egormeister02/Ultrasonic-LNS/diploma_final_hardware.md

# Финальная аппаратная конфигурация системы УЗ навигации БПЛА

Документ содержит итоговый вариант схемотехники с учётом закупленных компонентов. Данные предназначены для обновления соответствующих разделов дипломной работы.

---

## Закупленные компоненты

| # | Компонент | Корпус | Кол-во | Назначение |
|---|---|---|---|---|
| 1 | SN74HC4066N (TI) | DIP-14 | — | Аналоговые ключи (4 шт в корпусе), управление УЗ сигналом и активным гашением |
| 2 | LM311P (TI) | DIP-8 | — | Компаратор с гистерезисом для детектора ToF |
| 3 | INA128P (TI) | DIP-8 | 2 | Инструментальный ОУ, предусилитель сигнала с пьезоприёмника, ×50 |
| 4 | (дубликат INA128P) | DIP-8 | — | — |
| 5 | Электролит 10 мкФ × 35В | THT 5×7 мм | — | Развязка по питанию шин ±12В на якорях |
| 6 | Электролит 100 мкФ × 35В | THT 6.3×12 мм | — | Входной фильтр питания на якоре |
| 7 | EC24-100K | THT аксиальный | — | Дроссель 10 мкГн ±10%, выходные LC фильтры после DC-DC |
| 8 | EC24-101K | THT аксиальный | — | Дроссель 100 мкГн ±10%, входной LC фильтр |
| 9 | Д9Б | THT | — | Германиевый диод для детектора огибающей (низкое падение ~0.2В) |
| 10 | A2412S-2WR3 (Mornsun) | модуль | — | Изолированный DC-DC: вход 21.6–26.4В → выход ±12В, 83 мА на шину, 2 Вт |
| 11 | DWM1000 | модуль | 2 | UWB трансивер (один на БПЛА, один на земле) — синхронизация с таймстампом 15 пс |
| 12 | Керамика 100 нФ | THT/SMD | 40 | Развязка по питанию микросхем + ВЧ фильтрация |
| 13 | Ферритовое кольцо | — | 4 | По одному на якорь, на провод 24В для подавления ВЧ помех от инверторов |

**Изменения относительно предыдущих обсуждений:**
- Вместо голого DW1000 выбран модуль **DWM1000** — после проверки выяснилось что GPIO5/EXTTXE в нём выведен на внешние контакты, что делает голый чип ненужным
- Выбран **A2412S-2WR3** (2 Вт версия) — даёт запас по току 83 мА на каждую шину
- Компаратор **LM311** (200 нс) вместо обсуждавшегося LM393 (1.3 мкс) — лучше быстродействие
- Германиевый **Д9Б** для детектора огибающей — падение 0.2В против 0.6В у кремниевого

---

## Архитектура системы — итог

### Узел БПЛА
ESP32 генерирует УЗ сигнал 25 кГц с OOK модуляцией. DWM1000 обеспечивает синхронизацию с землёй: пин **GPIO5/EXTTXE** аппаратно открывает аналоговый ключ на путь УЗ сигнала к драйверу. Джиттер синхронизации между UWB пакетом и началом УЗ импульса < 10 нс.

### Узел земли (центральный)
ESP32 с DWM1000 принимает синхросигнал, фиксирует таймстамп с точностью 15 пс. Через проводные линии получает сигналы от 4 якорей-приёмников. Вычисляет координаты БПЛА методом трилатерации.

### Якоря (4 шт)
Каждый якорь — независимая плата с пьезоприёмником, усилителем, детектором огибающей и компаратором. Питание подаётся по экранированному кабелю с центрального узла.

---

## Узел БПЛА — финальная схема

### Цепь генерации и излучения

```
ESP32 GPIO (25 кГц непрерывно, OOK биты)
       │
       ├──→ Логика управления ключами (на базе SN74HC4066)
       │
       │   Ключ 1: пропускает 25 кГц на вход A драйвера во время бита 1
       │   Ключ 2: закорачивает вход B драйвера на GND во время бита 0
       │           (активное гашение остаточных колебаний пьезо)
       │
       │   Общее разрешение обоих ключей: EXTTXE от DWM1000
       │
       └──→ Драйвер TC4427A
              │
              └──→ УЗ излучатель MA40S4S (25 кГц)

DWM1000
   ├── SPI ←── ESP32 (конфигурация Delayed TX)
   ├── GPIO5/EXTTXE ──→ разрешающий сигнал для SN74HC4066
   └── UWB антенна (встроена) ──→ синхросигнал к земле
```

### Логика управления ключами SN74HC4066

В корпусе четыре ключа, используются два:

- **Ключ 1** управляющий вход = (EXTTXE) AND (бит_OOK)  → пропускает 25 кГц
- **Ключ 2** управляющий вход = (EXTTXE) AND (NOT бит_OOK) → закорачивает излучатель на GND во время бита 0

Реализация AND/NOT: либо отдельной логикой (74HC08, 74HC04), либо вычислением сигнала программно в ESP32 и подачей готового сигнала на управляющий вход.

Подтяжка управляющих входов неиспользуемых ключей 3 и 4 к GND через резисторы 10 кОм — гарантия закрытого состояния.

### Развязка по питанию узла БПЛА

- **100 нФ керамика** возле каждой ИС (ESP32, DWM1000, SN74HC4066, TC4427A) на каждой шине питания
- **Электролит 10 мкФ** на 3.3В шине рядом с ESP32 и DWM1000

---

## Узел якоря — финальная схема питания

### Входная цепь

Экранированный кабель от центра несёт +24В и общую землю. Экран кабеля заземляется только на стороне центра (одностороннее заземление — исключает земляные петли).

```
+24В ──→ Ферритовое кольцо (2-3 витка провода) ──→ EC24-101K (100 мкГн)
                                                          │
                                                  ┌───────┴───────┐
                                                  │               │
                                            Электролит      Керамика
                                            100 мкФ × 35В   100 нФ
                                                  │               │
                                                  ┴               ┴
                                                 GND             GND
                                                  │
                                                  └──→ Вход +Vin DC-DC A2412S-2WR3
```

### Изолированный DC-DC A2412S-2WR3

Параметры модуля:
- Вход: **21.6–26.4 В DC** (номинал 24В)
- Выход: **±12 В DC**, **83 мА** на каждую шину (всего 2 Вт)
- Изоляция: **1500 В DC** между входом и выходом
- Назначение: гальваническая развязка усилителя от шины питания платформы (защита от наводок 400В дизель-генератора и инверторов)

### Выходные LC фильтры после DC-DC

Назначение — подавить собственный коммутационный шум DC-DC (~100 кГц).

**На шине +12В:**
```
+12В выход DC-DC → EC24-100K (10 мкГн) → +12В на ОУ
                                              │
                                       ┌──────┴──────┐
                                       │             │
                                 10 мкФ × 35В   100 нФ
                                       │             │
                                       ┴             ┴
                                  GND_изол       GND_изол
```

**На шине −12В:**
Аналогично, но электролит 10 мкФ ставится с инвертированной полярностью (плюс к GND, минус к шине −12В).

### Развязка по питанию каждой ИС якоря

На якоре расположены: 1× INA128, 2× TL072, 1× LM311, плюс детектор огибающей (пассивный).

**INA128 + 2× TL072 (питание ±12В):**
- 100 нФ керамика между +12В и GND_изол — рядом с пинами 7 (V+) каждой ИС
- 100 нФ керамика между −12В и GND_изол — рядом с пинами 4 (V−) каждой ИС
- Итого 6 керамик на развязку аналоговой части

**LM311 (питание +5В):**
- 100 нФ керамика между +5В и GND_лог рядом с пином 8

### Земля якоря — топология

Две изолированные земли:
- **GND_изол** — выходная земля DC-DC, общая для INA128 и обоих TL072
- **GND_лог** — земля логической части (компаратор LM311 и линия передачи в центр), питание от отдельного линейного стабилизатора 7805

Соединение: GND_изол и GND_лог соединяются **в одной точке** рядом с компаратором (звёздная топология). Эта точка соединяется с GND центра одним проводом.

Цель: исключить замкнутые контуры по земле через которые могут течь паразитные токи.

### Стабилизатор +5В для логики

7805 от шины +24В (та же что идёт на DC-DC). На якоре питает только LM311 и опционально дифференциальный передатчик линии связи с центром.

---

## Усилитель приёмника — компонентная схема

### Каскад 1: предусилитель INA128P

Инструментальный ОУ с настраиваемым коэффициентом усиления. Коэффициент задаётся одним внешним резистором RG между пинами 1 и 8:

**G = 1 + 50000/RG**

Для G = 50: RG = 50000/49 = **1.02 кОм** (стандартный 1 кОм даёт G = 51).

Питание ±12В, развязочные керамики 100 нФ на пинах 4 и 7. Опорный пин 5 (REF) на GND_изол.

### Каскад 2 и 3: усилители на TL072

Два каскада, каждый на одном из ОУ внутри TL072 (в корпусе 2 ОУ). Коэффициент каждого ×10. На входах RC фильтры:

- Каскад 2: RC ФНЧ ~23 кГц (граничная частота ниже 25 кГц)
- Каскад 3: RC ФВЧ ~27 кГц (граничная частота выше 25 кГц)

Совместно они образуют грубый полосовой фильтр на 25 кГц. Реальное усиление каждого каскада с учётом потерь в фильтре ~×5. Суммарное усиление цепи: 50 × 5 × 5 = ×1250 (~62 дБ).

### Детектор огибающей

После усилителя:
```
Выход TL072 ──→ Д9Б (анод к выходу) ──→ узел детектирования
                                              │
                                       ┌──────┴──────┐
                                       │             │
                                  R = 10 кОм    C = 1 нФ
                                       │             │
                                       ┴             ┴
                                  GND_изол      GND_изол
```

Постоянная времени τ = RC = 10 мкс — оптимальна для частоты 25 кГц (период 40 мкс). Огибающая следует за реальным нарастанием сигнала ~0.2 мс без размытия.

Использование Д9Б (германий) даёт падение всего ~0.2В против 0.6В у кремниевого диода — выигрыш чувствительности на слабых сигналах.

### Компаратор LM311P с гистерезисом

Подключение по схеме инвертирующего компаратора с гистерезисом:
- Инвертирующий вход (пин 2): сигнал с детектора огибающей
- Неинвертирующий вход (пин 3): опорное напряжение через делитель + резистор гистерезиса с выхода
- Выход (пин 7): открытый коллектор, нужен pull-up 4.7 кОм на +5В
- Питание: +5В на пине 8, −12В или GND на пине 4 (LM311 работает с однополярным 5В)

Гистерезис ~5–10 мВ создаётся резистором обратной связи ~1 МОм с выхода (пин 7) на неинвертирующий вход (пин 3).

Порог срабатывания — 10–20% от максимальной амплитуды огибающей. Подбирается экспериментально для каждого якоря.

---

## Цепь от компаратора до центрального узла ESP32

Сигнал с компаратора передаётся в центр одним из двух способов:

**Простой:** прямая передача по экранированному кабелю если расстояние небольшое.

**Помехоустойчивый:** дифференциальный передатчик (например AM26C31 или транзисторная пара) → витая пара → дифференциальный приёмник на стороне центра. Подавление синфазных наводок 60–80 дБ.

Центральный ESP32 фиксирует таймстамп прихода сигнала от каждого якоря по фронту. Использовать GPIO в режиме прерывания на Core 1 (выделенное ядро).

---

## Параметры и характеристики системы (по результатам испытаний)

- **Дальность УЗ канала:** не менее 34 м (испытано в коридоре 2×3 м — наихудший акустический случай с многократными переотражениями)
- **Сигнал на выходе усилителя при 34 м:** 1–2 В (питание ±12В даёт достаточный размах)
- **Время нарастания фронта:** ~0.2 мс
- **Время затухания с переотражениями:** 10–15 мс (определяет минимальный период между измерениями)
- **Максимальная частота измерений:** 60–100 Гц (на открытом пространстве ожидается выше)
- **Точность таймстампа UWB синхросигнала:** 15 пс (DWM1000)
- **Джиттер синхронизации УЗ ↔ UWB:** < 10 нс (за счёт аппаратного управления EXTTXE)
- **Точность ToF, ограниченная джиттером:** < 0.3 мм (на порядки лучше чем точность по фронту)
- **Точность позиционирования в плане:** определяется GDOP геометрии якорей и точностью детектирования фронта (~7 см для одиночного измерения), может быть улучшена усреднением

---

## Ключевые проектные решения

### 1. Аппаратная синхронизация через EXTTXE
ESP32 не способен с наносекундной точностью одновременно стартовать УЗ генератор и UWB передачу — между двумя командами всегда есть программный джиттер 1–5 мкс. Решение: ESP32 предварительно настраивает DWM1000 на Delayed TX, в нужный момент DWM1000 сам аппаратно поднимает EXTTXE, который через SN74HC4066 открывает путь УЗ сигнала. Момент старта УЗ и момент UWB передачи жёстко связаны железом.

### 2. Активное гашение пьезоизлучателя
Пьезо имеет высокую механическую добротность — после прекращения возбуждения колеблется ~400 мкс. Это создаёт мёртвую зону и ухудшает разделение бит OOK. Решение: во время бита 0 закорачивать излучатель через драйвер (один канал TC4427A в высоком импедансе, второй замыкает на GND). Реализуется вторым ключом SN74HC4066.

### 3. Изолированный DC-DC на якорях
Платформа имеет 400В дизель-генератор и инверторы — мощные источники широкополосных наводок. Длинные провода до якорей работают как антенны для этих наводок. Решение: изолированный DC-DC A2412S-2WR3 на каждом якоре полностью развязывает аналоговую землю усилителя от шины питания платформы. Изоляция 1500В отсекает наводки гальванически — это качественно надёжнее любой фильтрации.

### 4. Детектор переднего фронта огибающей
Прямое детектирование начала УЗ сигнала затруднено его плавным нарастанием и маскированием шумом. Эхо приходит позже (через несколько мс) и должно игнорироваться. Решение: полосовой фильтр 25 кГц → детектор огибающей (Д9Б + RC) → компаратор LM311 с гистерезисом по фиксированному порогу. Срабатывание происходит на переднем фронте огибающей — до прихода эхо. Систематическая ошибка от зависимости порога от расстояния калибруется и в GDOP не входит.

### 5. Двухкаскадная развязка питания
Помехоустойчивость обеспечивается на двух уровнях:
- **Грубый уровень** — феррит + LC фильтр на входе 24В якоря
- **Изоляция** — DC-DC A2412S-2WR3 (главная защита)
- **Точная фильтрация** — LC фильтры на выходах ±12В после DC-DC
- **Локальная** — керамика 100 нФ возле каждой ИС

---

## Результаты лабораторных испытаний и применимость

В лабораторных условиях (без генератора, без длинных кабелей) система продемонстрировала уверенный приём УЗ сигнала на дистанции 34 м в неблагоприятных акустических условиях коридора-волновода 2×3 м. Амплитуда сигнала после усилителя 1–2 В обеспечивает надёжное срабатывание компаратора с большим запасом по соотношению сигнал/шум.

В полевых условиях с дизель-генератором ожидается некоторое ухудшение из-за электромагнитных наводок, но выбранная архитектура питания с изолированным DC-DC и многоуровневой фильтрацией спроектирована именно под эти условия. Дополнительная отладка может потребоваться в части подбора порога компаратора и проверки эффективности экранирования сигнальных линий.
