egormeister02/Ultrasonic-LNS/images/damper_555.pdf

+5 В

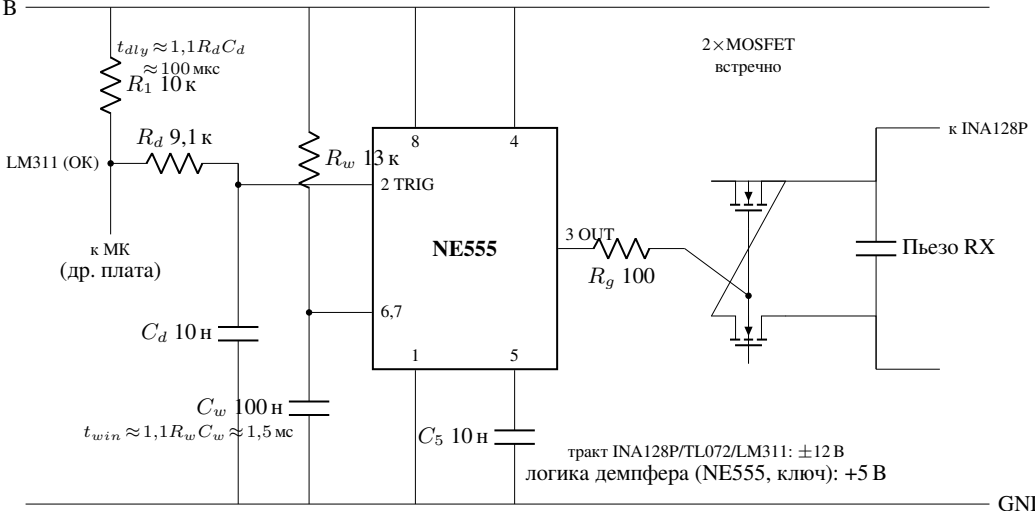
[picture p7: figure]
к МК (др. плата); tdly ≈1,1RdCd ≈100 мкс; 2 TRIG; 3 OUT; twin ≈1,1RwCw ≈1,5 мс; 2×MOSFET; встречно; Пьезо RX; к INA128P; тракт INA128P/TL072/LM311: ±12 В логика демпфера (NE555, ключ): +5 В

## GND
