egormeister02/Ultrasonic-LNS/include/title-page.tex

\begin{center}
    %% *название института*
    \large\textbf{Министерство науки и высшего образования Российской Федерации\\
    Московский физико-технический институт\\
    (национальный исследовательский университет)} \\
    \vspace{1cm}

    %% *факультет/физтех-школа*
    Физтех-школа радиотехники и компьютерных технологий \\

    %% *название базовой кафедры и лаборатории*
    Лаборатория № 69 «Разработка теоретических основ и методов\\
    практической реализации локальных навигационных систем\\
    привязных высотных беспилотных платформ»\\

    \vspace{3em}

    Выпускная квалификационная работа бакалавра
\end{center}

\begin{center}
    \vspace{\fill}
    %% *название вашей работы*
    \LARGE{\input{include/work-title.tex}}

    \vspace{\fill}
\end{center}

\begin{flushright}
    \textbf{Автор:} \\
    Студент группы \underline{\hspace{2.5cm}} \\ % TODO: укажите номер группы
    Смирнов Егор Ильич \\
    \vspace{2em}
    \textbf{Научный руководитель:} \\
    д.\,т.\,н., профессор \\
    Вишневский Владимир Миронович \\
\end{flushright}

\vspace{7em}

\begin{center}
    %% *лого*
    \\
    Москва \the\year{}
\end{center}

%% выключаем отображение номера для этой страницы (титульник)
\thispagestyle{empty}
