egormeister02/Ultrasonic-LNS/include/work-title.tex

% Единое место для указания названия работы
Ультразвуковая локальная навигационная система для привязного беспилотного летательного аппарата
