egormeister02/Ultrasonic-LNS/main.pdf

Федеральное государственное автономное образовательное учреждение высшего образования
«Московский физико-технический институт (национальный исследовательский университет)» Физтех-школа Радиотехники и Компьютерных Технологий Кафедра инфокоммуникационных систем и сетей

Направление подготовки / специальность: 03.03.01 Прикладные математика и физика Направленность (профиль) подготовки: Радиотехника и компьютерные технологии

СРАВНИТЕЛЬНЫЙ АНАЛИЗ ВАРИАНТОВ ПОСТРОЕНИЯ ЛОКАЛЬНОЙ НАВИГАЦИОННОЙ СИСТЕМЫ ПРИВЯЗНЫХ ВЫСОТНЫХ БЕСПИЛОТНЫХ ТЕЛЕКОММУНИКАЦИОННЫХ ПЛАТФОРМ

(бакалаврская работа)

Студент:
Смирнов Егор Ильич

_________________________
(подпись студента)

Научный руководитель:
Вишневский Владимир Миронович, д-р техн. наук, проф.

_________________________
(подпись научного руководителя)

Консультант (при наличии): _________________________
_________________________
(подпись консультанта)

Москва 2026

Powered by TCPDF (www.tcpdf.org)

Ультразвуковая локальная навигационная система для привязного беспилотного летательного аппарата

Смирнов Егор Ильич

Аннотация

В работе разработана ультразвуковая локальная навигационная система для определения координат привязного беспилотного летательного аппарата (БПЛА) относительно наземной платформы (в том числе подвижной) в условиях недоступности или ненадёжности глобальных навигационных спутниковых систем. Расстояния до опорных узлов (якорей) измеряются по времени распространения ультразвукового сигнала; временная синхронизация передающей и приёмной сторон выполняется по сверхширокополосному (UWB) радиоканалу, а координаты восстанавливаются методом трилатерации.
Построена математическая модель системы: оценены максимальная дальность работы, погрешность определения скорости звука во влажном воздухе, влияние геометрии якорей (GDOP) и проведён сравнительный анализ аналитического метода трилатерации и метода Гаусса–Ньютона. Разработана и собрана аппаратная часть: передающий узел БПЛА (ESP32-S3 + DWM1000 с аппаратной синхронизацией по сигналу EXTTXE), тракт обработки сигнала якоря (INA128P, TL072CN, детектор огибающей, компаратор LM311P) и изолированная система питания с защитой от наводок; реализован двухимпульсный метод самокалибровки времени прихода. Экспериментально подтверждён уверенный приём на дистанции ≈34 м; расчётная погрешность позиционирования — порядка 5 см.

Abstract

This work develops an ultrasonic local navigation system that estimates the position of a tethered unmanned aerial vehicle (UAV) relative to a (possibly mobile) ground platform under conditions where global navigation satellite systems are unavailable or unreliable. Distances to reference nodes (anchors) are measured from the time of flight of an ultrasonic signal; the transmitter and receiver are time-synchronized over an ultra-wideband (UWB) radio link, and the position is recovered by trilateration.
A mathematical model of the system is built: the maximum operating range, the error of the speed-of-sound estimate in humid air, and the influence of anchor geometry (GDOP) are evaluated, and an analytic trilateration method is compared with the Gauss–Newton method. The hardware is designed and assembled: the UAV transmitter node (ESP32-S3 + DWM1000 with hardware EXTTXE synchronization), the anchor signal-processing chain (INA128P, TL072CN, envelope detector, LM311P comparator) and an isolated, interference-protected power supply; a twopulse time-of-arrival self-calibration method is implemented. Reliable reception at ≈34 m is confirmed experimentally; the estimated positioning error is on the order of 5 cm.

Содержание

1 Введение | 6
2 Постановка задачи | 8
3 Обзор существующих решений | 10
4 Исследование и построение решения задачи | 15
4.4.1 | Аналитическое решение задачи трилатерации в про-
5 Описание практической части | 33
5.1.3 | Управление мостом и активное гашение пьезоизлучателя 36

5.2.4 | Самокалибровка времени прихода: двухимпульсный
5.2.5 | Бюджет случайной ошибки измерения дальности . . . | 43
5.3.1 | Изолированный преобразователь A2412S-2WR3 . . . . | 45
5.5 Результаты экспериментальной проверки приёмного тракта . . | 50
6 Заключение | 51

### 1 Введение

Надёжная локальная навигация является одним из ключевых условий безопасной и устойчивой работы беспилотных летательных аппаратов (БПЛА) в стеснённых пространствах и в условиях ухудшенного или отсутствующего приёма сигналов глобальных навигационных спутниковых систем (GNSS, в том числе ГЛОНАСС). Даже в случае привязного летательного аппарата, когда полёт механически ограничен тросом, задача точного и быстрого определения координат остаётся критичной: она необходима для стабилизации и компенсации внешних возмущений (ветер, натяжение троса), а также для реализации режимов удержания позиции и сопровождения объектов. Это особенно важно для БПЛА, несущих на себе телекоммуникационное оборудование: область покрытия и возможность передачи сигнала напрямую зависят от положения летательного аппарата [1].
На практике применяются различные подходы к локализации БПЛА: спутниковая навигация (в том числе дифференциальные и RTK-решения), визуальные и визуально-инерциальные методы, лидарная одометрия, инфраструктурные системы захвата движения. Каждый из них имеет свою область применимости и свои ограничения; подробное сравнение этих подходов применительно к рассматриваемой задаче приведено в разделе 3. Ультразвуковая навигация представляет собой привлекательный вариант для задач ближнего радиуса действия благодаря низкой стоимости, малому энергопотреблению и доступности компактных излучателей и приёмников. В таких системах положение объекта оценивается по времени распространения акустического сигнала между передатчиками и приёмниками с последующим пересчётом временных измерений в расстояния на основе величины скорости звука. В зависимости от архитектуры могут применяться схемы измерения времени распространения сигнала (ToF — от англ. Time of Flight), разности времён прихода (TDoA — от англ. Time Difference of Arrival) или их комбинации с геометрическими методами трилатерации и мультилатерации. В отличие от чисто бортовых методов измерения, ультразвуковые системы позволяют опираться на внешние опорные узлы (якоря) и могут сохранять работоспособность даже в тех условиях, где оптика даёт сбои. Вместе с тем ультразвуковое позиционирование имеет ограничения: сравнительно малую дальность и чувствительность к отражениям сигнала от поверхностей.

В настоящей работе рассматривается задача локальной навигации привязного БПЛА относительно платформы (в том числе потенциально подвижной) с использованием ультразвуковых измерений в качестве основного источника координатной информации. Ставится цель разработать систему, пригодную для практической реализации, обосновать её основные параметры математической моделью и подтвердить работоспособность экспериментально.

### 2 Постановка задачи

### 2.1 Объект и цель

Рассматривается привязной БПЛА, удерживаемый тросом над наземной платформой. Платформа может быть как стационарной, так и подвижной, поэтому положение аппарата требуется определять в системе координат, связанной с платформой. Целью работы является разработка локальной навигационной системы, которая в реальном времени определяет трёхмерные координаты БПЛА относительно платформы по ультразвуковым измерениям и сохраняет работоспособность в условиях, где спутниковая навигация недоступна или ненадёжна.
Формально требуется по набору измерений построить оценку вектора координат p = (x,y,z) аппарата в платформенной системе отсчёта, обеспечив заданные дальность, точность и частоту обновления оценки.

### 2.2 Требования к системе

На основе условий эксплуатации сформулированы следующие требования к разрабатываемой системе.

1. Принцип измерения. Координаты определяются по расстояниям от аппарата до нескольких опорных узлов (якорей) с известной геометрией; расстояния вычисляются по времени распространения ультразвукового сигнала. Это требует общей шкалы времени для передающей и приёмной сторон, то есть синхронизации.
2. Рабочая дальность. Целевая дальность измерений — 40–50 м между аппаратом и якорями; протокол синхронизации проектируется с запасом — на дистанции до 100 м.
3. Точность. Требуемая погрешность определения координат — порядка единиц сантиметров, что достаточно для стабилизации аппарата и удержания позиции.
4. Частота обновления. Темп выдачи координат должен соответствовать динамике аппарата; для привязного БПЛА с ограниченной скоростью движения достаточно частоты порядка 10 Гц, при этом приёмный тракт не должен ограничивать эту величину.
5. Условия эксплуатации. Система работает в зоне прямой видимости якорей, в том числе в стеснённых пространствах с многократными переотражениями сигнала, и в непосредственной близости от силового оборудования платформы (дизельный электрогенератор, инверторы 400 В), создающего сильные электромагнитные помехи. Требуется устойчивость к переотражениям и к наводкам по цепям питания и сигнальным линиям.
6. Подвижность платформы. При возможных наклонах платформы система должна позволять пересчёт координат с учётом её ориентации (наличие инерциального датчика на платформе).
7. Стоимость и энергопотребление. Решение должно строиться на доступной и недорогой элементной базе с малым энергопотреблением и не требовать развёртывания дорогостоящей внешней инфраструктуры.

Перечисленные требования служат критериями при оценке существующих решений (раздел 3) и при построении предлагаемой системы (раздел 4).

### 3 Обзор существующих решений

Ниже рассмотрены основные подходы к локализации БПЛА и оценивается степень их соответствия требованиям, сформулированным в разделе 2: работоспособность в отсутствие GNSS, сантиметровая точность на дистанциях в десятки метров, низкая стоимость и независимость от дорогостоящей инфраструктуры.

### 3.1 Спутниковая навигация (GNSS, RTK)

Спутниковые системы (GPS, ГЛОНАСС и др.), в том числе дифференциальные и RTK-решения, обеспечивают абсолютные координаты на открытой местности и при хорошей видимости созвездия дают сантиметровую точность [2, 3]. Однако их точность и доступность существенно снижаются вблизи сооружений, внутри помещений, в городской застройке и при загрязнённом радиоэфире — то есть именно в тех условиях, для которых разрабатывается рассматриваемая система. Кроме того, GNSS определяет координаты в глобальной системе отсчёта, тогда как для привязного аппарата требуется положение относительно платформы, которая сама может перемещаться. Поэтому спутниковая навигация не удовлетворяет требованию работы в условиях недоступности GNSS и плохо подходит для относительной локализации.

### 3.2 Визуальные и визуально-инерциальные методы

Оптический поток, визуальная одометрия и визуально-инерциальные системы (VIO) способны обеспечивать высокую точность относительного позиционирования [4]. Их недостатки — зависимость от освещённости, текстуры сцены и динамики окружения, а также значительные вычислительные затраты, что затруднительно для бортового оборудования БПЛА с ограниченным энергобюджетом. В однородных или слабоосвещённых сценах точность резко падает. Эти методы дополняют, но не заменяют систему внешних маяков, когда требуется гарантированная точность относительно платформы.

### 3.3 Лидарная одометрия

Лидарная одометрия отличается высокой информативностью и точностью построения карты [5], однако чувствительна к погодным условиям (туман, осадки, пыль), требует дорогостоящего датчика и существенных вычислительных ресурсов, а также наличия геометрических особенностей в сцене. Для лёгкого привязного аппарата масса, стоимость и энергопотребление лидара являются серьёзными ограничениями.

### 3.4 Системы захвата движения (motion capture)

Инфраструктурные системы захвата движения обеспечивают субмиллиметровую точность [6], но применимы только в специально оборудованных зонах, требуют развёртывания сети камер и калибровки и потому неприменимы в полевых условиях и противоречат требованию независимости от дорогостоящей инфраструктуры.

### 3.5 Радиочастотная дальнометрия (UWB)

Сверхширокополосные (UWB) радиосистемы позволяют измерять расстояния по времени распространения радиосигнала и широко используются для локализации внутри помещений [7]. Их точность — порядка единиц– десятков сантиметров, что само по себе близко к требуемой. Однако высокая скорость распространения радиоволн предъявляет крайне жёсткие требования к разрешению измерения времени (пикосекундный масштаб): ошибка в 1 нс соответствует ∼30 см дальности. При этом, как показано ниже, радиоканал оказывается исключительно полезен не как измеритель дальности, а как средство синхронизации ультразвуковой подсистемы.

### 3.6 Ультразвуковое позиционирование

В ультразвуковых системах расстояние определяется по времени распространения акустического сигнала. Низкая скорость звука (∼340 м/с против скорости света) на пять с лишним порядков снижает требования к точности измерения времени: для миллиметрового разрешения по дальности достаточно измерять время с точностью порядка единиц микросекунд, что доступно недорогим микроконтроллерам. Известны как схемы измерения времени пролёта (ToF), так и схемы разности времён прихода (TDoA), для которых существуют эффективные методы решения задачи локализации [8, 9]. Ультразвуковые излучатели и приёмники компактны, дёшевы и энергоэффективны. Ограничения метода — сравнительно малая дальность и чувствительность к переотражениям — управляемы при работе в зоне прямой видимости и временном кодировании сигнала.

### 3.7 Вывод

Сопоставление подходов с требованиями раздела 2 показывает, что наилучшим компромиссом для относительной локализации привязного БПЛА в GNSS-недоступной среде является ультразвуковое измерение дальности (низкая стоимость, малое энергопотребление, умеренные требования к измерению времени, сантиметровая точность на нужных дистанциях). Ключевая трудность ультразвуковой ToF-схемы — необходимость общей шкалы времени передатчика и приёмника — решается синхронизацией по UWB-радиоканалу, который обеспечивает точную временную привязку без жёстких требований к собственно радиочастотной дальнометрии. Именно такая архитектура — ультразвуковая дальнометрия с радиочастотной синхронизацией — положена в основу предлагаемого решения (раздел 4).

### 3.8 Существующие ультразвуковые системы локализации

Сделанный выше выбор в пользу ультразвукового измерения дальности делает уместным обзор существующих ультразвуковых систем локализации и сопоставление с ними предлагаемого решения. Ультразвуковая локализация изучается и применяется не одно десятилетие; систематический обзор технологий внутреннего позиционирования приведён, например, в [10]. Ниже рассмотрены три показательные системы — две исследовательские и одна коммерческая.
Active Bat (AT&T Laboratories Cambridge) [11] использует подвижную метку-излучатель и сетку ультразвуковых приёмников на потолке: по временам пролёта сигнала до приёмников методом мультилатерации вычисляется трёхмерное положение с точностью около 3 см (в 95% измерений ошибка не превышает 9 см). Запуск измерения и временная привязка выполняются по отдельному радиоканалу. Система точна, но требует плотной потолочной инфраструктуры приёмников и ограничена объёмом помещения.
Cricket (MIT) [12] строится на маяках, одновременно излучающих радио- и ультразвуковой импульс; приёмник определяет расстояние до маяка по разности времён прихода этих сигналов. Архитектура децентрализована — положение вычисляет сам приёмник; точность составляет единицы сантиметров на дистанции в несколько метров, дальность одного маяка — единицы метров. Система распространялась как относительно открытая платформа, но давно не развивается.
Коммерческие системы. Среди серийных решений наиболее известна Marvelmind Robotics [13]: стационарные ультразвуковые маяки, объединённые радиоканалом диапазона 868/915 МГц, с заявленной точностью порядка ±2 см и рабочими дистанциями между маяками до ∼30 м. Применяются и другие проприетарные системы позиционирования реального времени (Sonitor, Hexamite). Коммерческие системы — законченные продукты с многолетней эксплуатацией, однако их внутренняя реализация (алгоритмы дальнометрии, обработки сигнала и синхронизации) закрыта.

Таблица 1: Сравнение ультразвуковых систем локализации

Система | Точность | Дальность | Синхр. | Реализация
Active Bat | ∼3 см | помещение | радио | прототип
Cricket | ∼2 см | единицы м | РЧ + УЗ | открытая (устар.)
Marvelmind | ±2 см | до ∼30 м | 868/915 МГц | закрытая
Данная работа ∼5 см (расч.) | до ∼40 м | UWB | открытая

Перечисленные системы ориентированы преимущественно на работу внутри помещений и опираются на распределённую по среде инфраструктуру маяков или приёмников, достигая сантиметровой точности (сводка — таблица 1). Рассматриваемая в настоящей работе задача отличается сценарием: относительная навигация привязного БПЛА над компактной (потенциально подвижной) платформой на дистанциях в десятки метров, причём все якоря размещены на самой платформе, а не разнесены по среде. Компактная база якорей повышает геометрическое ослабление точности (GDOP, см. раздел 4), поэтому расчётная точность положения (∼5 см) несколько уступает сантиметровому уровню инфраструктурных систем — это плата за отказ от стационарной инфраструктуры. Вклад работы носит инженерный характер: открытая, воспроизводимая реализация (схемотехника, прошивка, математическая модель) для указанного сценария, с синхронизацией ультразвуковой подсистемы по UWB-радиоканалу. Превосходства над существующими системами по точности работа не предполагает.

### 4 Исследование и построение решения задачи

### 4.1 Архитектура предлагаемого решения

Рассматриваемая система состоит из привязного БПЛА и наземной платформы, на которой размещается ультразвуковая опорная подсистема. Платформа может быть стационарной или мобильной, поэтому все измерения и вычисления выполняются в системе координат, связанной с платформой, а при необходимости учитываются её наклоны.
В базовой конфигурации на платформе устанавливаются несколько ультразвуковых опорных узлов (далее — якоря), разнесённых на максимально возможное расстояние друг от друга. Геометрия якорей считается известной: координаты каждого якоря заранее задаются в системе координат платформы. В принятой конфигурации ультразвуковой излучатель размещается на БПЛА, а якоря служат приёмниками; излучатель ориентирован в сторону платформы и работает в зоне прямой видимости опорных узлов.


Рис. 1: Общая схема системы локальной навигации привязного БПЛА относительно платформы

Принцип работы системы следующий. Опорные узлы на платформе и бортовой узел на БПЛА формируют набор измерений времени распространения акустических импульсов. По измеренным временам вычисляются расстояния до якорей, после чего координаты БПЛА определяются методом трилатерации в системе координат платформы.
Для получения корректных расстояний требуется синхронизация времени между передающей и принимающей сторонами. В привязном варианте синхронизирующий сигнал может быть передан по кабелю-тросу; в настоящей работе применяется радиосинхронизация по UWB-каналу (раздел 5).
Если платформа подвержена наклонам, на ней размещается инерциальный датчик (например, акселерометр/IMU), позволяющий оценивать ориентацию платформы относительно горизонта и при необходимости пересчитывать координаты из платформенной системы координат в требуемую внешнюю систему отсчёта.
Дальнейшие подразделы строят математическую модель системы: оценивают предельную дальность, погрешность измерения расстояния и координат, а также сравнивают методы решения задачи трилатерации.

### 4.2 Максимальная дальность работы

Под дальностью работы нужно понимать максимальное расстояние между излучателем и приёмником, при котором приёмник может стабильно детектировать сигнал. Это расстояние зависит от нескольких факторов:

- мощность излучателя;
- чувствительность приёмника;
- уровень шума в среде;
- затухание звукового сигнала в среде.

Остановимся подробнее на затухании звука. Интенсивность звука убывает с расстоянием как

I(x) = I0 · 10⁻αx/10
, | (1)

где α — коэффициент затухания, дБ/м.

Согласно стандарту ISO 9613-1:1993 [14], коэффициент затухания рассчитывается по формуле

α = 8.686 · f

2
·

[︃
1.84 · 10⁻¹¹
·

pr
pa

·

(︂
T
Tr

)︂0.5

+

(︂
T
Tr

)︂−2.5
·

(︃
0.01275 · e

−2239.1/T

fr,O +

f

2

fr,O

+

0.1068 · e

−3352.0/T

fr,N +

f

2

fr,N

)︃ ]︃

(2)
где:
- α — коэффициент затухания, дБ/м;
- f — частота звука, Гц;
- pa — атмосферное давление, кПа;
- pr = 101.325 кПа — опорное давление;
- T — температура воздуха, К;
- Tr = 293.15 К — опорная температура;
- fr,O — частота релаксации кислорода, Гц;
- fr,N — частота релаксации азота, Гц.

Частоты релаксации рассчитываются по формулам

fr,O =

pa
pr

(︂
24 + 4.04 · 10⁴ℎ

0.02 + ℎ
0.391 + ℎ

)︂
, | (3)

fr,N =

pa
pr

(︂
T
Tr

)︂−1/2

(︃

9 + 280 · ℎ · exp (︃

−4.170 [︃(︂
T
Tr

)︂−1/3
− 1

]︃)︃)︃ , (4)

где ℎ — молярная концентрация водяного пара:

ℎ = ℎr ·

psat
pa
. | (5)

Здесь ℎr — относительная влажность, psat — давление насыщенного пара, которое рассчитывается по формуле

psat = pr · 10⁻⁶.8346·(

T01
T )

1.261
+4.6151
, | (6)

где T01 = 273.16 К — температура тройной точки воды.
По формуле (2) видно, что коэффициент затухания прямо пропорционален квадрату частоты f. Поэтому для обеспечения максимальной дальности частоту необходимо выбирать как можно ниже.
Для текущей системы была выбрана частота 25 кГц: она достаточно низкая для обеспечения дальности и при этом находится вне слышимого диапазона.
Расчёт для этой частоты даёт максимальную дальность порядка 35 м (оценка по порядку величины). Вычисления производились при следующих параметрах:
- относительная влажность — 50%;
- температура воздуха — 20 ∘C;
- уровень звукового давления излучателя — 105 дБ (SPL — Sound Pressure Level, на расстоянии 1 м от источника);
- чувствительность УЗ-приёмника — −95 дБ.

Следует подчеркнуть, что это оценка по порядку величины: реальная дальность существенно зависит от конкретной реализации системы и внешних условий, а входные параметры (SPL, чувствительность) известны лишь приближённо. Протокол синхронизации (раздел 5.4) рассчитан с дополнительным запасом — на дистанции до 100 м.

### 4.3 Точность измерения расстояния

Расстояние от БПЛА до якоря измеряется следующим образом: в известный момент времени излучатель на БПЛА испускает сигнал. Спустя некоторое время приёмник на якоре его детектирует. Так как микроконтроллеры на излучателе и приёмнике синхронизированы, время, которое потребовалось для передачи сигнала, известно. Умножив его на скорость звука, получим искомое расстояние.
Значение мы получаем с определённой погрешностью; разобьём её на части (рис. 2).


Рис. 2: Ошибка при определении расстояния

### 4.3.1 Скорость звука

Для определения расстояния нам необходимо знать скорость звука. Именно ошибка при вычислении скорости вызывает систематическую ошибку в определении расстояний.
Скорость звука c в газе является термодинамической величиной. Для влажного воздуха в приближении идеальной газовой смеси её можно оценить по выражению

c =

√︀
γ Rmix T , | (7a)

Rmix =

R

Mmix

, | (7b)
Mmix = (1 − xv) Md + xv Mv, | (7c)

xv =

pv
p
, | (7d)
pv = ℎ psat(T), | (7e)
psat(T) = 611.21 exp(︂
17.502 (T − 273.15)
T − 32.19 | )︂
, | (7f)

γ =

cp,mix

cv,mix

=

cp,mix

cp,mix − Rmix

, | (7g)
cp,mix = (1 − xv) cp,d(T) + xv cp,v(T). | (7h)

Выражения (7) основаны на работе [15]. Здесь psat(T) вычисляется по формуле Тетенса в параметризации Бака [16], применимой в диапазоне −20 . . . 50 ∘C.

После подстановки всех промежуточных величин в (7) получается явное выражение c как функции трёх измеряемых параметров (T, p, ℎ):

c(T,p,ℎ) = √︃
cp,mix(T,p,ℎ) R T
Mmix(T,p,ℎ)

[︀
cp,mix(T,p,ℎ) − R/Mmix(T,p,ℎ)
]︀, | (8)

где мольная доля пара и производные от неё величины имеют вид

xv(T,p,ℎ) = ℎ psat(T)
p

,

Mmix(T,p,ℎ) = Md + xv(T,p,ℎ) (Mv − Md),

cp,mix(T,p,ℎ) = cp,d + xv(T,p,ℎ) (cp,v − cp,d),

cp,d ≈ 1005 J/(kg · K), cp,v ≈ 1850 J/(kg · K).

Обозначения, используемые в (7), приведены в табл. 2.

Таблица 2: Обозначения в модели скорости звука во влажном воздухе

Обозначение Значение | Единицы
c | скорость звука | м/с
T | абсолютная температура | K
p | общее давление | Pa
ℎ | относительная влажность (0 . . . 1) | –
xv | мольная доля водяного пара | –
pv | парциальное давление пара | Pa
psat(T) | давление насыщенного пара | Pa
R | универсальная газовая постоянная (8.314462618) J/(mol · K)
Md | молярная масса сухого воздуха (0.0289652) | kg/mol
Mv | молярная масса воды (0.01801528) | kg/mol
Mmix | молярная масса смеси | kg/mol
Rmix | удельная газовая постоянная смеси | J/(kg · K)
cp,d(T) | теплоёмкость сухого воздуха при p = const | J/(kg · K)
cp,v(T) | теплоёмкость водяного пара при p = const | J/(kg · K)
cp,mix | теплоёмкость смеси при p = const | J/(kg · K)
cv,mix | теплоёмкость смеси при V = const | J/(kg · K)
γ | показатель адиабаты смеси | –

Погрешность измерения параметров среды. Для расчёта скорости звука по формулам (7) требуются значения температуры T, давления p и относительной влажности ℎ. В реальной системе эти параметры измеряются датчиками, что вносит дополнительную погрешность в определение скорости звука.

В качестве датчика рассмотрим:

- BME280 [17] (температура, давление, влажность): погрешность температуры ±0.5

∘C, погрешность давления ±1.2 hPa (±120 Pa), погрешность

влажности ±3%.

Погрешность модели. Погрешность модели Δмод определяется совокупностью приближений, использованных при выводе формул (7). Рассмотрим составляющие:

1. Приближение идеального газа. Уравнения (7) основаны на модели идеального газа. Реальные свойства воздуха описываются вторыми вириальными коэффициентами. Согласно анализу Cramer [15], учёт нелинейности уравнения состояния вносит поправку порядка 10⁻⁴ (∼
0.03 м/с). Принимаем Δид ≈ 0.05 м/с с запасом.
2. Упрощение теплоёмкостей. В формулах (7) теплоёмкости cp,d и cp,v принимаются постоянными. На самом деле они зависят от температуры. При изменении температуры от 0 до 40 ∘C относительное изменение

cp,d составляет около 0.1%, что даёт погрешность скорости звука Δcp ≈ 0.3 м/с.

3. Формула Тетенса. Для расчёта давления насыщенного пара psat(T) используется формула Тетенса [16], применимая в диапазоне −20 . . . 50 ∘C

с относительной погрешностью менее 0.5%. Влияние на скорость звука незначительно: ΔТетенс ≈ 0.01 м/с.

4. Физические константы. Универсальная газовая постоянная R и молярные массы Md, Mv известны с точностью лучше 10⁻⁵
(CODATA), их
вклад пренебрежимо мал.

Полная погрешность модели по закону накопления погрешностей:

Δмод =

√︁
Δ²

ид + Δ²

cp + Δ²
Тетенс =

√︀
0.05² + 0.30² + 0.01² ≈ 0.31 m/s. (9)

Полная погрешность скорости звука. Погрешность определения c складывается из погрешностей измерения параметров и погрешности модели:

Δc =

√︃(︂
∂c
∂T ΔT

)︂2
+

(︂
∂c
∂pΔp

)︂2
+

(︂
∂c
∂ℎΔℎ

)︂2
+ Δ²
мод. | (10)

Для оценки частных производных при околонормальных условиях (T ≈ 293 K, p ≈ 101325 Pa, ℎ ≈ 0.5) получаем:

∂c
∂T
≈ 0.60 m/(s · K), | (11)

∂c
∂p
≈ −4.7 · 10⁻⁴ m/(s · Pa), | (12)

∂c
∂ℎ
≈ 0.08 m/s. | (13)

Подставляя погрешности датчиков BME280 (ΔT = 0.5 K, Δp = 120 Pa, Δℎ = 0.03) и Δмод = 0.31 м/с:

ΔcT = 0.60 · 0.5 = 0.30 m/s, | (14)
Δcp = 4.7 · 10⁻⁴
- 120 ≈ 0.06 m/s, | (15)
Δcℎ = 0.08 · 0.03 ≈ 0.002 m/s. | (16)

Полная погрешность:

Δc =

√︀
0.30² + 0.06² + 0.002² + 0.31² ≈

√
0.186 ≈ 0.43 m/s. (17)

Таким образом, при использовании датчиков среднего класса точности полная погрешность определения скорости звука составляет около ±0.43 m/s (∼ ±0.13%). Основной вклад вносят погрешность измерения температуры (∼ 70%) и погрешность модели (∼ 52%); влияние давления и влажности значительно меньше.
Проверка по табличным данным. Для верификации оценки погрешности модели выполним сравнение расчётного значения скорости звука с табличными данными при стандартных условиях (сухой воздух, T = 273.15 K, p = 101325 Па, ℎ = 0).
По формулам (7) при ℎ = 0 получаем xv = 0, Mmix = Md, Rmix = R/Md, γ = cp,d/(cp,d − Rmix), откуда

cрасч =

√︂
γ

R
Md

T =

√︂
1.402 ·

8.314
0.028965
- 273.15 ≈ 331.3 m/s. (18)

Табличное значение скорости звука в сухом воздухе при 0

∘C и нор-

мальном атмосферном давлении согласно [18] составляет cтабл = 331.29 м/с. Разница между расчётным и табличным значениями:

Δcпроверка = |cрасч − cтабл| ≈ |331.3 − 331.29| = 0.01 m/s. | (19)

Полученное расхождение (∼ 0.003%) значительно меньше оценённой погрешности модели Δмод ≈ 0.31 м/с, что подтверждает корректность оценки с запасом. Разница объясняется округлениями констант в расчёте и не учтённым влиянием реальных свойств газа (вторые вириальные коэффициенты), которое как раз и даёт основной вклад в Δмод.
Выводы. Проведённый анализ показал, что при использовании недорогих датчиков типа BME280 основная погрешность определения скорости звука (∼ 0.43 м/с) определяется погрешностью измерения температуры (0.30 м/с) и погрешностью модели (0.31 м/с). Проверка по табличным данным подтвердила, что оценка погрешности модели является консервативной (завышенной), что приемлемо для инженерных расчётов.

### 4.3.2 Точность измерения времени

Расстояние определяется по интервалу времени между общей меткой (приём UWB-кадра) и детектированием ультразвукового импульса. Поскольку часы передающей и приёмной сторон синхронизированы, это время одностороннего распространения, и ошибка дальности связана с ошибкой времени соотношением
Δd = c Δt. | (20)

Коэффициент c ≈ 343 м/с задаёт масштаб перевода (табл. 3).
Квантование таймера пренебрежимо. Само измерение времени выполняется аппаратно: момент приёма UWB-кадра фиксируется таймером DWM1000 с разрешением 15 пс, а фронт компаратора якоря защёлкивается аппаратным модулем захвата (MCPWM CAP) с разрешением 12,5 нс

Таблица 3: Перевод ошибки времени в ошибку дальности (Δd = c Δt)

Δt | Δd
1 мкс 10 мкс 100 мкс 1000 мкс | 0.34 мм 3.4 мм 34 мм 34 см

(c Δt ≈ 4 мкм). Квантование таймера, таким образом, в бюджет ошибки практически не входит.
Источник случайной ошибки. Доминирующий вклад в случайную ошибку даёт джиттер определения самого момента прихода. Характерной точкой прихода служит начало роста огибающей; огибающая нарастает за конечное время фронта τфр ≈ 0,2 мс (измерено, см. раздел 5.5), а её положение восстанавливается по зашумлённым отсчётам нарастающего участка (двухимпульсный метод, раздел 5.2.4). Для определения времени по фронту джиттер оценивается отношением шума к крутизне фронта:

σt ≈

σV
|dV/dt|

≈

τфр
SNR, σd = c σt ≈

c τфр
SNR, | (21)

где SNR = Vmax/σV — отношение амплитуды огибающей к СКО шума, а c τфр ≈ 69 мм. При наблюдаемом отношении сигнал/шум подробный бюджет случайной ошибки (раздел 5.2.5) даёт σd ≈ 3 мм (значение принято с запасом; на пределе дальности, где SNR падает, оценка близка к 4 мм). Зависящая от амплитуды (а значит, от дальности) систематическая часть этой задержки устраняется двухимпульсной самокалибровкой (раздел 5.2.4); остаётся именно случайный джиттер.

Итоги.

- систематическая ошибка — ∼0,13% (погрешность скорости звука);
- случайная ошибка — σd ≈ 3 мм (подробный бюджет — раздел 5.2.5).

### 4.3.3 Точность определения координат

При трилатерации в трёхмерном пространстве точность определения координат зависит не только от точности измерения расстояний до якорей, но и от их геометрического расположения. Данный эффект описывается коэффициентом геометрического ослабления точности (GDOP — Geometric Dilution of Precision) [2, 3].
Коэффициент GDOP характеризует влияние геометрии расположения якорей на распространение случайных ошибок измерения расстояний в ошибку оценки координат. В рамках линейной модели оценивания с нулевым средним ошибок измерений GDOP определяет ковариацию оценки координат. Систематические ошибки приводят к смещению оценки и не описываются коэффициентом GDOP [19, 20].
Постановка. Рассмотрим четыре якоря, расположенные в вершинах квадрата в плоскости z = 0:
A1(+a/2, + a/2, 0), | A2(−a/2, + a/2, 0),
A3(−a/2, − a/2, 0), | A4(+a/2, − a/2, 0).

Объект находится в точке P(0, 0, H) на высоте H над центром квадрата. Измеренные расстояния до якорей:

di =

√︀
(x − xi)

2 + (y − yi)

| 2 + (z − zi) 2 + εi ,

где εi — случайная ошибка измерения с дисперсией σ

| 2 d .

Матрица Якоби. Линеаризуем уравнения в окрестности истинной позиции. Пусть D =

√︀
a

2/2 + H² — расстояние от объекта до каждого якоря. Матрица Якоби имеет вид:

J =

⎛

⎜⎜⎜⎜⎝

+

a
2D +

a
2D −

H
D
−

a
2D +

a
2D −

H
D
−

a
2D −

a
2D −

H
D
+

a
2D −

a
2D −

H
D

⎞

⎟⎟⎟⎟⎠

Вычисление J

T J. Благодаря симметрии расположения якорей матрица

J

T J является диагональной:

J

T
J =

⎛

⎜⎝

a

2
D² | 0 | 0
0
| a
| 2
| D² | 0
0 | 0 | 4H²
| | D²

⎞

⎟⎠ .

Ковариационная матрица и GDOP. В рамках метода наименьших квадратов ковариационная матрица оценки координат определяется выражением [20, 19]:
Σ = σ

2
d

(J

T
J)

−1

Отсюда:

Σ = σ

2
d

⎛

⎜⎝

D²
a
2 | 0 | 0
0 | D² a
| 2 | 0
0 | 0 | D² 4H²

⎞

⎟⎠ .

Среднеквадратичная ошибка положения (PDOP — Position Dilution of Precision) определяется как

σxyz =

√︀
tr(Σ) = σd

√︂
2D²
a

2

+

D²
4H²

Подставляя D² =

a

2
2 + H²
, получаем:

σxyz = σd · D ·

√︂
2
a

2

+

1
4H²

где:

- σxyz — среднеквадратичная ошибка положения, м;
- σd — СКО измерения расстояния до якоря, м;
- D =

√︀
a

2/2 + H² — расстояние до якоря, м;

- a — расстояние между якорями, м;
- H — высота объекта, м.

Геометрический фактор. При H ≫ a вертикальное слагаемое под корнем пренебрежимо мало по сравнению с горизонтальным, и выражение сводится к

σxyz ≈

√
2

D
a

σd = G σd, G =

√
2

D
a

,

где G — коэффициент геометрического ослабления точности. Для рабочей конфигурации (a = 2 м, H = 25 м) G ≈ 18: ошибка положения в G раз превышает ошибку измерения дальности. Раздельно по осям горизонтальная составляющая доминирует (σx = σy =

D
a

σd ≈ 12,5 σd), а вертикальная мала

(σz =

D
2H

σd ≈ 0,5 σd): объект находится почти над центром базы, поэтому измеренные дальности хорошо определяют высоту и слабо — горизонтальное смещение. Компактная база (малое a) увеличивает G, поэтому сантиметровая точность положения требует миллиметровой точности измерения дальности. Случайная ошибка измерения дальности. СКО измерения дальности σd определяется бюджетом случайных погрешностей приёмного тракта (раздел 5.2.5): после устранения систематического смещения двухимпульсной калибровкой остаточная ошибка складывается в основном из джиттера компаратора и составляет σd ≈ 3 мм. Это значение используется в расчётах ниже.
На рис. 3 представлена зависимость ошибки позиционирования от взаимного расположения якорей при фиксированной ошибке измерения σd = 3 мм и высоте объекта H = 25 м.

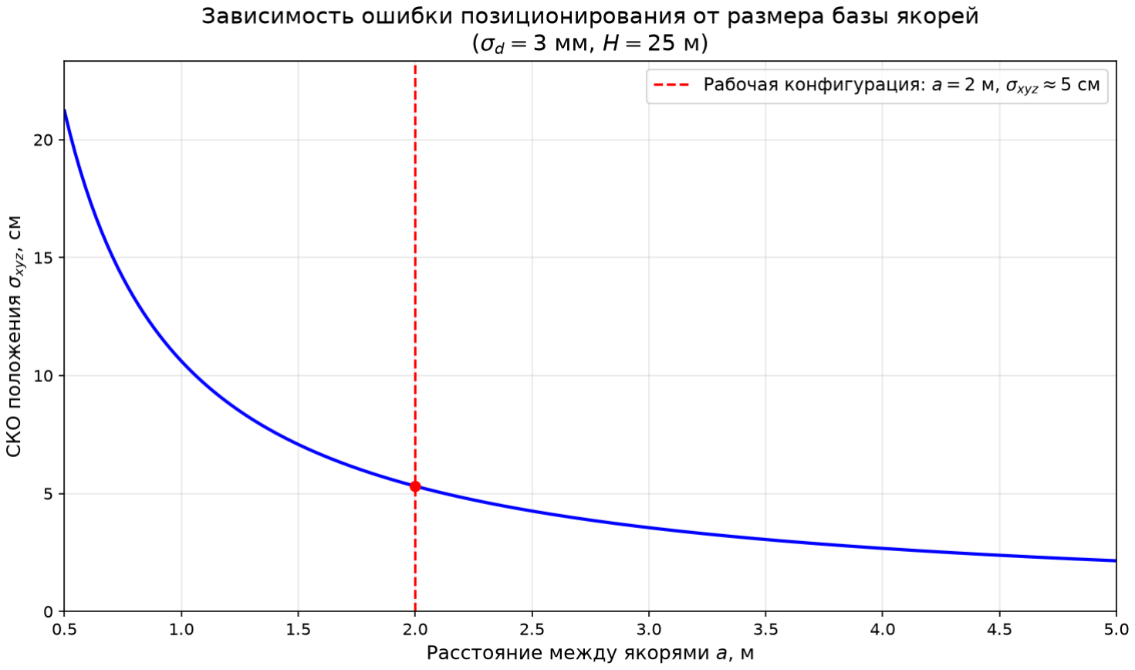
[picture p15: figure]

Рис. 3: Зависимость ошибки позиционирования от геометрии расположения якорей

Оценка погрешности. Рассмотрим характерные параметры системы: высота объекта H = 25 м, расстояние между якорями a = 2 м. В этом случае:

- систематическая ошибка измерения расстояния приводит к смещению оценки порядка 3 см;
- случайная ошибка измерений с учётом эффекта GDOP приводит к СКО порядка 5 см.

Таким образом, суммарная ошибка позиционирования в худшем случае может достигать порядка 8 см.

### 4.4 Методы решения задачи трилатерации

Для получения координат БПЛА при известных расстояниях до якорей необходимо решить задачу трилатерации. Для её решения в настоящей работе рассмотрены два метода: аналитический и вычислительный метод Гаусса– Ньютона. В экспериментах оба метода дали практически идентичную точность, поэтому предпочтение отдано аналитическому методу как вычислительно более простому (замкнутое решение без итераций).

### 4.4.1 Аналитическое решение задачи трилатерации в пространстве по

трём расстояниям

Задача определения координат по трём известным расстояниям имеет замкнутое решение через пересечение трёх сфер [21].
Пусть заданы три опорные точки в плоскости z = 0:
P1 = (x1, y1, 0), | P2 = (x2, y2, 0), | P3 = (x3, y3, 0),

и измеренные расстояния от неизвестной точки P = (x,y,z) до них:

| r1, r2, r3.

### 1. Уравнения сфер. Координаты точки P удовлетворяют системе уравнений

трёх сфер:
(x − xi)

2 + (y − yi)

| 2 + z 2 = r
| 2 i
| , | i = 1,2,3.

### 2. Получение линейной системы для координат x и y. Вычтем уравнения

для i = 2 и i = 3 из уравнения для i = 1. Так как член z

| | 2 присутствует во всех

трёх уравнениях, он сокращается. Получаем:

2(x2 − x1)x + 2(y2 − y1)y = r

2
1 − r

2
2 + x

2
2 − x

2
1 + y

2
2 − y
2/1, | (22)

2(x3 − x1)x + 2(y3 − y1)y = r

2
1 − r

2
3 + x

2
3 − x

2
1 + y

2
3 − y
2/1. | (23)

В матричной форме:

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
2(x2 − x1) 2(y2 − y1)
2(x3 − x1) 2(y3 − y1)

)︃
,

b1 = r

2
1 − r

2
2 + x

2
2 − x

2
1 + y

2
2 − y
2/1, b2 = r

2
1 − r

2
3 + x

2
3 − x

2
1 + y

2
3 − y
2/1.

Если опорные точки не коллинеарны, то det A ̸= 0, и система имеет единственное решение:
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
### 3. Определение координаты z. После нахождения x и y подставим их в

первое уравнение сферы:

z

2 = r

2
1 − (x − x1)

2 − (y − y1)

2

Отсюда:
z = ±

√︁
r

2
1 − (x − x1)

2 − (y − y1)

2

Если
r

2
1 − (x − x1)

2 − (y − y1)

2 < 0,

то система не имеет действительных решений (данные несовместны). Поскольку сферы симметричны относительно плоскости z = 0, существует максимум два решения, соответствующие различным знакам корня. В данной задаче выбирается решение с положительной высотой: z > 0.

### 4. Итоговое решение. Искомая точка пересечения сфер:

P = (x, y, z), где (x,y) находятся из линейной системы

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
а координата z определяется как

z =

√︁
r

2
1 − (x − x1)

2 − (y − y1)

2

При этом берётся корень со знаком «плюс», так как требуется решение с z > 0.

### 4.4.2 Метод Гаусса–Ньютона

Этот метод используется для минимизации суммы квадратов; с учётом нашей задачи функция для минимизации будет выглядеть следующим образом:

min
p

J(p), J(p) = ∑︁ N

i=1

wi

(︀
r^i − ‖p − ai‖

)︀2

- r^i — измеренное расстояние от якоря i до объекта;
- ai — вектор координат i-го якоря;
- p — вектор неизвестных координат объекта;
- wi — вес измерения i (обычно обратный дисперсии);
- J(p) — целевая функция суммы взвешенных квадратов невязок.

Подробное изложение метода выходит за рамки настоящей работы; его описание можно найти в [22]. В качестве начального приближения целесообразно использовать предыдущую позицию БПЛА или данные инерциальной навигационной системы: при хорошем начальном приближении метод сходится за единичное число итераций, что обеспечивает низкие вычислительные затраты.

### 4.4.3 Сравнительный анализ

Для сравнения точности этих методов был проведён численный эксперимент в программе на Python.

Постановка эксперимента. Рассмотрим конфигурацию из 4 якорей, расположенных по углам квадрата со стороной 2 метра, далее:

- выбираем случайные координаты БПЛА, примерно в 25 метрах над платформой;
- измеряем расстояния от объекта до якорей;
- подмешиваем в расстояния систематическую и случайную ошибку;
- передаём расстояния в вычислительные методы и получаем результат;
- вычисляем ошибку координат.

Эксперимент с 5 якорями проводится аналогично, пятый якорь добавляется в центр квадрата.
Аналитический метод предполагает известные расстояния только до трёх точек, поэтому мы будем вычислять координаты для каждой тройки точек в отдельности (рис. 4).

Рис. 4: Выбор троек якорей для аналитического решения

Далее полученные координаты усредняем по всем тройкам. Вычислительный же метод работает следующим образом: в качестве начального приближения берётся аналитическое решение по любой из троек, далее следуют итерации метода Гаусса–Ньютона, учитывающие расстояние до всех якорей.

Результаты. Систематическая ошибка одинаково влияет на точность аналитического и вычислительного метода, поэтому в экспериментах она имеет фиксированное значение ∼0,13%. Посмотрим на точность методов в зависимости от случайной ошибки (рис. 5); каждая точка на графике соответствует средней ошибке по 50 измерениям.

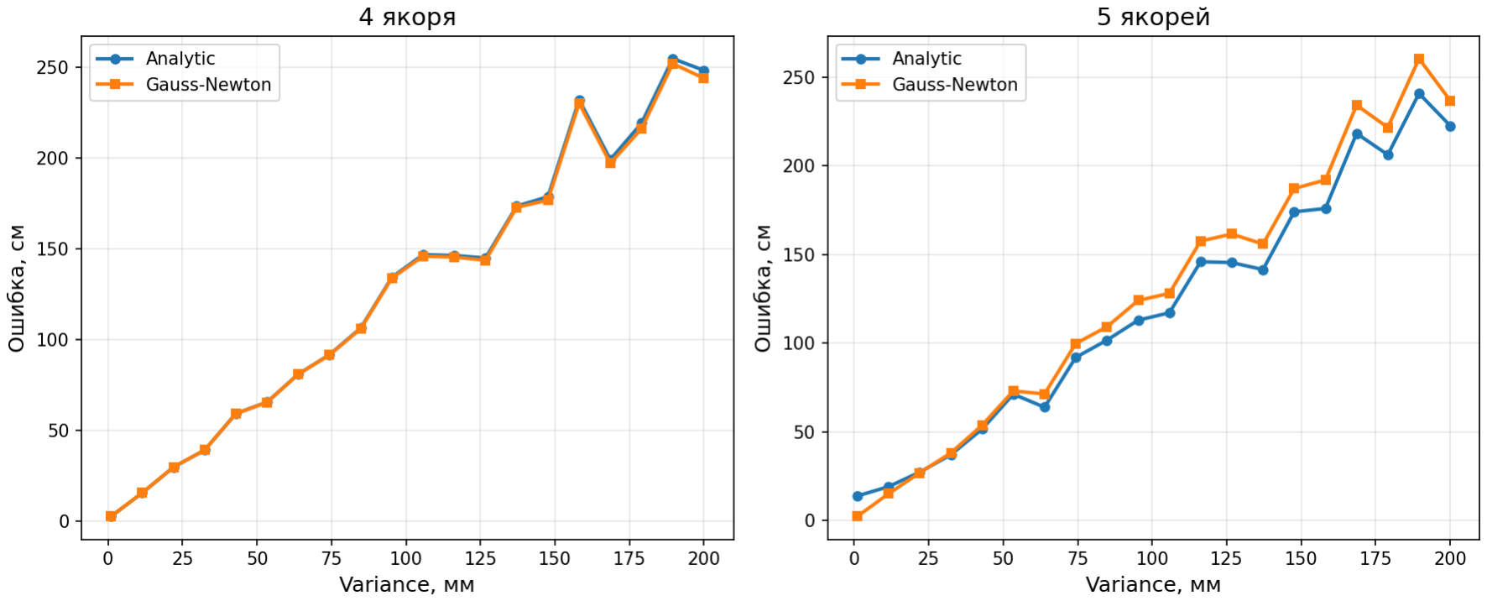
[picture p16: figure]

Рис. 5: Зависимость средней ошибки позиционирования от СКО случайной ошибки измерения

- 4 якоря: результаты почти одинаковые.
- 5 якорей: аналитический метод показывает себя лучше при больших значениях ошибки и хуже при малых. Ухудшение точности на малых ошибках можно объяснить тем, что в конфигурации из 5 якорей существуют тройки, где якоря находятся ближе друг к другу. Это повышает GDOP-ошибку и ухудшает общий результат при усреднении.

В таблицах 4 и 5 приведены средние значения ошибки по 1000 измерений в зависимости от разных значений случайной ошибки.
В нашей системе случайная ошибка измерения дальности составляет σd ≈ 3 мм (раздел 5.2.5); по приведённым данным (строка σ = 0,003) и оценке GDOP это соответствует полной ошибке позиционирования порядка 5 см, что укладывается в теоретические оценки.
Аналитический метод вычислительно проще метода Гаусса–Ньютона, и оптимально использовать именно его на конфигурации из 4 якорей.

Таблица 4: Аналитический метод

σ, м | 4 якоря, см | 5 якорей, см
0.002 | 3.53 | 15.96
0.003 | 4.61 | 15.87
0.005 | 6.98 | 16.20
0.01 | 13.11 | 19.00
0.05 | 62.01 | 58.44
0.1 | 129.70 | 115.59

Таблица 5: Метод Гаусса–Ньютона

σ, м | 4 якоря, см | 5 якорей, см
0.002 | 3.57 | 3.56
0.003 | 4.60 | 4.63
0.005 | 7.06 | 6.83
0.01 | 12.86 | 13.15
0.05 | 61.81 | 63.82
0.1 | 124.40 | 127.19

### 5 Описание практической части

В рамках работы разработан и собран лабораторный прототип системы. Ниже описаны передающий узел БПЛА, тракт обработки сигнала якоря, двухимпульсный метод самокалибровки времени прихода, система питания и защиты от наводок, протокол UWB-синхронизации узлов и результаты экспериментальной проверки приёмного тракта.

### 5.1 Узел БПЛА (передающая часть)

Узел БПЛА выполняет две задачи: излучение ультразвукового сигнала на частоте 25 кГц и радиочастотную синхронизацию момента излучения с центральным узлом на платформе. За каждый рабочий цикл узел излучает пару идентичных импульсов (пачек несущей) с фиксированным разносом — этого требует двухимпульсный метод самокалибровки времени прихода (раздел 5.2.4). Первый импульс является измерительным, и его старт жёстко синхронизируется с радиосигналом; второму достаточно лишь стабильного разноса относительно первого. Жёсткое совмещение моментов начала ультразвукового и радиоимпульса является принципиальным требованием: при заданном уровне точности ToF на уровне миллиметра случайное рассогласование между фактическим стартом акустического сигнала и зафиксированным радиосинхросигналом не должно превышать нескольких микросекунд.

### 5.1.1 Структурная схема

В состав узла входят микроконтроллер ESP32-S3, сверхширокополосный (UWB) радиомодуль DWM1000 (Decawave/Qorvo), счетверённый аналоговый ключ SN74HC4066N, мостовой драйвер TC4427A и пьезоизлучатель Murata

MA40S4S (рис. 6). ESP32-S3 средствами модуля MCPWM формирует непрерывную несущую 25 кГц в виде двух строго противофазных меандров на выводах GPIO4 и GPIO5 и одновременно конфигурирует DWM1000 по интерфейсу SPI. Открытие тракта несущей на драйвер выполняется аппаратно

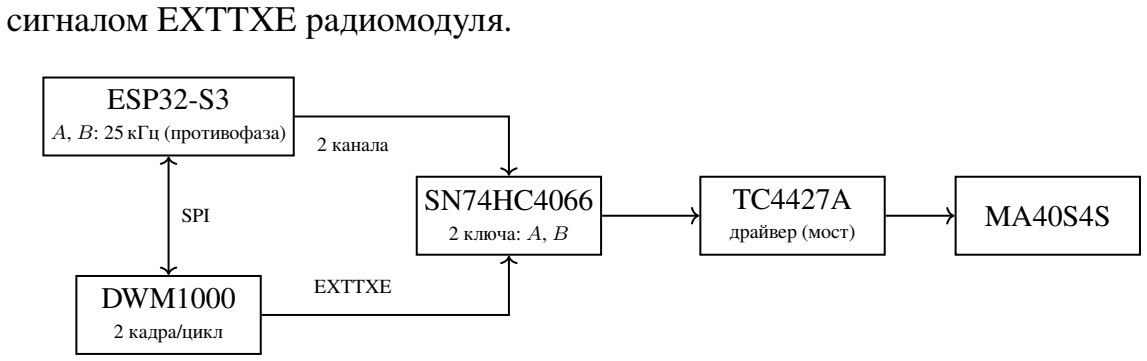
[picture p17: figure]
сигналом EXTTXE радиомодуля.; ESP32-S3; A, B: 25 кГц (противофаза); DWM1000; 2 кадра/цикл; 2 ключа: A, B; TC4427A SPI; драйвер (мост); 2 канала; EXTTXE

Рис. 6: Структурная схема узла БПЛА: ESP32-S3 формирует два противофазных канала несущей 25 кГц (A и B) для дифференциального возбуждения моста и управляет радиомодулем DWM1000 по SPI; в момент старта UWB-пакета модуль аппаратно открывает оба аналоговых ключа SN74HC4066 общим сигналом EXTTXE.

### 5.1.2 Аппаратная синхронизация через EXTTXE

Центральный узел вычисляет дальность по интервалу между приёмом UWB-кадра (общая метка времени) и моментом детектирования ультразвукового импульса якорем. В идеале этот интервал равен времени распространения звука; реально к нему добавляются задержки тракта, которые по влиянию на точность ToF удобно разделить на три типа.
Постоянные систематические задержки (безопасны). Это, прежде всего, задержка радиочастотной цепи DWM1000 от момента записи команды по SPI до фактического подъёма сигнала EXTTXE [23] (∼150 мкс на инициализацию синтезатора и формирование RF-преамбулы), а также задержка распространения в антенне, задержка переключения компаратора (∼200 нс) и обработки на приёмной стороне. Все они постоянны от цикла к циклу и входят в одну аддитивную константу, определяемую при калибровке: при вычитании она сокращается и на измеренную дальность не влияет. Поэтому важен не абсолютный момент старта, а отсутствие в нём случайной составляющей. Случайные задержки (опасны). Программный запуск передачи в ESP32-S3 проходит через прерывания операционной системы FreeRTOS.

Время реакции на прерывание зависит от состояния планировщика, кэшей инструкций и обработчиков более приоритетных прерываний; результирующий разброс момента старта составляет 1–5 мкс. Он непредсказуем и не воспроизводится от цикла к циклу, поэтому напрямую переходит в погрешность ToF: при Δt = 1 мкс ошибка дальности Δd = c Δt ≈ 0,34 мм. При требуемой точности на уровне миллиметра такой джиттер недопустим и должен быть устранён.
Зависящая от дальности систематика. Задержка срабатывания компаратора между истинным приходом и пересечением порога зависит от амплитуды сигнала, а та убывает с расстоянием. Эта задержка постоянна для данной дистанции, но меняется с дальностью, поэтому не сводится к калибровочной константе и не усредняется. Она компенсируется отдельно — двухимпульсной самокалибровкой времени прихода (раздел 5.2.4).
Устранение случайного джиттера. Применяется аппаратный механизм отложенной передачи DWM1000 (Delayed TX). ESP32-S3 заранее, за несколько сотен микросекунд до требуемого момента, программирует по SPI время старта; далее весь процесс ведёт встроенный радиочастотный таймер модуля с шагом 15 пс. В заранее запрограммированный момент DWM1000 поднимает в высокий уровень сигнал EXTTXE (вывод GPIO5, выведенный на внешние контакты модуля). Поскольку SPI-команда подаётся заблаговременно, программный джиттер ESP32-S3 укладывается в окно ожидания и не переходит на момент EXTTXE; стартом командует только аппаратный таймер.
Сигнал EXTTXE подаётся на разрешающие входы аналоговых ключей SN74HC4066N. Непрерывная несущая 25 кГц с выводов ESP32-S3 попадает на драйвер только в активном состоянии EXTTXE; до этого момента и после завершения пачки путь сигнала разорван. Моменты физического начала ультразвукового излучения и UWB-передачи жёстко связаны общим логическим фронтом; взаимный джиттер между ними определяется задержками логических вентилей и не превышает 10 нс, что соответствует ошибке ToF Δd ≈ 3,4 мкм — пренебрежимо мало. Оба импульса пары формируются двумя UWB-передачами за цикл (немедленной и отложенной), поэтому их взаимный разнос ΔT задаётся кварцевым таймером DWM1000 и стабилен с точностью ∼8 нс; измерительным служит первый импульс, второму достаточно этого стабильного разноса.

В начале каждой пачки формируется преамбула из нескольких пустых периодов несущей: она поглощает время инициализации RF-цепи DWM1000 и переходные процессы пьезопреобразователя и приёмного тракта; полезная часть пачки идёт после преамбулы.

### 5.1.3 Управление мостом и активное гашение пьезоизлучателя

Драйвер TC4427A построен по схеме полного моста (H-мост) и питает пьезопреобразователь дифференциально, то есть напряжением между двумя своими выходами. Чтобы получить двуполярное возбуждение, на оба входа драйвера приходят два противофазных сигнала A и B с выводов ESP32-S3 через два ключа SN74HC4066N: один ключ коммутирует сигнал (A) ко входу INA драйвера, второй — сигнал (B) ко входу INB. Общим разрешающим сигналом для обоих ключей служит EXTTXE, что обеспечивает строго одновременное открытие путей и сохраняет наносекундную привязку к UWB-пакету.
Пока EXTTXE активен (на время пачки), на входах драйвера присутствует противофазная пара A/B: выходы моста формируют дифференциальный размах ±VDD на излучателе — идёт излучение несущей.
После окончания пачки EXTTXE снимается, ключи SN74HC4066N размыкаются и отсоединяют несущую от входов драйвера. Входы INA, INB подтянуты к общему проводу резисторами 10 кОм, поэтому в паузе оба они оказываются в низком уровне, а оба выхода моста — на общем проводе. Излучатель при этом замкнут через нижние ключи моста с малым сопротивлением открытого канала (RDS(on) ∼ 0,5 Ом).
Пьезоэлектрический преобразователь MA40S4S обладает высокой механической добротностью: после прекращения возбуждения собственные колебания затухают за ∼400 мкс. Замыкание излучателя в паузе диссипирует запасённую механическую энергию через сопротивление RDS(on) — остаточные колебания гасятся активно за время порядка одного периода несущей. Это устраняет «звон» между двумя импульсами пары и перед следующим циклом, улучшая определение переднего фронта огибающей на приёме. Управляющие входы двух неиспользуемых ключей микросхемы SN74HC4066N подтянуты к общему проводу резисторами 10 кОм, гарантируя их закрытое состояние.

### 5.2 Узел якоря: обработка сигнала

Цепь обработки сигнала каждого якоря включает четыре последовательных блока (рис. 7): предусилитель INA128P, усилитель TL072CN (два каскада: ФВЧ и ФНЧ) и демодулятор (детектор огибающей совместно с компаратором LM311P).
Пьезоприёмник является механическим резонатором: любое акустическое воздействие — хлопок, удар, вибрация — преобразуется в затухающие колебания на той же частоте 25 кГц, что и полезный сигнал. Поэтому полосовой фильтр не позволяет отличить полезный сигнал от механического шума. Надёжное распознавание обеспечивается временным кодированием: передатчик излучает пару пачек длительностью ∼1 мс каждая, а микроконтроллер идентифицирует сигнал по характерному двухимпульсному шаблону во времени. Фильтр выполняет вспомогательную роль: подавляет электрические помехи в схеме (наводки питания, ВЧ-мусор), что позволяет поднять коэффициент усиления без перегрузки.

Предусилитель

INA128P, G≈25–100

Усилитель

TL072CN, K≈64

Демодулятор

огибающая + порог

УЗ
приёмник | МК

Рис. 7: Структурная схема цепи обработки сигнала якоря

### 5.2.1 Предусилитель — INA128P

На первом каскаде применяется инструментальный усилитель INA128P с дифференциальным входом (рис. 8). Высокое выходное сопротивление пьезоприёмника обусловливает подключение резисторов 1 МОм от каждого входа на землю для задания тока смещения; конденсатор 100 пФ между входами срезает высокочастотные наводки на входных проводах. Коэффициент усиления задаётся резистором Rg между выводами RG (выводы 1 и 8), который образован последовательным соединением постоянного резистора R1 = 470 Ом и подстроечного RP1 = 1,5 кОм (Rg = R1 + RP1):

G = 1 +

50 кОм
Rg

Регулировка RP1 изменяет Rg в диапазоне 470–1970 Ом, что обеспечивает G ≈ 26–107 и позволяет подстраивать усиление под конкретный экземпляр пьезоприёмника без изменения схемы. Питание — ±12 В, вывод REF подключён к аналоговой земле.

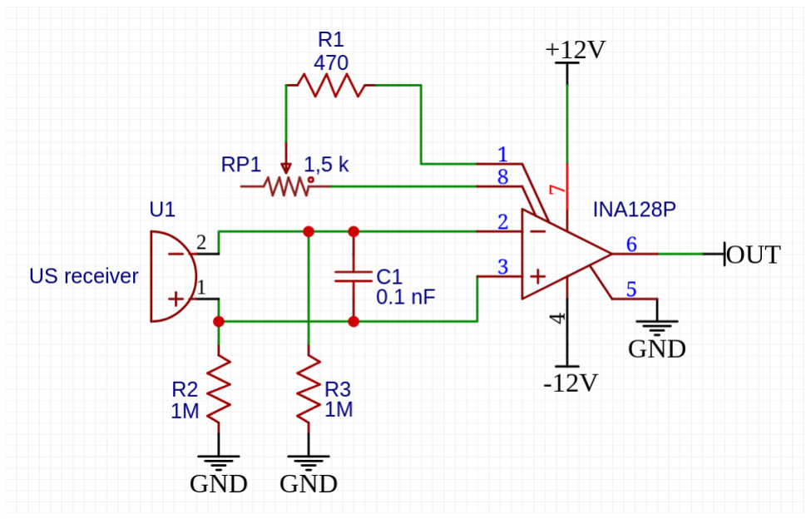
[picture p18: figure]

Рис. 8: Схема предусилителя INA128P

### 5.2.2 Усилитель — TL072CN

Оба операционных усилителя микросхемы TL072CN (U1.1 и U1.2) включены как неинвертирующие усилители (рис. 9). Цепь обратной связи каждого каскада образована резисторами Rf = 39 кОм (R2, R4) и Rвх = 3,9 кОм (R5, R6), что даёт одинаковый коэффициент усиления:

K = 1 +

Rf
Rвх

= 1 +

39
3,9

= 11.

Полосовая характеристика формируется входными RC-фильтрами обоих каскадов, частоты среза которых расположены по краям рабочей полосы вокруг частоты 25 кГц.
ОУ-A — U1.1 (входной ФВЧ, fc ≈ 22 кГц). На неинвертирующий вход сигнал подаётся через фильтр верхних частот: конденсатор C1 = 330 пФ последовательно с источником, резистор R1 = 22 кОм на землю:

fc,A =

1
2πR1C1

≈ 22 кГц.

ОУ-B — U1.2 (входной ФНЧ, fc ≈ 27 кГц). На неинвертирующий вход сигнал подаётся через фильтр нижних частот: резистор R3 = 20 кОм последовательно с источником, конденсатор C2 = 300 пФ на землю:

fc,B =

1
2πR3C2

≈ 27 кГц.

На частоте 25 кГц оба фильтра работают в переходной зоне: ОУ-A — незначительно выше своей частоты среза, ОУ-B — незначительно ниже. Амплитудное ослабление на 25 кГц составляет ≈0,75 для входного ФВЧ (ОУ-
A) и ≈0,73 для входного ФНЧ (ОУ-B), так что эффективный коэффициент каждого каскада Kэфф ≈ 11 · 0,74 ≈ 8, а суммарный коэффициент двух каскадов ≈ 64. При частотах существенно ниже 22 кГц или выше 27 кГц один из каскадов вносит значительно большее ослабление, поэтому суммарный коэффициент резко убывает — каскады совместно действуют как полосовой усилитель с центральной частотой 25 кГц.

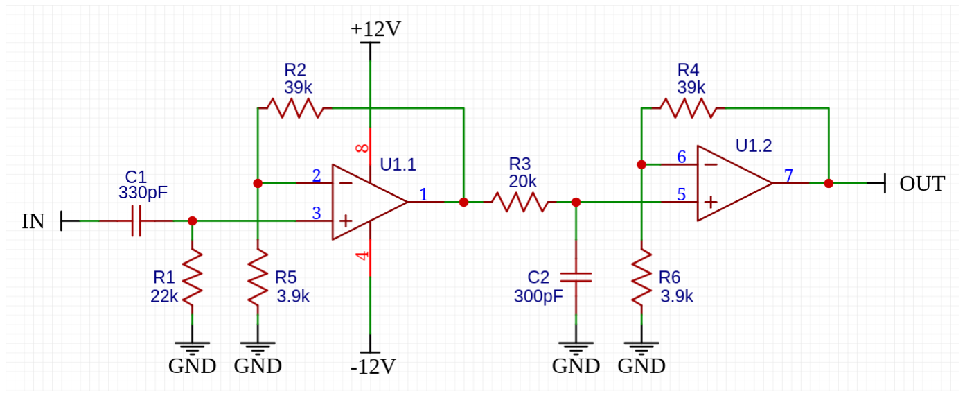
[picture p19: figure]

Рис. 9: Каскады усилителя TL072CN: ОУ-A (U1.1) — неинвертирующий усилитель с входным ФВЧ (fc≈22 кГц, KA=11), ОУ-B (U1.2) — с входным ФНЧ (fc≈27 кГц, KB=11). Питание ±12 В.

### 5.2.3 Демодулятор

Демодулятор преобразует переменный сигнал 25 кГц в логический уровень для микроконтроллера и состоит из детектора огибающей и быстрого компаратора с гистерезисом (рис. 10).
Детектор огибающей построен на германиевом диоде Д9, накопительном конденсаторе C3 = 22 нФ и разрядном резисторе R3 = 20 кОм на землю; постоянная времени разряда:

τ = R3C3 = 20 · 10³

- 22 · 10⁻⁹ ≈ 0,44 мс.

Заряд конденсатора идёт через открытый диод с малым сопротивлением, поэтому передний фронт огибающей повторяет начало пакета без задержки. Постоянная разряда выбрана из двух условий. С одной стороны, она должна быть много больше периода несущей (τ ≫ 1/(2πfнес) ≈ 6 мкс), чтобы полностью сгладить заполнение и получить гладкую огибающую. С другой — много меньше межимпульсного зазора (τ ≪ 2 мс), чтобы огибающая успевала вернуться к базовой линии между двумя импульсами пары: при τ ≈ 0,44 мс за время зазора огибающая спадает в e

−2/0,44 ≈ 1%, так

что второй импульс детектируется с чистого фронта — это необходимо для двухимпульсной самокалибровки (раздел 5.2.4). Подавление более поздних эхо-сигналов обеспечивается не постоянной времени детектора, а программным гейтом: микроконтроллер принимает только первый приход в каждом цикле, а позднейшие отражения отбрасывает по времени. Германиевый диод Д9 предпочтительнее кремниевого: его падение в открытом состоянии ∼0,2 В против ∼0,6 В у 1N4148 даёт выигрыш чувствительности ∼0,4 В, что существенно для слабых сигналов на максимальной дальности.
Компаратор LM311P выбран взамен медленных операционных усилителей общего назначения (LM358) и компараторов LM393: его задержка переключения составляет ∼200 нс против ∼1,3 мкс у LM393, что вносит соответствующую погрешность ToF Δd = c Δt ≈ 70 мкм — существенно ниже погрешности детектирования переднего фронта. LM311P имеет выход с открытым коллектором (вывод 7), сигнал с которого подаётся на вход микроконтроллера; высокий логический уровень формируется подтягивающим резистором на стороне микроконтроллера. Питание +5 В подаётся на вывод 8, вывод 4 соединён с общей логической землёй.
Порог срабатывания задаётся делителем напряжения R2 = 100 кОм (на +5 В) и R1 = 5 кОм (на землю), подключённым к инвертирующему входу:

Vref = 5 В ·

R1
R1 + R2

= 5 ·

5
105

≈ 0,24 В, что соответствует уровню ∼10% от пиковой амплитуды огибающей при максимальной дальности. Положительная обратная связь резистором R4 = 1 МОм с выхода на неинвертирующий вход создаёт небольшой гистерезис и исключает дребезг при переходе огибающей через порог.


Рис. 10: Демодулятор: детектор огибающей на германиевом диоде Д9 и компаратор LM311P с открытым коллектором; порог задаётся делителем R1, R2, гистерезис — резистором R4

### 5.2.4 Самокалибровка времени прихода: двухимпульсный метод

Компаратор фиксирует момент tc пересечения огибающей фиксированного порога Vtℎ, тогда как физическим моментом прихода прямой волны служит начало роста амплитуды t0. Огибающая нарастает за конечное время (измеренное время фронта ≈0,2 мс, см. раздел 5.5), поэтому компаратор срабатывает позже истинного прихода на величину

δ = tc − t0 ≈ τ

Vtℎ

Vmax

,

где τ — характерное время нарастания, Vmax — амплитуда огибающей. Поскольку амплитуда сигнала убывает с расстоянием, задержка δ у дальних якорей больше, чем у ближних: для слабого сигнала на пределе дальности порог достигается почти у вершины огибающей и δ приближается к полному времени фронта (∼0,2 мс, что эквивалентно ∼70 мм по дальности), тогда как для сильного сигнала δ составляет единицы миллиметров. Это не случайный шум, а систематическое смещение, зависящее от дальности: оно не усредняется и искажает геометрию трилатерации, поэтому требует не фильтрации, а компенсации в каждом измерении.
Для этого передатчик излучает пару идентичных импульсов с известным разносом ΔTtx = 3 мс (импульс ∼1 мс и зазор ∼2 мс, рис. 11). Компаратор срабатывает на оба импульса, давая метки tc1 и tc2 (аппаратный захват таймером с разрешением 12,5 нс). Вокруг ожидаемого прихода второго импульса (tc1 + ΔTtx) микроконтроллер открывает короткое окно АЦП (≈500 мкс, однократный запуск), оцифровывает нарастающий фронт его огибающей и восстанавливает по нему старт роста t0,2 (экстраполяцией фронта к базовой линии). Измеренная разность

δ = tc2 − t0,2

и есть смещение компаратора. Так как оба импульса проходят один и тот же путь и разнесены на интервал, много меньший времени изменения геометрии, их амплитуды, а значит и δ, совпадают. Несмещённую оценку времени прихода первого импульса тогда даёт

tToA = tc1 − δ = t0,1.

Подход выбран ради простоты и устойчивости. Окно АЦП работает в однократном режиме, без непрерывной потоковой оцифровки и DMA, что заметно упрощает прошивку по сравнению с согласованной фильтрацией непрерывного потока. Переотражения подавляются автоматически: эхо одинаково на обоих импульсах и потому не искажает разность δ. Разность tc2 − tc1 служит дополнительной проверкой качества: её отклонение от ΔTtx сигнализирует о сбое (помеха, пропуск импульса) и позволяет забраковать отсчёт. Наконец, температурный дрейф добротности пьезопреобразователя (а с ней и времени фронта τ ) не требует калибровки — δ измеряется заново в каждом цикле.

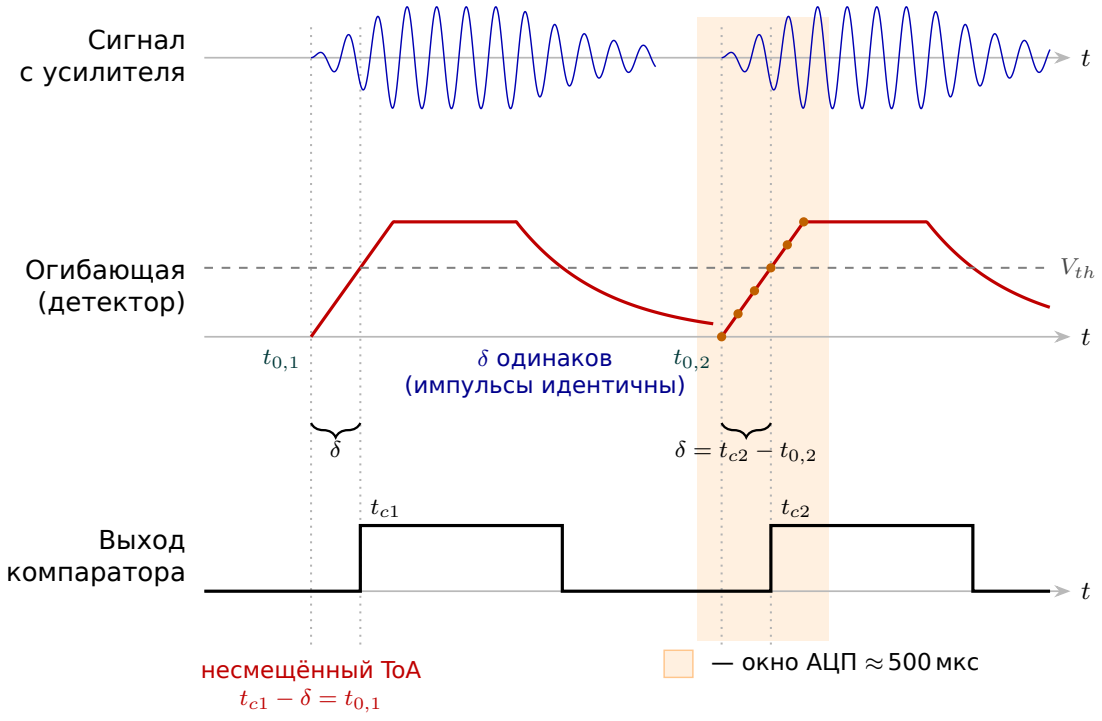
[picture p20: figure]
Сигнал с усилителя; Огибающая (детектор); Vth; Выход компаратора; δ одинаков (импульсы идентичны); несмещённый ToA; — окно АЦП ≈ 500 мкс

Рис. 11: Двухимпульсная самокалибровка времени прихода: сигнал с усилителя (две идентичные пачки 25 кГц), огибающая с порогом Vtℎ и выход компаратора. Реальный приход t0 — начало роста амплитуды; компаратор срабатывает позже на δ. По окну АЦП на втором импульсе измеряется δ = tc2 − t0,2 и переносится на первый: tToA = tc1 − δ. Порог Vtℎ показан завышенным относительно реального (∼10% от пика) для наглядности зазора δ.

### 5.2.5 Бюджет случайной ошибки измерения дальности

Двухимпульсная калибровка устраняет систематическое смещение δ (до ∼70 мм у дальних якорей), поэтому остаточная погрешность времени прихода — случайная. Оценим её бюджет и получим СКО измерения дальности σd, входящее в расчёт точности позиционирования.
Джиттер порога (доминирующий вклад). Компаратор фиксирует момент tc пересечения огибающей V (t) с порогом Vtℎ. Аддитивный шум с СКО σn смещает этот момент; линеаризуя условие V (tc) = Vtℎ в окрестности срабатывания, получаем
σt =

σn
| dV/dt|
tc

Огибающая нарастает от нуля до амплитуды Vmax за время фронта τ , поэтому вблизи низкого порога (∼10% от пика) крутизна близка к максимальной,

dV/dt ≈ Vmax/τ . Отсюда

σt ≈ τ

σn

Vmax

=

τ
SNR, σd,th = c σt ≈

c τ
SNR,

где SNR = Vmax/σn — амплитудное отношение сигнал/шум. При измеренном фронте τ ≈ 0,2 мс (откуда cτ ≈ 69 мм), наблюдаемой амплитуде Vmax ≈ 1,5 В и остаточном фоне σn ≲ 50 мВ в отсутствие излучателя (SNR ≈ 30) получаем σd,th ≈ 2,3 мм.
Прочие независимые вклады. Складываются с доминирующим в квадратуре:
- квантование захвата таймера у каждого якоря: шаг Δt = 12,5 нс даёт c Δt/√
12 ≈ 1 мкм;
- атмосферная турбулентность: трассы к якорям почти совпадают и расходятся лишь у платформы, поэтому их общая часть систематична, а случайна лишь дифференциальная составляющая — на ∼25 м в спокойном воздухе ≲ 1 мм.

Что не входит. Погрешности, общие для всех якорей в пределах одного цикла измерений — прежде всего оценка скорости звука по датчику BME280 и общий момент старта пачки (UWB-синхронизация), — являются систематическими: они синхронно масштабируют или сдвигают все измеренные дальности и потому не размножаются коэффициентом GDOP как независимые ошибки. Их вклад учитывается отдельно, при оценке систематического смещения (∼3 см от остаточной погрешности скорости звука), и в случайный бюджет σd не включается. В σd входят только независимые по якорям источники. Итог. Складывая независимые вклады в квадратуре,

σd =

√︁
σ

2
d,th + σ

2
turb ≈

√︀
| 2,3 2 + 1² мм ≈ 2,5 мм.

Бюджет полностью определяется акустическим джиттером порога. В дальнейших оценках принимается округлённое с запасом значение σd = 3 мм. На пределе дальности, где амплитуда падает до Vmax ≈ 1 В (SNR ≈ 20), σd,th возрастает до ∼4 мм, что соответствует ошибке положения ∼7 см.

### 5.3 Узел якоря: питание и защита от наводок

Описанный выше тракт обработки сигнала с полным усилением ∼64–77 дБ особо чувствителен к наводкам по цепям питания: ничтожный уровень помехи на входной шине ±12 В усиливается операционными усилителями наравне с полезным сигналом и при недостаточной фильтрации способен полностью замаскировать сигнал полезной частоты 25 кГц.
Эта чувствительность приобретает особое значение в полевой эксплуатации. Приёмная подсистема состоит из четырёх якорей, разнесённых по периметру платформы в выбранной по условиям GDOP геометрии. Каждый якорь получает +24 В от центрального узла отдельным проводом; вместе с обратными сигнальными линиями от компараторов это образует пучок из нескольких протяжённых (несколько метров) проводных трасс, проходящих по корпусу платформы. Эти линии работают как антенны для широкополосных электромагнитных помех от штатного оборудования платформы — дизельного электрогенератора и силовых инверторов 400 В, — и являются основным каналом проникновения наводок к якорям.
Применяется трёхуровневая стратегия защиты: гальваническая развязка изолированным DC/DC-преобразователем, входная и выходная LCфильтрация шин питания, локальная развязка по питанию каждой микросхемы.

### 5.3.1 Изолированный преобразователь A2412S-2WR3

Питание усилителя осуществляется от изолированного преобразователя Mornsun A2412S-2WR3 со следующими параметрами:

- вход — 21,6–26,4 В постоянного тока (номинал 24 В);
- выход — ±12 В постоянного тока, ток нагрузки до 83 мА на каждую шину при суммарной выходной мощности 2 Вт;
- напряжение изоляции вход/выход — 1500 В постоянного тока.

Преобразователь полностью развязывает аналоговую землю усилителя (INA128P и оба ОУ TL072CN) от шины питания платформы. Изоляция на уровне 1500 В исключает протекание паразитных токов по контуру «платформа – длинный кабель – якорь» и качественно надёжнее любого фильтрационного решения, поскольку отсекает помеху гальванически, а не подавляет её на конкретных частотах.

### 5.3.2 Входной фильтр шины 24 В

Питание подаётся от центрального узла платформы по экранированному кабелю; экран заземляется только на стороне центра (одностороннее заземление — исключает образование земляных петель). На входе якоря установлен двухзвенный фильтр (рис. 12): ферритовое кольцо (2–3 витка провода 24 В) подавляет высокочастотные наводки синфазного типа; последующее LC-звено на дросселе EC24-101K (100 мкГн), электролитическом конденсаторе 100 мкФ × 35 В и керамическом конденсаторе 100 нФ выполняет дифференциальную фильтрацию коммутационных импульсов и сглаживает просадку питания при пуске преобразователя.

### 5.3.3 Выходные LC-фильтры шин ±12 В

Собственная частота коммутации преобразователя A2412S-2WR3 составляет ∼100 кГц, что лежит выше рабочей полосы усилителя, но в пределах полосы пропускания операционных усилителей INA128P и TL072CN и потому подавляется отдельно. Для подавления коммутационного шума на каждой выходной шине установлен LC-фильтр на дросселе EC24-100K (10 мкГн) и параллельной паре конденсаторов 10 мкФ × 35 В (электролит) и 100 нФ (керамика). На шине −12 В электролитический конденсатор устанавливается в инвертированной полярности (плюс к общему проводу).

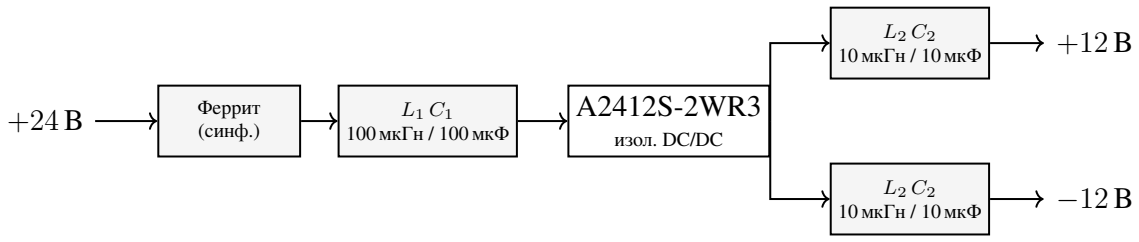
[picture p21: figure]
Феррит (синф.); L1 C1 100 мкГн / 100 мкФ; изол. DC/DC; L2 C2 10 мкГн / 10 мкФ

Рис. 12: Схема питания узла якоря: входной фильтр (феррит +LC) перед изолированным преобразователем A2412S-2WR3 и индивидуальные LC-фильтры на выходах ±12 В

### 5.3.4 Топология земли

Аналоговая земля усилителя GNDиз и логическая земля компаратора LM311P и линии связи с центральным узлом GNDл выполнены раздельно. Питание логической части +5 В формируется отдельным линейным стабилизатором 7805 от шины 24 В, не проходя через изолированный преобразователь. Соединение GNDиз и GNDл выполнено в одной точке у компаратора (звёздная топология); эта точка соединяется с землёй центрального узла одним проводом.
Звёздная топология исключает образование замкнутых контуров по земле, по которым могли бы протекать паразитные токи от наводок и собственного коммутационного шума DC/DC. Развязка по питанию каждой микросхемы (керамика 100 нФ возле каждого вывода питания INA128P, TL072CN и LM311P) подавляет высокочастотные помехи на локальном уровне.

### 5.4 Протокол UWB-линка и синхронизация узлов

Узел БПЛА и центральный (наземный) узел связаны точка-точка по UWB-каналу (DWM1000). Узел БПЛА выступает ведущим (инициирует обмен и задаёт тайминг), центральный — ведомым (реактивно отвечает на принятый кадр). Канал полудуплексный, поэтому ведущий шлёт запрос и слушает ответ, а ведомый отвечает. Запуск построен по стадиям: ни один узел не переходит к работе вслепую, пока предыдущая стадия явно не подтверждена.

### 5.4.1 Стадии запуска

1. Самотест. Каждый узел проверяет свой DWM1000 (чтение DEV_ID = 0xDECA0130 и инициализация). Провал — фатальное состояние с диагностикой.
2. Рукопожатие. БПЛА шлёт PING, центр отвечает PONG: подтверждается, что UWB-канал в принципе рабочий.
3. Конфигурация. БПЛА передаёт свой тайминг (частоты несущей и пакетов, длительности импульса и зазора, разнос стартов ΔT); центр подстраивает окна детектирования с запасом и отвечает CONFIG_ACK. Это подтверждение служит точкой рандеву: центр переходит в режим ожидания первого рабочего пакета, а БПЛА получает разрешение начать рабочий цикл.
4. Рабочий цикл. БПЛА непрерывно шлёт пакеты DATA на 10 Гц синхронно с ультразвуковыми парами; центр на каждый пакет отвечает квитанцией.

Отдельная стадия проверки якорей не выделяется: исправность якоря наблюдаема прямо в рабочем цикле (отсутствие отметки от якоря=нет измерения), а её результат центр сообщает в квитанции (маска живых якорей). Если живых якорей меньше минимума для трилатерации (3 на плоскости, 4 в пространстве), центр выдаёт признак «нет решения» вместо заведомо неверной координаты.

### 5.4.2 Установление первой позиции

При частоте пакетов fп=10 Гц однозначно (без целочисленной неопределённости номера цикла) измеряется дальность лишь до

Rодн =

c
fп

=

343
10

≈ 34,3 м,

тогда как протокол проектируется с запасом на дистанции до 100 м (целевые рабочие — 40–50 м): на большей дальности время пролёта превышает период пакетов, и в воздухе одновременно находится более одной ультразвуковой пары. Для однозначного старта применяется приём изоляции первого пакета. После CONFIG_ACK БПЛА выдерживает паузу

τ ≥

Rмакс
c

=

100
343

≈ 0,29 с (принято 0,3 с),

в течение которой несущая выключена и акустический эфир полностью очищается от прежних сигналов. Затем БПЛА начинает штатную передачу 10 Гц. Первый пакет изолирован снизу тишиной длиной τ , поэтому первое акустическое прибытие после паузы для каждого якоря заведомо принадлежит именно ему (более поздние пакеты приходят позже и не мешают), и его время пролёта измеряется однозначно на любой дистанции до 100 м. Далее номер цикла удерживается по непрерывности: за период 0,1 с БПЛА не смещается на десятки метров, поэтому соответствие «пакет↔ приём» отслеживается без потери. До установления первого однозначного отсчёта центр помечает позицию как невалидную.

### 5.4.3 Устойчивость к перезагрузке

Стадия узла кодируется типом его ответного кадра (PONG — рукопожатие, CONFIG_ACK — конфигурация, квитанция — рабочий цикл), что позволяет обнаружить рассогласование без отдельного поля. Если узел получает от партнёра ответ, соответствующий более ранней стадии (партнёр перезагрузился), либо не получает ответа в течение N пакетов подряд (канал потерян), он возвращается к рукопожатию, после чего обе стороны заново проходят стадии. Инициатором подъёма всегда выступает БПЛА, поэтому взаимная блокировка исключена: даже если БПЛА ещё считает себя в рабочем цикле, перезагрузившийся центр ответит кадром стадии рукопожатия, и БПЛА сам опустится. Одиночные потери пакетов на сброс не влияют — они компенсируются предсказанием фильтра, а сброс инициирует лишь устойчивая регрессия стадии или продолжительная тишина. Перезагрузка БПЛА восстанавливается бесшовно (центр продолжает счёт), перезагрузка центра требует повторного установления первой позиции (∼1 с).

### 5.4.4 Формат кадров

Все кадры начинаются общей трёхбайтовой шапкой: признак системы magic=0x55, версия протокола ver и тип type. Контрольную сумму (2 байта) добавляет аппаратно сам DWM1000, в полезную нагрузку она не входит. Перечень сообщений приведён в таблице 6.

Таблица 6: Сообщения протокола UWB-линка

Сообщение | Код | Направление | Стадия | Назначение
PING | 0x01 БПЛА → центр | рукопожатие | проверка | работоспособности
UWB-канала
PONG | 0x02 центр → БПЛА | рукопожатие | ответ «канал жив»
CONFIG | 0x03 БПЛА → центр конфигурация объявление тайминга передатчи-
ка
CONFIG_ACK 0x04 центр → БПЛА конфигурация «принято, ожидаю первый пакет»
DATA | 0x06 БПЛА → центр | рабочий цикл | рабочий пакет, синхронный с УЗ-
парой
ACK | 0x05 | центр → БПЛА | рабочий цикл | квитанция: стадия, маска якорей,
валидность фикса

### 5.5 Результаты экспериментальной проверки приёмного тракта

Дальность приёма. Уверенный приём сигнала достигнут на расстоянии ≈40 м при амплитуде на выходе усилительного тракта 1–2 В, что обеспечивает надёжное срабатывание компаратора. Эта дистанция ограничена размерами площадки испытаний, а не самой системой: сохраняющийся запас по амплитуде и согласие с теоретической оценкой (раздел 4.2) показывают, что рабочая дальность выше и достигает целевых 40–50 м.
Разрешение пары импульсов. Передний фронт огибающей нарастает за ≈0,2 мс — достаточно круто для точного определения времени прихода. Между двумя импульсами пары огибающая успевает вернуться к базовой линии, поэтому оба импульса детектируются раздельно — необходимое условие двухимпульсной самокалибровки (раздел 5.2.4).
Полученные результаты подтверждают работоспособность приёмного тракта: сигнал уверенно принимается на рабочих дистанциях и разрешается в пару импульсов, на которой строится измерение времени прихода. Тем самым предложенная схема применима для определения координат.

### 6 Заключение

В работе разработана ультразвуковая локальная навигационная система для определения координат привязного БПЛА относительно наземной платформы в условиях недоступности глобальных навигационных спутниковых систем. Получены следующие основные результаты.

1. Сформулирована постановка задачи и требования к системе (раздел 2); проведён сравнительный анализ существующих подходов к локализации БПЛА, обосновавший выбор архитектуры — ультразвуковая дальнометрия с синхронизацией по UWB-радиоканалу (раздел 3).
2. Построена математическая модель системы (раздел 4):
- оценена максимальная дальность работы (≈35 м для текущего излучателя на частоте 25 кГц; целевая дальность — 40–50 м);
- проанализирована погрешность определения скорости звука во влажном воздухе и показано, что при использовании недорогих датчиков она не превышает ∼0,13%;
- получено выражение для влияния геометрии якорей (GDOP) на ошибку позиционирования;
- проведён сравнительный анализ аналитического метода трилатерации и метода Гаусса–Ньютона; показано, что для конфигурации из четырёх якорей предпочтителен вычислительно простой аналитический метод.
3. Разработана и собрана аппаратная часть (раздел 5): передающий узел БПЛА с аппаратной синхронизацией ультразвукового и UWB-сигналов по EXTTXE, тракт обработки сигнала якоря (предусилитель, полосовой усилитель, детектор огибающей и компаратор), двухимпульсный метод самокалибровки времени прихода, устраняющий зависящее от дальности систематическое смещение компаратора, а также изолированная система питания с защитой от наводок. Описан протокол UWB-синхронизации узлов.

4. Экспериментально подтверждена работоспособность приёмного тракта: уверенный приём достигнут на дистанции ≈40 м (ограничена размерами площадки испытаний, а не системой), сигнал разрешается в пару импульсов, а время нарастания фронта огибающей составило ≈0,2 мс. Расчётная погрешность позиционирования при достигнутых параметрах измерений — порядка 5 см.

Полученные результаты показывают, что поставленная задача решена: предложенная система удовлетворяет сформулированным требованиям по дальности, точности и условиям эксплуатации и доведена до уровня работающего прототипа. Дальнейшая работа связана с полевыми испытаниями полной системы из четырёх якорей на открытом пространстве, интеграцией фильтра оценивания траектории и проверкой работы вблизи силового оборудования платформы.

Список литературы

[1] Вишневский, В. М. Разработка и исследование нового поколения высотных привязных телекоммуникационных платформ / В. М. Вишневский, Б. Н. Терещенко // T-Comm: Телекоммуникации и транспорт. — 2013. — № 7. — С. 20–24.
[2] Kaplan, E. D. Understanding GPS: Principles and Applications / E. D. Kaplan,
C. J. Hegarty. — 2nd edition. — Norwood, MA, USA: Artech House, 2005.
[3] Misra, P. Global Positioning System: Signals, Measurements, and Performance / P. Misra, P. Enge. — 2nd edition. — Lincoln, MA, USA: Ganga-Jamuna Press, 2006.
[4] Scaramuzza, D. Visual Odometry: Part I — The First 30 Years and Fundamentals / D. Scaramuzza, F. Fraundorfer // IEEE Robotics & Automation Magazine. — 2011. — Vol. 18, no. 4. — Pp. 80–92.
[5] Zhang, J. LOAM: Lidar Odometry and Mapping in Real-time / J. Zhang,
S. Singh // Robotics: Science and Systems X. — Berkeley, CA, USA: 2014.
[6] A Study of Vicon System Positioning Performance / P. Merriaux, Y. Dupuis,
R. Boutteau et al. // Sensors. — 2017. — Vol. 17, no. 7. — P. 1591.
[7] Localization via Ultra-Wideband Radios: A Look at Positioning Aspects for Future Sensor Networks / S. Gezici, Z. Tian, G. B. Giannakis et al. // IEEE Signal Processing Magazine. — 2005. — Vol. 22, no. 4. — Pp. 70–84.
[8] Smith, J. O. Closed-form least-squares source location estimation from rangedifference measurements / J. O. Smith, J. S. Abel // IEEE Transactions on Acoustics, Speech, and Signal Processing. — 1987. — Vol. 35, no. 12. — Pp. 1661–1669.
[9] Chan, Y. T. A simple and efficient estimator for hyperbolic location / Y. T. Chan,
K. C. Ho // IEEE Transactions on Signal Processing. — 1994. — Vol. 42, no. 8. — Pp. 1905–1915.
[10] Mautz, R. Indoor Positioning Technologies: Habilitation Thesis / ETH Zurich. — Zurich, Switzerland, 2012.

[11] The Anatomy of a Context-Aware Application / A. Harter, A. Hopper,
P. Steggles et al. // Wireless Networks. — 2002. — Vol. 8, no. 2–3. — Pp. 187–197.
[12] Priyantha, N. B. The Cricket Location-Support System / N. B. Priyantha,
A. Chakraborty, H. Balakrishnan // Proceedings of the 6th Annual International Conference on Mobile Computing and Networking (MobiCom). — Boston, MA, USA: 2000. — Pp. 32–43.
[13] Marvelmind Robotics. — Marvelmind Indoor Navigation System: Operating Manual. — Marvelmind Robotics, 2026. — Руководство пользователя. URL: https://marvelmind.com (дата обращения: 15.06.2026).
[14] International Organization for Standardization. Acoustics — Attenuation of sound during propagation outdoors — Part 1: Calculation of the absorption of sound by the atmosphere: Tech. Rep. ISO 9613-1:1993 / International Organization for Standardization. — Geneva, Switzerland: ISO, 1993.
[15] Cramer, O. The variation of the specific heat ratio and the speed of sound in air with temperature, pressure, humidity, and CO2 concentration / O. Cramer // Journal of the Acoustical Society of America. — 1993. — Vol. 93, no. 5. — Pp. 2510–2516.
[16] Buck, A. L. New Equations for Computing Vapor Pressure and Enhancement Factor / A. L. Buck // Journal of Applied Meteorology. — 1981. — Vol. 20, no. 12. — Pp. 1527–1532.
[17] Bosch Sensortec. — BME280 — Combined Humidity and Pressure Sensor. Datasheet BST-BME280-DS002. — Bosch Sensortec GmbH, Rev. 1.6 edition, 2018.
[18] International Organization for Standardization. Standard Atmosphere: Tech. Rep. ISO 2533:1975 / International Organization for Standardization. — Geneva, Switzerland: ISO, 1975.
[19] Kay, S. M. Fundamentals of Statistical Signal Processing: Estimation Theory /
S. M. Kay. — Upper Saddle River, NJ, USA: Prentice Hall, 1993.

[20] Hayes, M. H. Statistical Digital Signal Processing and Modeling / M. H. Hayes. — New York, NY, USA: Wiley, 1996.
[21] Manolakis, D. E. Efficient Solution and Performance Analysis of 3-D Position Estimation by Trilateration / D. E. Manolakis // IEEE Transactions on Aerospace and Electronic Systems. — 1996. — Vol. 32, no. 4. — Pp. 1239–1248.
[22] Nocedal, J. Numerical Optimization / J. Nocedal, S. J. Wright. — 2nd edition. — New York, NY, USA: Springer, 2006.
[23] Decawave. — DW1000 User Manual: How to Use, Configure and Program the DW1000 UWB Transceiver. — Decawave Ltd., Version 2.05 edition, 2015.
