egormeister02/Ultrasonic-LNS/ultrasonic-navigation.pdf

## Ультразвуковая локальная навигация

Смирнов Егор Ильич

## 1 Введение

Надёжная локальная навигация является одним из ключевых условий безопасной и устойчивой работы беспилотных летательных аппаратов в стеснённых пространствах и в условиях ухудшенного или отсутствующего приёма сигналов глобальных навигационных спутниковых систем (GNSS/ГЛОНАСС). Даже в случае привязного летательного аппарта, когда полёт механически ограничен тросом, задача точного и быстрого определения координат остаётся критичной: она необходима для стабилизации и компенсации внешних возмущений (ветер, натяжение троса), а также для реализации режимов удержания позиции и сопровождения объектов. Это особенно важно для БПЛА, несущих на себе телекоммуникационное оборудование. Область покрытия и возможность передачи сигнала напрямую зависят от положения летательного аппарата.
На практике применяются различные подходы к локализации БПЛА. Спутниковая навигация (GNSS, включая дифференциальные и RTK-решения) обеспечивает абсолютные координаты на открытой местности, однако её точность и доступность существенно снижаются вблизи сооружений, в условиях загрязненного эфира, внутри помещений и в городской застройке. Визуальные методы (оптический поток, визуальная одометрия, визуально-инерциальные системы) способны обеспечивать высокую точность, однако зависят от освещённости, текстуры сцены и динамики окружающей среды; кроме того, они, как правило, требуют значительных вычислительных ресурсов. Лидарная одометрия отличается хорошей информативностью, однако сильно зависима от погодных условий. Инфраструктурные системы захвата движения (motion capture) обеспечивают выдающуюся точность, но применимы только в специально оборудованных зонах и дорогостоящи в развёртывании. Ультразвуковая навигация представляет собой привлекательный вариант для задач ближнего радиуса действия благодаря низкой стоимости, малому энергопотреблению и доступности компактных излучателей и приёмников. В таких системах положение объекта оценивается по времени распространения акустического сигнала между передатчиками и приёмниками с последующим пересчётом временных измерений в расстояния на основе величины скорости звука. В зависимости от архитектуры могут применяться схемы измерения времени пролёта (ToF — от англ. Time of Flight), разности времён прихода (TDoA — от англ. Time Difference of Arrival) или их комбинации с геометрическими методами триангуляции/мультилатерации. В отличие от чисто бортовых методов измерения, ультразвуковые системы позволяют опираться на внешние маяки и могут сохранять работоспособность даже в тех условиях, где оптика даёт сбои. Вместе с тем ультразвуковое позиционирование имеет ограничения: сравнительно малую дальность и отражения сигнала от поверхностей.
В настоящей работе рассматривается задача локальной навигации привязного БПЛА относительно платформы (в том числе потенциально подвижной) с использованием ультразвуковых измерений в качестве основного источника координатной информации.

## 2 Описание системы

Рассматриваемая система состоит из привязного БПЛА и наземной платформы, на которой размещается ультразвуковая опорная подсистема. Платформа может быть стационарной или мобильной, поэтому все измерения и вычисления выполняются в системе координат, связанной с платформой, а при необходимости, учитываются её наклоны.
В базовой конфигурации на платформе устанавливаются несколько ультразвуковых опорных узлов (далее — якоря), разнесённых на максимально возможное расстояние друг от друга. Геометрия якорей считается известной: координаты каждого якоря заранее задаются в системе координат платформы. На БПЛА размещается ответная часть — ультразвуковой излучатель или приёмник (в зависимости от выбранной архитектуры), ориентированный в сторону платформы и работающий в зоне прямой видимости опорных узлов.


Рис. 1: Общая схема системы локальной навигации привязного БПЛА относительно платформы

Принцип работы системы следующий. Опорные узлы на платформе и бортовой узел на БПЛА формируют набор измерений времени распространения акустических импульсов. По измеренным временам вычисляются расстояния до якорей, после чего координаты БПЛА определяются методом трилатерации в системе координат платформы.
Для получения корректных расстояний требуется синхронизация времени между передающей и принимающей сторонами. В привязном варианте синхронизирующий сигнал может быть передан по кабелю-тросу; альтернативно возможна радиосинхронизация.
Если платформа подвержена наклонам, на ней размещается инерциальный датчик (например, акселерометр/IMU), позволяющий оценивать ориентацию платформы относительно горизонта и, при необходимости, пересчитывать координаты из платформенной системы координат в требуемую внешнюю систему отсчёта.

## 3 Математическое описание системы

### 3.1 Максимальная дальность работы

Под дальностью работы нужно понимать максимальное расстояние между излечателем и приемником, при котором приемник может стабильно детектировать сигнал.
Это расстояние зависит от нескольких факторов:
- Мощность излучателя
- Чувствительность приемника
- Уровень шума в среде
- Затухание звукового сигнала в среде

Остановимся подробнее на затухании звука. Интенсивность звука убывает с расстоянием как:

I(x) = I0e

−αx | (1)

α — коэффициент затухания, дБ/м

Согласно стандарту ISO 9613-1:1993 [1] , коэффициент затухания рассчитывается по формуле:

α = 8.686·f

2
·
1.84 · 10−11
·

pr
pa

·

(
T
Tr

)0.5
+

(
T
Tr

)−2.5
·

0.01275 · e

−2239.1/T

fr,O +

f

2
fr,O

+

0.1068 · e

−3352.0/T

fr,N +

f

2
fr,N

(2)
где:
- α — коэффициент затухания, дБ/м;
- f — частота звука, Гц;
- pa — атмосферное давление, кПа;
- pr = 101.325 кПа — опорное давление;
- T — температура воздуха, К;
- Tr = 293.15 К — опорная температура;
- fr,O — частота релаксации кислорода, Гц;
- fr,N — частота релаксации азота, Гц.

Частоты релаксации рассчитываются по формулам:

fr,O =

pa
pr

(
24 + 4.04 · 10⁴h

0.02 + h
0.391 + h

)
(3)

fr,N =

pa
pr

(
T
Tr

)−1/2 (

9 + 280 · h · exp (

−4.170 [(
T
Tr

)−1/3

])) (4)

где h — молярная концентрация водяного пара:

h = hr ·

psat
pa

(5)

Здесь hr — относительная влажность, psat — давление насыщенного пара, которое рассчитывается по формуле:

psat = pr · 10−6.8346·

(
T01
T

)1.261
+4.6151 | (6)

где T01 = 273.16 К — температура тройной точки воды.

По формуле (2) видно, что коэффициент затухания прямо пропорционален квадрату частоты f. Поэтому для обеспечения максимальной дальности частоты необходимо выбирать как можно ниже.

Для текущей системы была выбрана частота 25 кГц, она достаточно низкая для обеспечения дальности и при этом находится вне слышимого диапазона.

Расчеты для этой частоты показали максимальное расстояние 35.6 метров. Вычисления производились при следующих параметрах:

- относительная влажность — 50%
- температура воздуха — 20 ◦C
- мощность УК излучателя — 105 дБ (SPL — Sound Pressure Level, на расстоянии 1 м от источника)
- чувствительность УК приёмника — −95 дБ

Следует отметить, что приведённая оценка является приблизительной; реальная дальность существенно зависит от конкретной реализации системы и внешних условий.

### 3.2 Точность измерений расстояния

Расстояние от БПЛА до якоря измеряется следующим образом: в известный момент времени излучатель на БПЛА испускает сигнал. Спустя некоторое время приёмник на якоре его детектирует. Так как микроконтроллеры на излучателе и приёмнике синхронизированы, время, которое потребовалось для передачи сигнала, известно. Умножив его на скорость звука, получим искомое расстояние. Значение мы будем получать с определенной погрешностью, разобьем ее на части (Рис 2)

### 3.2.1 Скорость звука

Для определения расстояния нам необходимо знать скорость звука. Именно ошибка при вычислении скорости вызывает систематическую ошибку в определении расстояний.

Скорость звука c в газе является термодинамической величиной. Для влажного воздуха в приближении идеальной газовой смеси её можно оценить по выражению

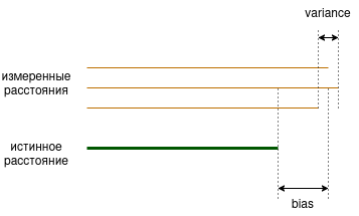
[picture p22: figure]

Рис. 2: Ошибка при определении расстояния

c =

√
γ Rmix T, | (7a)

Rmix =

R

Mmix

, | (7b)
Mmix = (1 − xv) Md + xv Mv, | (7c)

xv =

pv
p
, | (7d)
pv = h psat(T), | (7e)
psat(T) = 611.21 exp(
17.502 (T − 273.15)
T − 32.19 | )
, | (7f)

γ =

cp,mix

cv,mix

=

cp,mix

cp,mix − Rmix

, | (7g)
cp,mix = (1 − xv) cp,d(T) + xv cp,v(T). | (7h)

Выражения (7) основаны на работе [3]. Здесь psat(T) вычисляется по формуле Тетенса, применимой в диапазоне −20 . . . 50 ◦C.
После подстановки всех промежуточных величин в (7) получается явное выражение c как функции трёх измеряемых параметров (T, p, h):

c(T, p, h) = √
cp,mix(T, p, h) R T
Mmix(T, p, h)

[
cp,mix(T, p, h) − R/Mmix(T, p, h)
] , | (8)

где мольная доля пара и производные от неё величины имеют вид

xv(T, p, h) = h psat(T)
p

,

Mmix(T, p, h) = Md + xv(T, p, h) (Mv − Md),
cp,mix(T, p, h) = cp,d + xv(T, p, h) (cp,v − cp,d).cp,d ≈ 1005 J/(kg · K), cp,v ≈ 1850 J/(kg · K).

Обозначения, используемые в (7), приведены в табл. 1.

Таблица 1: Обозначения в модели скорости звука во влажном воздухе

Обозначение Значение | Единицы
c | скорость звука | м/с
T | абсолютная температура | K
p | общее давление | Pa
h | относительная влажность (0 . . . 1) | –
xv | мольная доля водяного пара | –
pv | парциальное давление пара | Pa
psat(T) | давление насыщенного пара | Pa
R | универсальная газовая постоянная (8.314462618) J/(mol · K)
Md | молярная масса сухого воздуха (0.0289652) | kg/mol
Mv | молярная масса воды (0.01801528) | kg/mol
Mmix | молярная масса смеси | kg/mol
Rmix | удельная газовая постоянная смеси | J/(kg · K)
cp,d(T) | теплоёмкость сухого воздуха при p = const | J/(kg · K)
cp,v(T) | теплоёмкость водяного пара при p = const | J/(kg · K)
cp,mix | теплоёмкость смеси при p = const | J/(kg · K)
cv,mix | теплоёмкость смеси при V = const | J/(kg · K)
γ | показатель адиабаты смеси | –

Погрешность измерения параметров среды. Для расчёта скорости звука по формулам (7) требуются значения температуры T, давления p и относительной влажности h. В реальной системе эти параметры измеряются датчиками, что вносит дополнительную погрешность в определение скорости звука.
В качестве датчика рассмотрим:
- BME280 (температура, давление, влажность): погрешность температуры ±0.5

◦C,
погрешность давления ±1.2 hPa (±120 Pa), погрешность влажности ±3%.

Погрешность модели. Погрешность модели ∆мод определяется совокупностью приближений, использованных при выводе формул (7). Рассмотрим составляющие:

1. Приближение идеального газа. Уравнения (7) основаны на модели идеального газа. Реальные свойства воздуха описываются вторыми вириальными коэффициентами. Согласно анализу Cramer [3], учёт нелинейности уравнения состояния вносит поправку порядка 10−4
(∼ 0.03 м/с). Принимаем ∆ид ≈ 0.05 м/с с запасом.
2. Упрощение теплоёмкостей. В формулах (7) теплоёмкости cp,d и cp,v принимаются постоянными. На самом деле они зависят от температуры. При изменении температуры от 0 до 40 ◦C относительное изменение cp,d составляет около 0.1%, что даёт погрешность скорости звука ∆cp ≈ 0.3 м/с.
3. Формула Тетенса. Для расчёта давления насыщенного пара psat(T) используется формула Тетенса, применимая в диапазоне −20 . . . 50 ◦C с относительной погрешностью менее 0.5%. Влияние на скорость звука незначительно: ∆Тетенс ≈
0.01 м/с.
4. Физические константы. Универсальная газовая постоянная R и молярные массы Md, Mv известны с точностью лучше 10−5
(CODATA), их вклад пренебрежимо мал.

Полная погрешность модели по закону накопления погрешностей:

∆мод =

√
∆²

ид + ∆²

cp + ∆²
Тетенс =

√
0.05² + 0.30² + 0.01² ≈ 0.31 m/s. | (9)

Полная погрешность скорости звука. Погрешность определения c складывается из погрешностей измерения параметров и погрешности модели:

∆c =

√(
∂c
∂T ∆T

)2
+

(
∂c
∂p∆p

)2
+

(
∂c
∂h∆h

)2
+ ∆²
мод. | (10)

Для оценки частных производных при околонормальных условиях (T ≈ 293 K, p ≈ 101325 Pa, h ≈ 0.5) получаем:

∂c
∂T
≈ 0.60 m/(s · K), | (11)

∂c
∂p
≈ −4.7 · 10−4 m/(s · Pa), | (12)

∂c
∂h
≈ 0.08 m/s. | (13)

Подставляя погрешности датчиков BME280 (∆T = 0.5 K, ∆p = 120 Pa, ∆h = 0.03) и
∆мод = 0.31 м/с:
∆cT = 0.60 · 0.5 = 0.30 m/s, | (14)
∆cp = 4.7 · 10−4
- 120 ≈ 0.06 m/s, | (15)
∆ch = 0.08 · 0.03 ≈ 0.002 m/s. | (16)

Полная погрешность:

∆c =

√
0.30² + 0.06² + 0.002² + 0.31² ≈

√
0.186 ≈ 0.43 m/s. | (17)

Таким образом, при использовании датчиков среднего класса точности полная погрешность определения скорости звука составляет около ±0.43 m/s (∼ ±0.13%). Основной вклад вносят погрешность измерения температуры (∼ 70%) и погрешность модели (∼ 52%); влияние давления и влажности значительно меньше.

Проверка по табличным данным. Для верификации оценки погрешности модели выполним сравнение расчётного значения скорости звука с табличными данными при стандартных условиях (сухой воздух, T = 273.15 K, p = 101325 Па, h = 0). По формулам (7) при h = 0 получаем xv = 0, Mmix = Md, Rmix = R/Md, γ = cp,d/(cp,d − Rmix), откуда

cрасч =

√
γ

R
Md

T =

√
1.402 ·

8.314
0.028965
- 273.15 ≈ 331.3 m/s. | (18)

Табличное значение скорости звука в сухом воздухе при 0

◦C и нормальном атмосферном давлении согласно [2] составляет cтабл = 331.29 м/с. Разница между расчётным и табличным значениями:

∆cпроверка = |cрасч − cтабл| ≈ |331.3 − 331.29| = 0.01 m/s. | (19)

Полученное расхождение (∼ 0.003%) значительно меньше оценённой погрешности модели ∆мод ≈ 0.31 м/с, что подтверждает корректность оценки с запасом. Разница объясняется округлениями констант в расчёте и не учтённым влиянием реальных свойств газа (вторые вириальные коэффициенты), которое как раз и даёт основной вклад в ∆мод.

Выводы. Проведённый анализ показал, что при использовании недорогих датчиков типа BME280 основная погрешность определения скорости звука (∼ 0.43 м/с) определяется погрешностью измерения температуры (0.30 м/с) и погрешностью модели (0.31 м/с). Проверка по табличным данным подтвердила, что оценка погрешности модели является консервативной (завышенной), что приемлемо для инженерных расчётов.

### 3.2.2 Точность измерений времени

Микроконтроллер измеряет время, которое потребовалось сигналу, чтобы долететь от излучателя до приемника. Он это делает дискретно, следовательно всегда будет существовать погрешность ∆t.
Ошибка измерений расстояния будет соответсвенно:

±d =

c
2∆t

(20)

Приведем характерные значения:

∆t | d
1 мкс 10 мкс 100 мкс 1000 мкс | 0.17 мм 1.7 мм 17 мм 17 см

Современные микроконтроллеры позволяют измерять время с точностью ≤ 10 мкс, это даёт ошибку в 2 мм. Именно эту ошибку мы называем случайной, она будет индивидуальной для каждого измерения.

Итоги

- Систематическая ошибка - 0.12 %
- Случайная ошибка - 2 мм

### 3.2.3 Точность определения координат

При трилатерации в трёхмерном пространстве точность определения координат зависит не только от точности измерения расстояний до якорей, но и от их геометрического расположения. Данный эффект описывается коэффициентом геометрического ослабления точности (GDOP — Geometric Dilution of Precision) [4, 5]. Коэффициент GDOP характеризует влияние геометрии расположения якорей на распространение случайных ошибок измерения расстояний в ошибку оценки координат. В рамках линейной модели оценивания с нулевым средним ошибок измерений GDOP определяет ковариацию оценки координат. Систематические ошибки приводят к смещению оценки и не описываются коэффициентом GDOP [8, 7]. Постановка задачи. Рассмотрим четыре якоря, расположенные в вершинах квадрата в плоскости z = 0:

A1(+a/2, +a/2, 0), | A2(−a/2, +a/2, 0), | A3(−a/2, −a/2, 0), | A4(+a/2, −a/2, 0).

Объект находится в точке P(0, 0, H) на высоте H над центром квадрата. Измеренные расстояния до якорей:

| di =

√
(x − xi)

2 + (y − yi)

| | 2 + (z − zi) 2 + εi
,

где εi — случайная ошибка измерения с дисперсией σ

| | 2 d

Матрица Якоби. Линеаризуем уравнения в окрестности истинной позиции. Пусть
D =

√
a

2/2 + H² — расстояние от объекта до каждого якоря. Матрица Якоби имеет вид:

J =

+

a
2D +

a
2D −

H
D
−

a
2D +

a
2D −

H
D
−

a
2D −

a
2D −

H
D
+

a
2D −

a
2D −

H
D

Вычисление J

T J. Благодаря симметрии расположения якорей матрица J

T J является диагональной:

J

T J =

a

2
D² | 0 | 0
0 | a
| 2
| D² | 0
0 | 0 | 4H²
| | D²

Ковариационная матрица и GDOP. В рамках метода наименьших квадратов ковариационная матрица оценки координат определяется выражением [7, 8]:

Σ = σ

2
d

(J

| T J)

−1

Отсюда:

Σ = σ

2
d

D²
a
2 | 0 | 0
0 | D²
| a
| 2 | 0
0 | 0 | D²
| | 4H²

Среднеквадратичная ошибка положения (PDOP — Position Dilution of Precision) определяется как:

σxyz =

√
tr(Σ) = σd

√
| | 2D²
| | a
| | 2

+

D²
4H²

Подставляя D² =

a

2
2 + H²
, получаем:

σxyz = σd · D ·

√
2
a

2

+

1
4H²

где:

- σxyz — среднеквадратичная ошибка положения, м;
- σd — СКО измерения расстояния до якоря, м;
- D =

√
a

2/2 + H² — расстояние до якоря, м;

- a — расстояние между якорями, м;
- H — высота объекта, м.

На рис. 3 представлена зависимость ошибки позиционирования от взаимного расположения якорей при фиксированной ошибке измерения σd = 2 мм и расстоянии до якорей D = 25 м.

Оценка погрешности. Рассмотрим характерные параметры системы: высота объекта H = 25 м, расстояние между якорями a = 2 м. В этом случае:

- систематическая ошибка измерения расстояния приводит к смещению оценки порядка 3 см;
- случайная ошибка измерений с учётом эффекта GDOP приводит к СКО порядка 5 см.

Таким образом, суммарная ошибка позиционирования в худшем случае может достигать порядка 8 см.

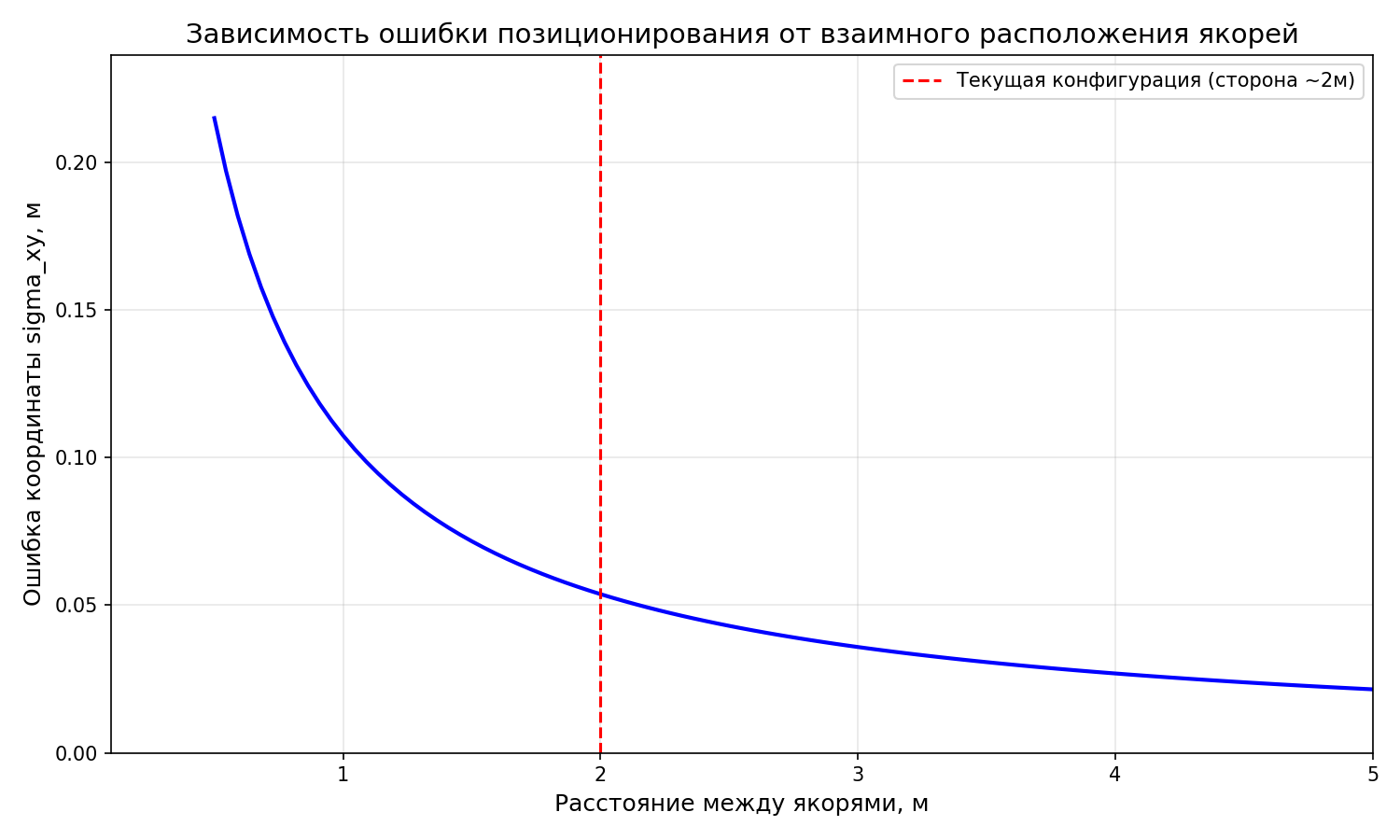
[picture p23: figure]

Рис. 3: Зависимость ошибки позиционирования от геометрии расположения якорей

### 3.3 Методы решения задачи трилатерации

Для получения координат БПЛА при известных расстояниях до якорей необходимо решить задачу трилатерации. Для её решения в настоящей работе рассмотрены два метода: аналитический и вычислительный метод Гаусса-Ньютона. В экспериментах были протестированы несколько вычислительных методов и все они дали идентичные результаты, поэтому предпочтение отдано методу Гаусса-Ньютона ввиду его низкой вычислительной сложности.

### 3.3.1 Аналитическое решение задачи трилатерации в пространстве по трём

расстояниям

Пусть заданы три опорные точки в плоскости z = 0:

P1 = (x1, y1, 0), | P2 = (x2, y2, 0), | P3 = (x3, y3, 0),

и измеренные расстояния от неизвестной точки P = (x, y, z) до них:

| r1, r2, r3.

### 1. Уравнения сфер

Координаты точки P удовлетворяют системе уравнений трёх сфер:

(x − xi)

2 + (y − yi)

| 2 + z 2 = r
| 2 i
| , | i = 1, 2, 3.

### 2. Получение линейной системы для координат x и y

Вычтем уравнения для i = 2 и i = 3 из уравнения для i = 1. Так как член z

2 присутствует во всех трёх уравнениях, он сокращается. Получаем:

2(x2 − x1)x + 2(y2 − y1)y = r

2
1 − r

2
2 + x

2
2 − x

2
1 + y

2
2 − y
2/1, | (21)

2(x3 − x1)x + 2(y3 − y1)y = r

2
1 − r

2
3 + x

2
3 − x

2
1 + y

2
3 − y
2/1. | (22)

В матричной форме:

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
2(x2 − x1) 2(y2 − y1)
2(x3 − x1) 2(y3 − y1)

)
,

b1 = r

2
1 − r

2
2 + x

2
2 − x

2
1 + y

2
2 − y
2/1, b2 = r

2
1 − r

2
3 + x

2
3 − x

2
1 + y

2
3 − y
2/1.
Если опорные точки не коллинеарны, то det A ̸= 0, и система имеет единственное решение:
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
### 3. Определение координаты z

После нахождения x и y подставим их в первое уравнение сферы:

z

2 = r

2
1 − (x − x1)

2 − (y − y1)

2

Отсюда:
z = ±

√
r

2
1 − (x − x1)

2 − (y − y1)

2 .

Если
r

2
1 − (x − x1)

2 − (y − y1)

2 < 0,

то система не имеет действительных решений (данные несовместны).
Поскольку сферы симметричны относительно плоскости z = 0, существует максимум два решения, соответствующие различным знакам корня. В данной задаче выбирается решение с положительной высотой:

z > 0.

### 4. Итоговое решение

Искомая точка пересечения сфер:

P = (x, y, z),

где (x, y) находятся из линейной системы

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
а координата z определяется как

z =

√
r

2
1 − (x − x1)

2 − (y − y1)

2 .

При этом берётся корень со знаком «плюс», так как требуется решение с z > 0.

### 3.3.2 Метод Гаусса-Ньютона

Этот метод используется для минимизации суммы квадратов, с учётом нашей задачи, функция для минимизации будет выглядеть следующим образом:

min
p

J(p), J(p) = ∑ N

i=1

wi

(

# rˆi − ∥p − ai∥

)2

- rˆi — измеренное расстояние от якоря i до объекта .
- ai — вектор координат i-го якоря.
- p — вектор неизвестных координат объекта.
- wi — вес измерения i (обычно обратный дисперсии).
- J(p) — целевая функция суммы взвешенных квадратов невязок.

Подробное изложение метода выходит за рамки настоящей работы; его описание можно найти в [7]. В качестве начального приближения целесообразно использовать предыдущую позицию БПЛА или данные инерциальной навигационной системы: при хорошем начальном приближении метод сходится за единичное число итераций, что обеспечивает низкие вычислительные затраты.

### 3.3.3 Сравнительный анализ

Для сравнения точности этих методов был проведён численный эксперимент в программе на Python.

Постановка эксперимента
Рассмотрим конфигурацию из 4 якорей, расположенных по углам квадрата с шириной 2 метра, далее
- Выбираем случайные координаты БПЛА, примерно в 25 метрах над платформой
- Измеряем расстояния от обьекта до якорей
- Подмешиваем в расстояния систематическую и случайную ошибку
- Передаем расстояния в вычислительные методы и получаем результат.
- Вычисляем ошибку координат

Эксперимент с 5 якорями проводится аналогично, пятый якорь добавляется в центр квадрата.
Аналитический метод предполагает известные расстояния только до трех точек, поэтому мы будем вычилсять координаты для каждой тройки точек в отдельности.

Рис.3 выбор троек точек

Далее полученные координаты усредняем по всем тройкам.

Вычислительный же метод работает следующим образом: в качестве начального прилижение будет браться аналитическое решение по любой из троек, далее следуют итерации метода Гаусса-Ньютона, учитывающие расстояние до всех якорей.

Результаты
Систематическая ошибка одинаково влияет на точность аналитического и вычислительного метода, поэтому в экспериментах она имеет фиксированное значение в 0.12 %.
Посмотрим на точность методов в зависимости от случайной ошибки:


каждая точка на графике соответсвует средней ошибке по 50 измеерениям.

- 4 якоря: результаты почти одинаковые.
- 5 якорей: аналитический метод показывает себя лучше при больших значениях ошибки, и хуже при малых. Ухудшение точности на малых ошибках можно обьяснить тем, что в конфигурации из 5 якорей существуют тройки, где якоря находятся ближе дрг к другу. Это повышает GDOP ошибку и ухудшает общий результат при усреднении.

В таблицах приведены средние значения ошибки по 1000 измерений, в зависимости от разных значений случайной ошибки

Таблица 2: Аналитический метод

σ, м | 4 якоря, см | 5 якорей, см
0.002 | 3.44 | 15.51
0.005 | 6.98 | 16.56
0.01 | 12.78 | 18.87
0.05 | 62.52 | 57.98
0.1 | 128.21 | 116.31

Таблица 3: Метод Гаусса-Ньютона

σ, м | 4 якоря, см | 5 якорей, см
0.002 | 3.44 | 3.43
0.005 | 6.83 | 6.69
0.01 | 12.96 | 12.59
0.05 | 62.68 | 62.58
0.1 | 128.78 | 125.42

В нашей системе случайная ошибка имеет значение 0.002 метра, при этом полная ошибка позиционирования в среднем не превышает 4 см, что полностью укладывается в теоритические оценки.
Аналитический метод вычислительно проще метода Гаусса-Ньютона, и оптимально будет использовать именно его, на конфигурации из 4 якорей.

## 4 Реализация

### 4.1 Узел БПЛА (передающая часть)

Узел БПЛА выполняет две задачи: излучение пачек ультразвукового сигнала на частоте 25 кГц с амплитудной OOK-модуляцией (On–Off Keying — двухуровневая амплитудная манипуляция, при которой биту «1» соответствует наличие несущей, биту «0» — её отсутствие) и радиочастотную синхронизацию начала каждой пачки с центральным узлом на платформе. Жёсткое совмещение моментов начала ультразвукового и радиоимпульса является принципиальным требованием: при заданном уровне точности ToF на уровне миллиметра рассогласование между фактическим стартом акустического сигнала и зафиксированным радиосинхросигналом не должно превышать нескольких микросекунд.

### 4.1.1 Структурная схема

В состав узла входят микроконтроллер ESP32-WROOM-32, сверхширокополосный (UWB) радиомодуль DWM1000 (Decawave/Qorvo), счетверённый аналоговый ключ SN74HC4066N, мостовой драйвер TC4427A и пьезоизлучатель Murata MA40S4S (рис. 4). ESP32 формирует непрерывную несущую 25 кГц на одном из выводов LEDC и одновременно конфигурирует DWM1000 по интерфейсу SPI. Открытие тракта несущей на драйвер выполняется аппаратно сигналом EXTTXE радиомодуля.

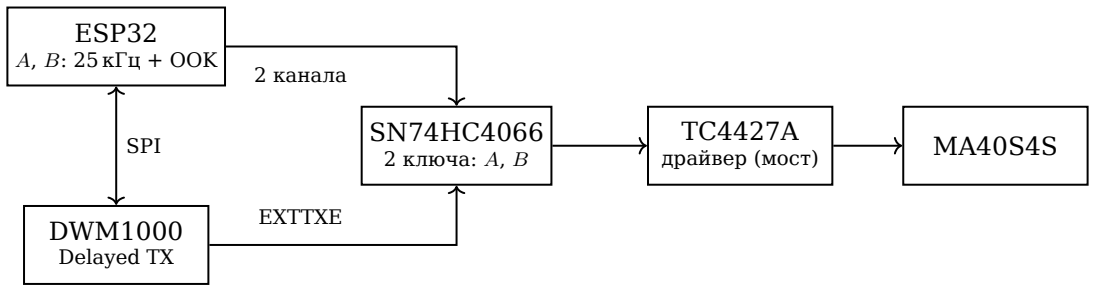
[picture p24: figure]
ESP32 A, B: 25 кГц + OOK; DWM1000 Delayed TX; SN74HC4066 2 ключа: A, B; TC4427A SPI; драйвер (мост); 2 канала; EXTTXE

Рис. 4: Структурная схема узла БПЛА: ESP32 формирует два противофазных канала несущей 25 кГц (A и B) для дифференциального возбуждения моста и управляет радиомодулем DWM1000 по SPI; в момент старта UWB-пакета модуль аппаратно открывает оба аналоговых ключа SN74HC4066 общим сигналом EXTTXE.

### 4.1.2 Аппаратная синхронизация через EXTTXE

Источники временной погрешности при синхронизации можно разделить на два принципиально различных типа: случайный джиттер и фиксированную задержку. Эти величины по-разному влияют на точность ToF, и схема построена так, чтобы исключить один и поглотить другой.
Случайный джиттер (опасен). Программный запуск передачи в ESP32 проходит через прерывания операционной системы FreeRTOS. Время реакции на прерывание зависит от состояния планировщика, кэшей инструкций и обработчиков более приоритетных прерываний; результирующий разброс момента старта составляет 1–5 мкс. Этот разброс непредсказуем и не воспроизводится от пакета к пакету, поэтому он напрямую переходит в погрешность ToF: при ∆t = 1 мкс ошибка дальности ∆d = c ∆t ≈ 0,34 мм. При требуемой точности на уровне миллиметра такой джиттер недопустим.
Фиксированная задержка (безопасна). Радиочастотной цепи DWM1000 от момента записи команды по SPI до фактического подъёма сигнала EXTTXE требуется ∼150 мкс на инициализацию синтезатора и формирование RF-преамбулы. Эта задержка определяется аппаратными свойствами микросхемы и постоянна с точностью до субнаносекунд от пакета к пакету. На точность ToF она не влияет: одинаковый сдвиг моментов на передающей и приёмной стороне сокращается при вычитании разности времён, а постоянный остаток учитывается одной аддитивной константой, определяемой при калибровке. Таким образом, важен не абсолютный момент старта, а отсутствие случайной составляющей в нём.
Решение. Применяется аппаратный механизм отложенной передачи DWM1000 (Delayed TX). ESP32 заранее, за несколько сотен микросекунд до требуемого момента, программирует по SPI время старта; далее весь процесс ведёт встроенный радиочастотный таймер модуля с шагом 15 пс. В заранее запрограммированный момент DWM1000 поднимает в высокий уровень сигнал EXTTXE (вывод GPIO5, выведенный на внешние контакты модуля). Поскольку SPI-команда подаётся заблаговременно, программный джиттер ESP32 укладывается в окно ожидания и не переходит на момент EXTTXE; стартом командует только аппаратный таймер.
Сигнал EXTTXE подаётся на разрешающие входы аналоговых ключей SN74HC4066N. Непрерывная несущая 25 кГц с выводов ESP32 попадает на драйвер только в активном состоянии EXTTXE; до этого момента и после завершения пачки путь сигнала разорван. Моменты физического начала ультразвукового излучения и UWBпередачи жёстко связаны общим логическим фронтом; взаимный джиттер между ними определяется задержками логических вентилей и не превышает 10 нс, что соответствует ошибке ToF ∆d ≈ 3,4 мкм — пренебрежимо мало по сравнению с погрешностью детектирования переднего фронта огибающей.
В начале каждой OOK-посылки формируется преамбула из нескольких пустых периодов несущей. Её роль вспомогательная — дать времени отработать переходные процессы пьезопреобразователя и приёмного тракта; информационные биты идут после преамбулы и потому не теряются.

### 4.1.3 Управление мостом и активное гашение пьезоизлучателя

Драйвер TC4427A построен по мостовой (полу-H) схеме и питает пьезопреобразователь дифференциально, то есть напряжением между двумя своими выходами. Чтобы получить двуполярное возбуждение, на оба входа драйвера приходят два сигнала с двух выводов ESP32; во всё время передачи оба пути активны, поэтому в работе одновременно участвуют оба ключа SN74HC4066N. Один ключ коммутирует первый сигнал (A) от ESP32 ко входу INA драйвера, второй — сигнал (B) ко входу INB. Общим разрешающим сигналом для обоих ключей служит EXTTXE, что обеспечивает строго одновременное открытие путей и сохраняет наносекундную привязку к UWB-пакету.
Кодирование OOK задаётся не коммутацией ключей, а соотношением фаз сигналов A и B, формируемых ESP32:
- на бите «1» A и B противофазны (сдвиг 180◦
): INA и INB противоположны, выходы драйвера формируют дифференциальный размах ±VDD на излучателе — передача несущей;
- на бите «0» A и B совпадают (сдвиг 0

◦
): INA = INB, оба выхода драйвера переключаются синхронно и в каждый момент находятся на одном уровне. Дифференциальное напряжение на излучателе равно нулю, а сам излучатель оказывается замкнут через нижние ключи моста с малым сопротивлением открытого канала (RDS(on) ∼ 0,5 Ом).

Пьезоэлектрический преобразователь MA40S4S обладает высокой механической добротностью: после прекращения возбуждения собственные колебания затухают за ∼400 мкс. Без принудительного гашения это создаёт «мёртвую зону» после каждого переданного символа и ухудшает разделение OOK-битов. В предложенной схеме на бите «0» запасённая в пьезопреобразователе механическая энергия диссипируется через мост на сопротивлении RDS(on)

, то есть гасится активно за время порядка одного периода несущей.
Управляющие входы двух неиспользуемых ключей микросхемы SN74HC4066N подтянуты к общему проводу резисторами 10 кОм, гарантируя их закрытое состояние.

### 4.2 Узел якоря: обработка сигнала

Цепь обработки сигнала каждого якоря включает четыре последовательных блока (рис. 5): предусилитель INA128P, усилитель TL072CN (два каскада: ФНЧ и ФВЧ) и демодулятор (детектор огибающей совместно с компаратором LM311P). Пьезоприёмник является механическим резонатором: любое акустическое воздействие — хлопок, удар, вибрация — преобразуется в затухающие колебания на той же частоте 25 кГц, что и полезный сигнал. Поэтому полосовой фильтр не позволяет отличить полезный сигнал от механического шума. Надёжное распознавание обеспечивается временным кодированием: передатчик излучает пачки длительностью 0,5–2 мс, а микроконтроллер идентифицирует сигнал по временному шаблону. Фильтр выполняет вспомогательную роль: подавляет электрические помехи в схеме (наводки питания, ВЧ-мусор), что позволяет поднять коэффициент усиления без перегрузки.

Предусилитель
INA128P, G≈25–100

Усилитель
TL072CN, K≈64

Демодулятор
огибающая + порог

УЗ
приёмник | МК

Рис. 5: Структурная схема цепи обработки сигнала якоря

### 4.2.1 Предусилитель — INA128P

На первом каскаде применяется инструментальный усилитель INA128P с дифференциальным входом. Высокое выходное сопротивление пьезоприёмника обусловливает подключение резисторов 1 МОм от каждого входа на землю для задания тока смещения; конденсатор 100 пФ между входами срезает высокочастотные наводки на входных проводах. Коэффициент усиления задаётся резистором Rg между выводами RG (выводы 1 и 8), который образован последовательным соединением постоянного резистора R1 = 470 Ом и подстроечного RP1 = 1,5 кОм (Rg = R1 + RP1):

G = 1 +

50 кОм
Rg

Регулировка RP1 изменяет Rg в диапазоне 470–1970 Ом, что обеспечивает G ≈ 26–107 и позволяет подстраивать усиление под конкретный экземпляр пьезоприёмника без изменения схемы. Питание — ±12 В, вывод REF подключён к аналоговой земле.

### 4.2.2 Усилитель — TL072CN

Оба операционных усилителя микросхемы TL072CN (U1.1 и U1.2) включены как неинвертирующие усилители. Цепь обратной связи каждого каскада образована резисторами Rf = 39 кОм (R2, R4) и Rвх = 3,9 кОм (R5, R6), что даёт одинаковый коэффициент усиления:

K = 1 +

Rf

Rвх

= 1 +
3,9

= 11.


Рис. 6: Схема предусилителя INA128P

Полосовая характеристика формируется входными RC-фильтрами обоих каскадов, частоты среза которых расположены по краям рабочей полосы вокруг частоты 25 кГц.
ОУ-A — U1.1 (входной ФВЧ, fc ≈ 22 кГц). На неинвертирующий вход сигнал подаётся через фильтр верхних частот: конденсатор C1 = 330 пФ последовательно с источником, резистор R1 = 22 кОм на землю:

fc,A =

1
2πR1C1

≈ 22 кГц.

ОУ-B — U1.2 (входной ФНЧ, fc ≈ 27 кГц). На неинвертирующий вход сигнал подаётся через фильтр нижних частот: резистор R3 = 20 кОм последовательно с источником, конденсатор C2 = 300 пФ на землю:

fc,B =

1
2πR3C2

≈ 27 кГц.

На частоте 25 кГц оба фильтра работают в переходной зоне: ОУ-A — незначительно выше своей частоты среза, ОУ-B — незначительно ниже. Амплитудное ослабление на 25 кГц составляет ≈0,75 для входного ФВЧ (ОУ-A) и ≈0,73 для входного ФНЧ (ОУ-B), так что эффективный коэффициент каждого каскада Kэфф ≈ 11·0,74 ≈ 8, а суммарный коэффициент двух каскадов ≈ 64. При частотах существенно ниже 22 кГц или выше 27 кГц один из каскадов вносит значительно большее ослабление, поэтому суммарный коэффициент резко убывает — каскады совместно действуют как полосовой усилитель с центральной частотой 25 кГц.

### 4.2.3 Демодулятор

Демодулятор преобразует переменный сигнал 25 кГц в логический уровень для микроконтроллера и состоит из детектора огибающей и быстрого компаратора с гистерезисом.
Детектор огибающей построен на германиевом диоде Д9, накопительном конденсаторе C3 = 470 нФ и разрядном резисторе R3 = 20 кОм на землю; постоянная времени разряда:
τ = R3C3 = 20 · 10³
- 470 · 10−9 ≈ 9,4 мс.

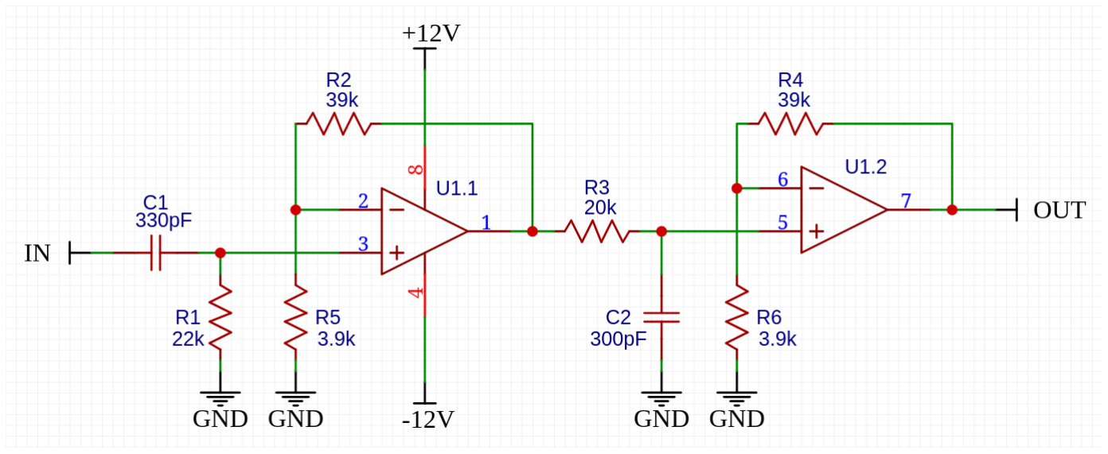
[picture p25: figure]

Рис. 7: Каскады усилителя TL072CN: ОУ-A (U1.1) — неинвертирующий усилитель с входным ФВЧ (fc≈22 кГц, KA=11), ОУ-B (U1.2) — с входным ФНЧ (fc≈27 кГц, KB=11). Питание ±12 В.

Заряд конденсатора идёт через открытый диод с малым сопротивлением, поэтому передний фронт огибающей повторяет начало пакета без задержки, тогда как разряд через R3 медленный. Большая постоянная разряда, во-первых, полностью сглаживает несущую (τ ≫ 1/(2πfнес) ≈ 6 мкс), а во-вторых — что важно для измерения по переднему фронту — удерживает выход компаратора в активном состоянии на всё время пакета, исключая ложные повторные срабатывания от пульсаций огибающей и более поздних эхо-сигналов. Германиевый диод Д9 предпочтительнее кремниевого: его падение в открытом состоянии ∼0,2 В против ∼0,6 В у 1N4148 даёт выигрыш чувствительности ∼0,4 В, что существенно для слабых сигналов на максимальной дальности.
Компаратор LM311P выбран взамен медленных операционных усилителей общего назначения (LM358) и компараторов LM393: его задержка переключения составляет ∼200 нс против ∼1,3 мкс у LM393, что вносит соответствующую погрешность ToF ∆d = c ∆t ≈ 70 мкм — существенно ниже погрешности детектирования переднего фронта. LM311P имеет выход с открытым коллектором (вывод 7), сигнал с которого подаётся на вход микроконтроллера; высокий логический уровень формируется подтягивающим резистором на стороне микроконтроллера. Питание +5 В подаётся на вывод 8, вывод 4 соединён с общей логической землёй.
Порог срабатывания задаётся делителем напряжения R2 = 100 кОм (на +5 В) и R1 = 5 кОм (на землю), подключённым к инвертирующему входу:

Vref = 5 В ·

R1
R1 + R2

= 5 ·

5
105

≈ 0,24 В,

что соответствует уровню ∼10% от пиковой амплитуды огибающей при максимальной дальности и подбирается экспериментально для каждого якоря. Положительная обратная связь резистором R4 = 1 МОм с выхода на неинвертирующий вход создаёт небольшой гистерезис и исключает дребезг при переходе огибающей через порог.


Рис. 8: Демодулятор: детектор огибающей на германиевом диоде Д9 и компаратор LM311P с открытым коллектором; порог задаётся делителем R1, R2, гистерезис — резистором R4

### 4.2.4 Самокалибровка времени прихода: двухимпульсный метод

Компаратор фиксирует момент tc пересечения огибающей фиксированного порога Vth, тогда как физическим моментом прихода прямой волны служит начало роста амплитуды t0. Огибающая нарастает за конечное время (измеренное время фронта ≈0,2 мс, см. раздел 4.6), поэтому компаратор срабатывает позже истинного прихода на величину

δ = tc − t0 ≈ τ

Vth

Vmax

,

где τ — характерное время нарастания, Vmax — амплитуда огибающей. Поскольку амплитуда сигнала убывает с расстоянием, задержка δ у дальних якорей больше, чем у ближних: для слабого сигнала на пределе дальности порог достигается почти у вершины огибающей и δ приближается к полному времени фронта (∼0,2 мс, что эквивалентно ∼70 мм по дальности), тогда как для сильного сигнала δ составляет единицы миллиметров. Это не случайный шум, а систематическое смещение, зависящее от дальности: оно не усредняется и искажает геометрию трилатерации, поэтому требует не фильтрации, а компенсации в каждом измерении.
Для этого передатчик излучает пару идентичных импульсов с известным разносом ∆Ttx ≈ 1,5–2 мс (рис. 9). Компаратор срабатывает на оба импульса, давая метки tc1 и tc2 (аппаратный захват таймером с разрешением 12,5 нс). Вокруг ожидаемого прихода второго импульса (tc1 + ∆Ttx) микроконтроллер открывает короткое окно АЦП (≈500 мкс, однократный запуск), оцифровывает нарастающий фронт его огибающей и восстанавливает по нему старт роста t0,2 (экстраполяцией фронта к базовой линии). Измеренная разность

δ = tc2 − t0,2

и есть смещение компаратора. Так как оба импульса проходят один и тот же путь и разнесены на интервал, много меньший времени изменения геометрии, их амплитуды, а значит и δ, совпадают. Несмещённую оценку времени прихода первого импульса тогда даёт
tToA = tc1 − δ = t0,1.
Подход выбран ради простоты и устойчивости. Окно АЦП работает в однократном режиме, без непрерывной потоковой оцифровки и DMA, что заметно упрощает прошивку по сравнению с согласованной фильтрацией непрерывного потока. Переотражения подавляются автоматически: эхо одинаково на обоих импульсах и потому не искажает разность δ. Разность tc2 − tc1 служит дополнительной проверкой качества: её отклонение от ∆Ttx сигнализирует о сбое (помеха, пропуск импульса) и позволяет забраковать отсчёт. Наконец, температурный дрейф добротности пьезопреобразователя (а с ней и времени фронта τ ) не требует калибровки — δ измеряется заново в каждом цикле.

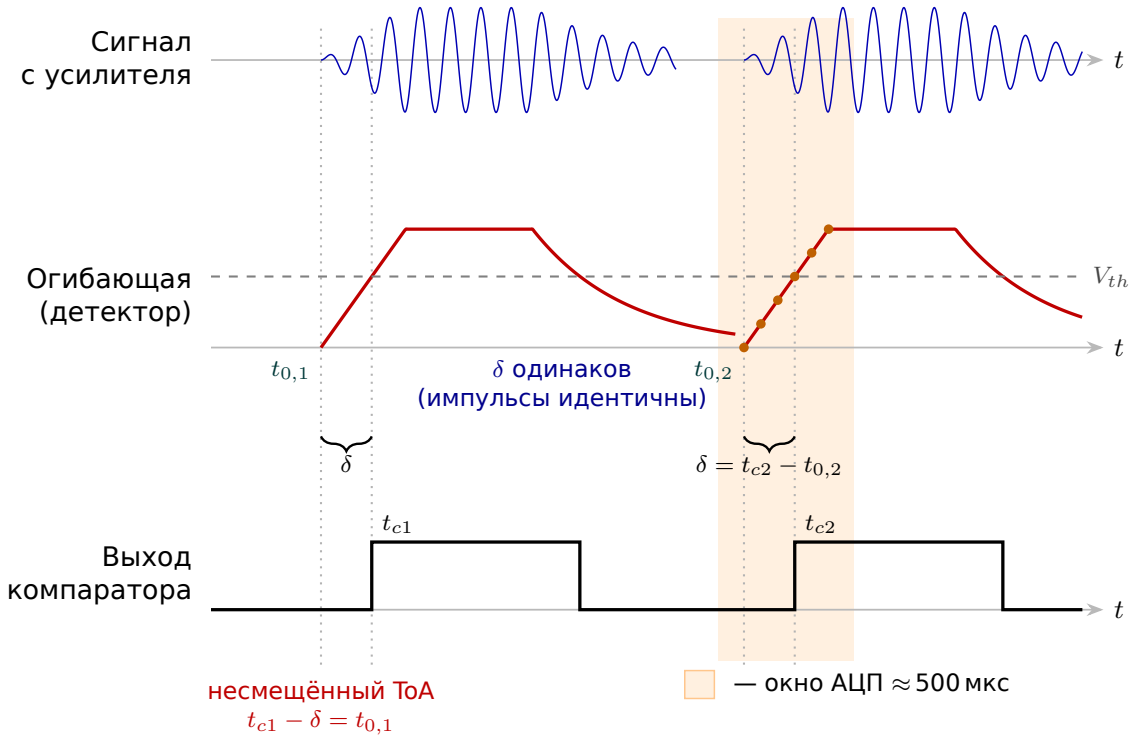
[picture p26: figure]
Сигнал с усилителя; Огибающая (детектор); Vth; Выход компаратора; δ одинаков (импульсы идентичны); несмещённый ToA; — окно АЦП ≈ 500 мкс

Рис. 9: Двухимпульсная самокалибровка времени прихода: сигнал с усилителя (две идентичные пачки 25 кГц), огибающая с порогом Vth и выход компаратора. Реальный приход t0 — начало роста амплитуды; компаратор срабатывает позже на δ. По окну АЦП на втором импульсе измеряется δ = tc2 − t0,2 и переносится на первый: tToA = tc1 −δ. Порог Vth показан завышенным относительно реального (∼10% от пика) для наглядности зазора δ.

### 4.3 Узел якоря: питание и защита от наводок

Описанный выше тракт обработки сигнала с полным усилением порядка 60 дБ особо чувствителен к наводкам по цепям питания: ничтожный уровень помехи на входной шине ±12 В усиливается операционными усилителями наравне с полезным сигналом и при недостаточной фильтрации способен полностью замаскировать сигнал полезной частоты 25 кГц.
Эта чувствительность приобретает особое значение в полевой эксплуатации. Приёмная подсистема состоит из четырёх якорей, разнесённых по периметру платформы в выбранной по условиям GDOP геометрии. Каждый якорь получает +24 В от центрального узла отдельным проводом; вместе с обратными сигнальными линиями от компараторов это образует пучок из нескольких протяжённых (несколько метров) проводных трасс, проходящих по корпусу платформы. Эти линии работают как антенны для широкополосных электромагнитных помех от штатного оборудования платформы — дизельного электрогенератора и силовых инверторов 400 В, — и являются основным каналом проникновения наводок к якорям.
Применяется трёхуровневая стратегия защиты: гальваническая развязка изолированным DC/DC-преобразователем, входная и выходная LC-фильтрация шин питания, локальная развязка по питанию каждой микросхемы.

### 4.3.1 Изолированный преобразователь A2412S-2WR3

Питание усилителя осуществляется от изолированного преобразователя Mornsun A2412S-2WR3 со следующими параметрами:

- вход — 21,6–26,4 В постоянного тока (номинал 24 В);
- выход — ±12 В постоянного тока, ток нагрузки до 83 мА на каждую шину при суммарной выходной мощности 2 Вт;
- напряжение изоляции вход/выход — 1500 В постоянного тока.

Преобразователь полностью развязывает аналоговую землю усилителя (INA128P и оба ОУ TL072CN) от шины питания платформы. Изоляция на уровне 1500 В исключает протекание паразитных токов по контуру «платформа – длинный кабель – якорь» и качественно надёжнее любого фильтрационного решения, поскольку отсекает помеху гальванически, а не подавляет её на конкретных частотах.

### 4.3.2 Входной фильтр шины 24 В

Питание подаётся от центрального узла платформы по экранированному кабелю; экран заземляется только на стороне центра (одностороннее заземление — исключает образование земляных петель). На входе якоря установлен двухзвенный фильтр (рис. 10): ферритовое кольцо (2–3 витка провода 24 В) подавляет высокочастотные наводки синфазного типа; последующее LC-звено на дросселе EC24-101K (100 мкГн), электролитическом конденсаторе 100 мкФ × 35 В и керамическом конденсаторе 100 нФ выполняет дифференциальную фильтрацию коммутационных импульсов и сглаживает просадку питания при пуске преобразователя.

### 4.3.3 Выходные LC-фильтры шин ±12 В

Собственная частота коммутации преобразователя A2412S-2WR3 составляет ∼100 кГц, что лежит выше рабочей полосы усилителя, но в пределах полосы пропускания операционных усилителей INA128P и TL072CN и потому подавляется отдельно. Для подавления коммутационного шума на каждой выходной шине установлен LC-фильтр на дросселе EC24-100K (10 мкГн) и параллельной паре конденсаторов 10 мкФ × 35 В (электролит) и 100 нФ (керамика). На шине −12 В электролитический конденсатор устанавливается в инвертированной полярности (плюс к общему проводу).

### 4.3.4 Топология земли

Аналоговая земля усилителя GNDиз и логическая земля компаратора LM311P и линии связи с центральным узлом GNDл выполнены раздельно. Питание логической части +5 В формируется отдельным линейным стабилизатором 7805 от шины 24 В, не проходя через изолированный преобразователь. Соединение GNDиз и GNDл выполнено в одной точке у компаратора (звёздная топология); эта точка соединяется с землёй центрального узла одним проводом.
Звёздная топология исключает образование замкнутых контуров по земле, по которым могли бы протекать паразитные токи от наводок и собственного коммутационного шума DC/DC. Развязка по питанию каждой микросхемы (керамика 100 нФ

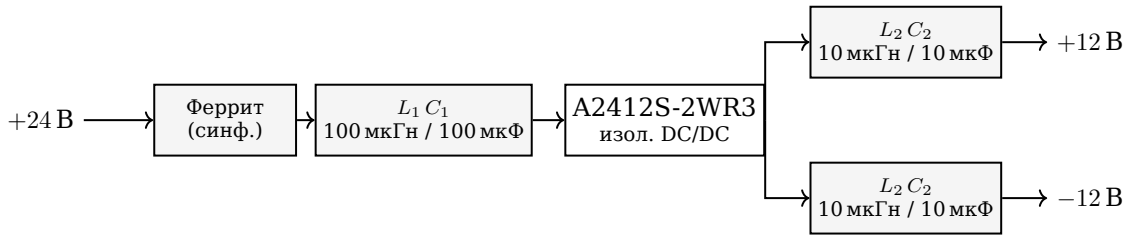
[picture p27: figure]
Феррит (синф.); L1 C1 100 мкГн / 100 мкФ; A2412S-2WR3 изол. DC/DC; L2 C2 10 мкГн / 10 мкФ

Рис. 10: Схема питания узла якоря: входной фильтр (феррит + LC) перед изолированным преобразователем A2412S-2WR3 и индивидуальные LC-фильтры на выходах ±12 В

возле каждого вывода питания INA128P, TL072CN и LM311P) подавляет высокочастотные помехи на локальном уровне.

### 4.4 Протокол UWB-линка и синхронизация узлов

Узел БПЛА и центральный (наземный) узел связаны точка-точка по UWB-каналу (DWM1000). Узел БПЛА выступает ведущим (инициирует обмен и задаёт тайминг), центральный — ведомым (реактивно отвечает на принятый кадр). Канал полудуплексный, поэтому ведущий шлёт запрос и слушает ответ, а ведомый отвечает. Запуск построен по стадиям: ни один узел не переходит к работе вслепую, пока предыдущая стадия явно не подтверждена.

### 4.4.1 Стадии запуска

1. Самотест. Каждый узел проверяет свой DWM1000 (чтение DEV_ID=0xDECA0130 и инициализация). Провал — фатальное состояние с диагностикой.
2. Рукопожатие. БПЛА шлёт PING, центр отвечает PONG: подтверждается, что UWB-канал в принципе рабочий.
3. Конфигурация. БПЛА передаёт свой тайминг (частоты несущей и пакетов, длительности импульса и зазора, разнос стартов ∆T); центр подстраивает окна детектирования с запасом и отвечает CONFIG_ACK. Это подтверждение служит точкой рандеву: центр переходит в режим ожидания первого рабочего пакета, а БПЛА получает разрешение начать рабочий цикл.
4. Рабочий цикл. БПЛА непрерывно шлёт пакеты DATA на 10 Гц синхронно с ультразвуковыми парами; центр на каждый пакет отвечает квитанцией.

Отдельная стадия проверки якорей не выделяется: исправность якоря наблюдаема прямо в рабочем цикле (отсутствие отметки от якоря=нет измерения), а её результат центр сообщает в квитанции (маска живых якорей). Если живых якорей меньше минимума для трилатерации (3 на плоскости, 4 в пространстве), центр выдаёт признак «нет решения» вместо заведомо неверной координаты.

### 4.4.2 Установление первой позиции

При частоте пакетов fп=10 Гц однозначно (без целочисленной неопределённости номера цикла) измеряется дальность лишь до

Rодн =

c
fп

=

343
10

≈ 34,3 м, тогда как рабочие дистанции достигают 100 м: на большей дальности время пролёта превышает период пакетов, и в воздухе одновременно находится более одной ультразвуковой пары. Для однозначного старта применяется приём изоляции первого пакета. После CONFIG_ACK БПЛА выдерживает паузу

τ ≥

Rмакс
c

=

100
343

≈ 0,29 с (принято 0,3 с),

в течение которой несущая выключена и акустический эфир полностью очищается от прежних сигналов. Затем БПЛА начинает штатную передачу 10 Гц. Первый пакет изолирован снизу тишиной длиной τ , поэтому первое акустическое прибытие после паузы для каждого якоря заведомо принадлежит именно ему (более поздние пакеты приходят позже и не мешают), и его время пролёта измеряется однозначно на любой дистанции до 100 м. Далее номер цикла удерживается по непрерывности: за период 0,1 с БПЛА не смещается на десятки метров, поэтому соответствие «пакет ↔приём» отслеживается без потери. До установления первого однозначного отсчёта центр помечает позицию как невалидную.

### 4.4.3 Устойчивость к перезагрузке

Стадия узла кодируется типом его ответного кадра (PONG — рукопожатие, CONFIG_ACK — конфигурация, квитанция — рабочий цикл), что позволяет обнаружить рассогласование без отдельного поля. Если узел получает от партнёра ответ, соответствующий более ранней стадии (партнёр перезагрузился), либо не получает ответа в течение N пакетов подряд (канал потерян), он возвращается к рукопожатию, после чего обе стороны заново проходят стадии. Инициатором подъёма всегда выступает БПЛА, поэтому взаимная блокировка исключена: даже если БПЛА ещё считает себя в рабочем цикле, перезагрузившийся центр ответит кадром стадии рукопожатия, и БПЛА сам опустится. Одиночные потери пакетов на сброс не влияют — они компенсируются предсказанием фильтра, а сброс инициирует лишь устойчивая регрессия стадии или продолжительная тишина. Перезагрузка БПЛА восстанавливается бесшовно (центр продолжает счёт), перезагрузка центра требует повторного установления первой позиции (∼1 с).

### 4.4.4 Формат кадров

Все кадры начинаются общей трёхбайтовой шапкой: признак системы magic=0x55, версия протокола ver и тип type. Контрольную сумму (2 байта) добавляет аппаратно сам DWM1000, в полезную нагрузку она не входит. Перечень сообщений приведён в таблице 4, формат полезной нагрузки — в таблице 5.

Таблица 4: Сообщения протокола UWB-линка

Сообщение | Код | Направление | Стадия | Назначение
PING | 0x01 | БПЛА → центр | рукопожатие | проверка | работоспособности
UWB-канала
PONG | 0x02 | центр→БПЛА | рукопожатие | ответ «канал жив»
CONFIG | 0x03 | БПЛА → центр конфигурация | объявление тайминга передат-
| | | | чика
CONFIG_ACK 0x04 | центр→БПЛА конфигурация «принято, ожидаю первый па-
| | | | кет»
DATA | 0x06 | БПЛА → центр | рабочий цикл | рабочий пакет, синхронный с
| | | | УЗ-парой
ACK | 0x05 | центр→БПЛА | рабочий цикл | квитанция: стадия, маска яко-
рей, валидность фикса

Таблица 5: Полезная нагрузка кадров (поля после общей шапки 3 Б; в столбце «Длина» — полный размер кадра, CRC 2 Б DWM1000 добавляет сверх него)

Кадр | Поля полезной нагрузки (тип) | Длина
PING/PONG | node_id (u8) | 4 Б
CONFIG | node_id (u8), | carrier_hz (u16),
packet_rate_hz (u8), | pulses_per_pkt (u8),
pulse_us (u16), gap_us (u16), dt_us (u16)

14 Б

CONFIG_ACK node_id (u8), status (u8) | 5 Б
DATA | pulse_idx (u8), seq (u32), паддинг до задан-
ной длительности импульса

8 Б + пад.

ACK | node_id (u8), status (u8), anchor_mask (u8),
fix_valid (u8), boot_range (u16)

9 Б

### 4.5 Список элементной базы

В таблице 6 приведена сводка основной элементной базы прототипа, закупленной для лабораторной сборки.

Таблица 6: Список элементной базы прототипа

# | Компонент | Корпус | Назначение

1 | ESP32-WROOM-32 | модуль | МК узла БПЛА: генерация 25 кГц + OOK, SPI к UWB
2 | DWM1000 (Decawave/Qorvo) | модуль | UWB-трансивер с выводом EXTTXE; 1 на БПЛА, 1
| | | на платформе
3 | SN74HC4066N (TI) | DIP-14 | Аналоговые ключи: коммутация УЗ-несущей и ак-
| | | тивное гашение
4 | TC4427A | DIP-8 | Мостовой драйвер пьезоизлучателя
5 | MA40S4S (Murata) | THT | Пьезопреобразователь 25 кГц, диаграмма ±15◦
6 | A2412S-2WR3 (Mornsun) | модуль | Изолированный | DC/DC: | 24 В→ | ±12 В, | 2 Вт,
| | | изол. 1500 В
7 | INA128P (TI) | DIP-8 | Инструментальный ОУ, предусилитель якоря, G ≈
| | | 100
8 | TL072CN | DIP-8 | Двухкаскадный полосовой усилитель якоря, K ≈64
9 | LM311P (TI) | DIP-8 | Компаратор с гистерезисом, задержка ∼200 нс
10 | LM7805 | TO-220 | Линейный стабилизатор +5 В для логической части
11 | Д9 | THT | Германиевый диод детектора огибающей, Uпр ≈0,2 В
12 | EC24-101K | THT, акс. | Дроссель 100 мкГн, входной LC-фильтр
13 | EC24-100K | THT, акс. | Дроссель 10 мкГн, выходные LC-фильтры ±12 В
14 | 100 мкФ / 35 В | THT | Электролит входного фильтра
15 | 10 мкФ / 35 В | THT | Электролиты выходных фильтров ±12 В
16 | 100 нФ керамика | THT/SMD | Локальная развязка по питанию каждой ИС
17 | Ферритовое кольцо | — | Подавление ВЧ-наводок на проводе 24 В якоря (1 на
| | | якорь)

### 4.6 Результаты экспериментальной проверки приёмного тракта

Испытания проводились в коридоре сечением 2×3 м — акустически наихудший случай: замкнутое пространство с многократными переотражениями, действующее как звуковод.
Максимальная дальность. Уверенный приём сигнала достигнут на расстоянии ≈34 м при амплитуде на выходе усилительного тракта 1–2 В, что обеспечивает надёжное срабатывание компаратора. Результат соответствует теоретической оценке максимальной дальности (раздел 3.1).
Форма огибающей. Время нарастания переднего фронта огибающей составило ≈0,2 мс — достаточно крутой фронт для точного определения ToF. Первое эхо зафиксировано приблизительно через 4 мс после основного сигнала, что соответствует дополнительному пробегу ≈1,4 м (отражатель на расстоянии ≈0,7 м от линии распространения). Система детектирует только первый приход по прямому пути; эхо-сигналы приходят с задержкой и не влияют на измерение ToF.
Полное затухание и частота измерений. Полное затухание сигнала с учётом всех переотражений в коридоре составило 10–15 мс, что ограничивает максимальную частоту зондирования до 60–70 Гц. На открытом пространстве переотражения значительно слабее; ожидаемая частота измерений — свыше 100 Гц.
Таким образом, приёмный тракт обеспечивает работу на требуемых дистанциях даже в акустически неблагоприятных условиях замкнутого пространства.

## Список литературы

[1] ISO 9613-1:1993, Acoustics — Attenuation of sound during propagation outdoors — Part 1: Calculation of the absorption of sound by the atmosphere. International Organization for Standardization, Geneva, Switzerland, 1993.
[2] ISO | 2533:1975, | Standard | Atmosphere. | International | Organization | for
Standardization, Geneva, Switzerland, 1975.
[3] O. Cramer, “The variation of the specific heat ratio and the speed of sound in air with temperature, pressure, humidity, and CO2 concentration,” Journal of the Acoustical Society of America, vol. 93, no. 5, pp. 2510–2516, 1993.
[4] E. D. Kaplan and C. J. Hegarty, Understanding GPS: Principles and Applications, 2nd ed. Norwood, MA, USA: Artech House, 2005.
[5] P. Misra and P. Enge, Global Positioning System: Signals, Measurements, and Performance, 2nd ed. Lincoln, MA, USA: Ganga-Jamuna Press, 2006.
[6] Y. T. Chan and K. C. Ho, “A simple and efficient estimator for hyperbolic location,” IEEE Transactions on Signal Processing, vol. 42, no. 8, pp. 1905–1915, Aug. 1994.
[7] M. H. Hayes, Statistical Digital Signal Processing and Modeling. New York, NY, USA: Wiley, 1996.
[8] S. M. Kay, Fundamentals of Statistical Signal Processing: Estimation Theory. Upper Saddle River, NJ, USA: Prentice Hall, 1993.
[9] J. O. Smith, “Closed-form solution of sound source localization using time delays,” IEEE Transactions on Acoustics, Speech, and Signal Processing, vol. 35, no. 12, pp. 1661–1669, 1987.
