egormeister02/Ultrasonic-LNS/usn_presentation.pdf

Проблема
Методология
Вопросы

## Разработка и исследование систем ультразвуковой навигации привязной беспилотной высотной платформы

## Смирнов Егор Ильич

Студент 4 курса ФРКТ МФТИ
Кафедры ИСС

Техник, лаб. 69


МНШ лаб. 69 «Разработка теоретических основ и методов практической реализации ЛНС привязной высотной беспилотной
платформы» | Руководитель д.т.н., проф. Вишневский В.М. | 1 / 12

Введение
Формализация

## Постановка Задачи


МНШ лаб. 69 «Разработка теоретических основ и методов

Введение
Формализация

## Задачи и цели исследования

Цели исследования:
Определить
возможности системы:
максимальная
дальность, предельная
точность
Определить метод
вычислений координат
Разработать прототип
ЛНС, провести
испытания и собрать
данные

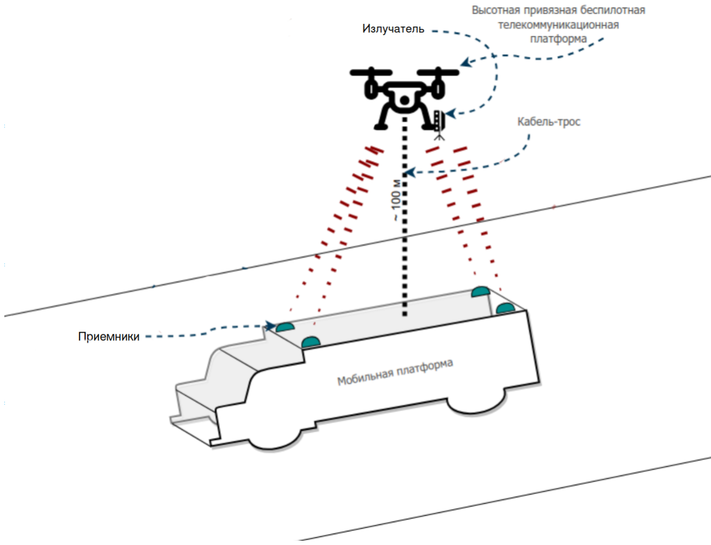
[picture p28: figure]

МНШ лаб. 69 «Разработка теоретических основ и методов

## Максимальная дальность

I) Интенсивность звука в атмосфере затухает экспоненциально
I = I0e

−αr
, где

α = 8.686 f

2

[
1.84 × 10−11
p

√
T
293.15

+

(
T

293.15)−5/2 (
0.01275e−2239.1/T
fr,O + f

2/fr,O

+

0.1068e−3352/T
fr,N + f

2/fr,N

)], где

r - расстояние, м;
f — частота звука, Гц;
T — абсолютная температура, К;
p — атмосферное давление, кПа;
fr,O, fr,N — частоты релаксации кислорода и азота.
МНШ лаб. 69 «Разработка теоретических основ и методов

## Точность измерений

Точность измерений расстояния зависит от разрешения часов приемников и излучателя:
±d =

c
2∆t

(1)

Приведем характерные значения:

∆t | d
1 мкс 10 мкс 100 мкс 1000 мкс | 0.17 мм 1.7 мм 17 мм 17 см

МНШ лаб. 69 «Разработка теоретических основ и методов

## Ошибка координат

В силу относительно
небольшого расстояния
между приемниками на
платформе, ошибка в
плоскости XY будет
значительной.

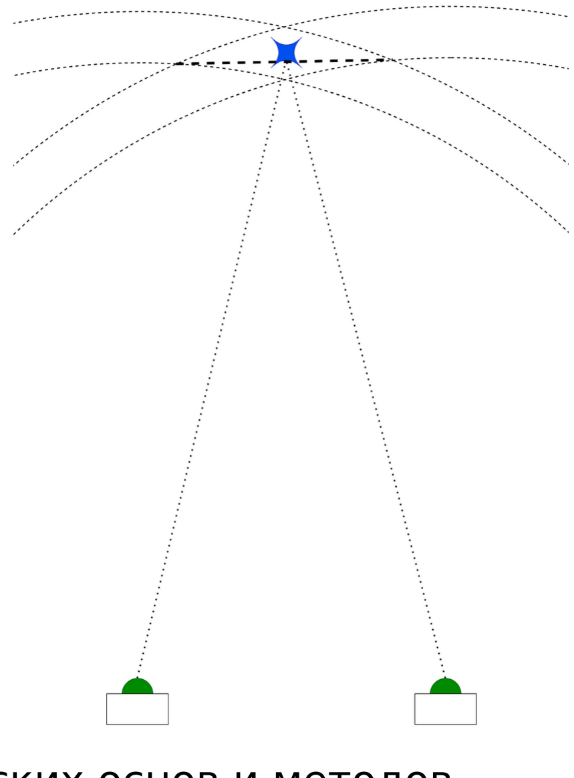
[picture p29: figure]

МНШ лаб. 69 «Разработка теоретических основ и методов

## Вычислительный метод

Метод Гаусса-Ньютона

min
p

J(p), J(p) = ∑ N

i=1

wi

(

# ˆri − ∥p − ai∥

)2

ˆri — измеренное расстояние от якоря i до объекта . ai — вектор координат i-го якоря.
p — вектор неизвестных координат объекта.
wi — вес измерения i (обычно обратный дисперсии). J(p) — целевая функция суммы взвешенных квадратов невязок.

МНШ лаб. 69 «Разработка теоретических основ и методов

## Аналитический метод

Координаты точки P удовлетворяют системе уравнений трёх сфер:

(x − xi)

2 + (y − yi)

2 + z

2 = r

2
i

, i = 1, 2, 3.

2(x2 − x1)x + 2(y2 − y1)y = r

2
1 − r

2
2 + x

2
| 2 − x
| 2 1 + y
| 2 2 − y
2/1,
2(x3 − x1)x + 2(y3 − y1)y = r

2
1 − r

2
3 + x

2
| 3 − x
| 2 1 + y
| 2 3 − y
2/1.

В матричной форме:

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
2 = r

2
1 − (x − x1)

2 − (y − y1)

2
, z = ±

√
r

2
1 − (x − x1)

2 − (y − y1)
2 .
МНШ лаб. 69 «Разработка теоретических основ и методов

## Аналитический метод

МНШ лаб. 69 «Разработка теоретических основ и методов

## Сравнение

4 Sensors

Statistic | analytic err | gn err
count | 2000.0000 | 2000.0000
mean | 0.7494 | 0.7479
std | 0.3575 | 0.3587
min | 0.0346 | 0.0253
25% | 0.4649 | 0.4627
50% | 0.7349 | 0.7333
75% | 1.0091 | 1.0090
max | 1.7822 | 1.7820

5 Sensors

Statistic | analytic err | gn err
count | 2000.0000 | 2000.0000
mean | 0.6755 | 0.7295
std | 0.3292 | 0.3615
min | 0.0399 | 0.0280
25% | 0.4230 | 0.4511
50% | 0.6519 | 0.7124
75% | 0.9082 | 0.9931
max | 1.7357 | 1.8415

МНШ лаб. 69 «Разработка теоретических основ и методов

платформы» | Руководитель д.т.н., проф. Вишневский В.М. | 10 / 12

## Дальнейшая работа

Экспериментально определить предельную точность измерения расстояния. Определить распределение ошибки.
Получить экспериментальные данные о максимальной дальности детектирования УЗ сигнала. Откалибровать формулу. Разработать механизм измерения времени распространения УЗ сигнала и механизм синхронизации приемника с источником. Разработать метод вычислений координат, дающий наименьшую ошибку. При необходимости, разработать механизм учета искажений, вносимых ветром.
Собрать рабочую систему локальной навигации и
МНШ лаб. 69 «Разработка теоретических основ и методов провести испытания. Собрать данные.
платформы» | Руководитель д.т.н., проф. Вишневский В.М. | 11 / 12

Спасибо за внимание!

МНШ лаб. 69 «Разработка теоретических основ и методов

платформы» | Руководитель д.т.н., проф. Вишневский В.М. | 12 / 12
