egormeister02/Ultrasonic-LNS/mipt_presentation.pdf

Проблема
Методология
Реализация
Вопросы

### Разработка и исследование систем ультразвуковой навигации привязной беспилотной высотной платформы

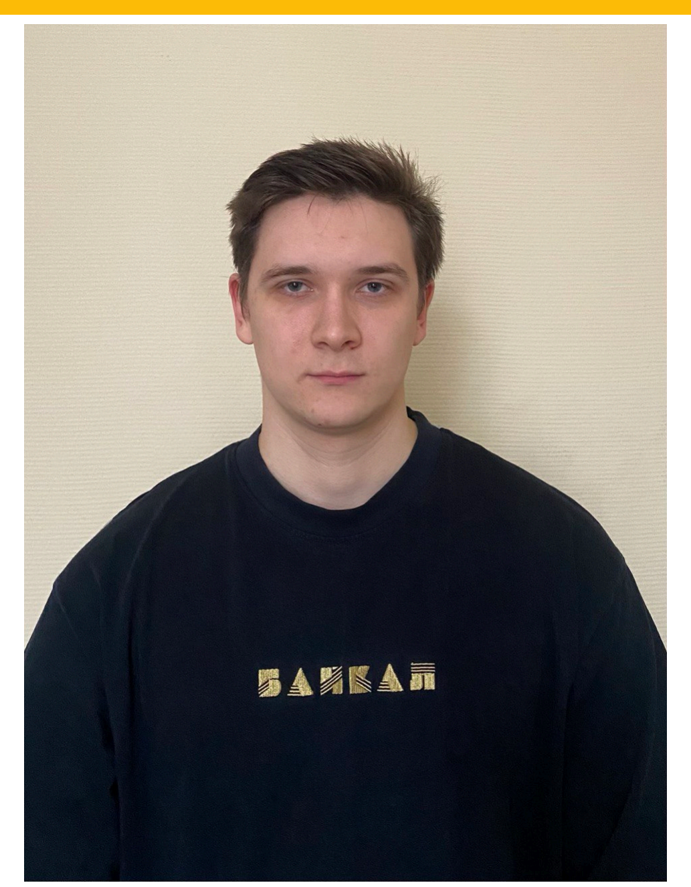
[picture p30: figure]

Смирнов Егор Ильич

Студент 4 курса ФРКТ МФТИ
Кафедры ИСС

Институт проблем управления им. В.А.Трапезникова РАН
Техник, лаб. 69

Вопросы

Введение
Формализация

### Постановка Задачи


Вопросы

Введение
Формализация

### Задачи и цели исследования


Цели исследования:
Определить возможности
системы:
максимальная дальность,
предельная точность
Определить оптимальный
метод вычислений
координат

Вопросы

### Максимальная дальность

I) Интенсивность звука в атмосфере затухает экспоненциально

I = I0e

−αr
, где

α = 8.686 f

2

[
1.84 × 10−11
p

√
T

293.15

+

(
T

293.15 )−5/2 (
0.01275e

−2239.1/T
fr,O + f

2/fr,O

+

0.1068e

−3352/T
fr,N + f

2/fr,N

)], где

r - расстояние, м;
f — частота звука, Гц;
T — абсолютная температура, К;
p — атмосферное давление, кПа;
fr,O, fr,N — частоты релаксации кислорода и азота.

Вопросы

### Разделение ошибки

Разделим ошибку на состовляющие: Систематическую и случайную.

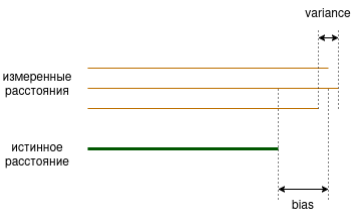
[picture p31: figure]

Вопросы

### Точность измерений

Точность измерений расстояния зависит от разрешения часов приемников и излучателя:
±d =

c
2∆t

(1)

Приведем характерные значения:

∆t | d
1 мкс 10 мкс 100 мкс 1000 мкс | 0.17 мм 1.7 мм 17 мм 17 см

Вопросы

### Скорость звука

Скорость звука в воздухе рассчитывается по формуле:

c =

√
γ Rmix T,

где:

c — скорость звука, м/с
γ = cp,mix/cv,mix — показатель адиабаты
Rmix = R/Mmix — удельная газовая постоянная смеси T — абсолютная температура, К
Mmix = (1 − xv)Md + xvMv — молярная масса смеси
xv = pv/p — мольная доля водяного пара
pv = h psat(T) — парциальное давление водяного пара

Вопросы

### Погрешность скорости звука

Полная погрешность:

∆c =

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
+ ∆²
мод

При типичных датчиках:

∆T = ±0.5

◦C → ∆cT ≈ 0.30 м/с

∆p = ±120 Па → ∆cp ≈ 0.06 м/с ∆h = ±3% → ∆ch ≈ 0.002 м/с ∆мод ≈ 0.31 м/с

Результат: ∆c ≈ 0.43 м/с (±0.13%)

Вопросы

### Ошибка координат

GDOP (Geometric Dilution of Precision) — коэффициент геометрического ослабления точности.

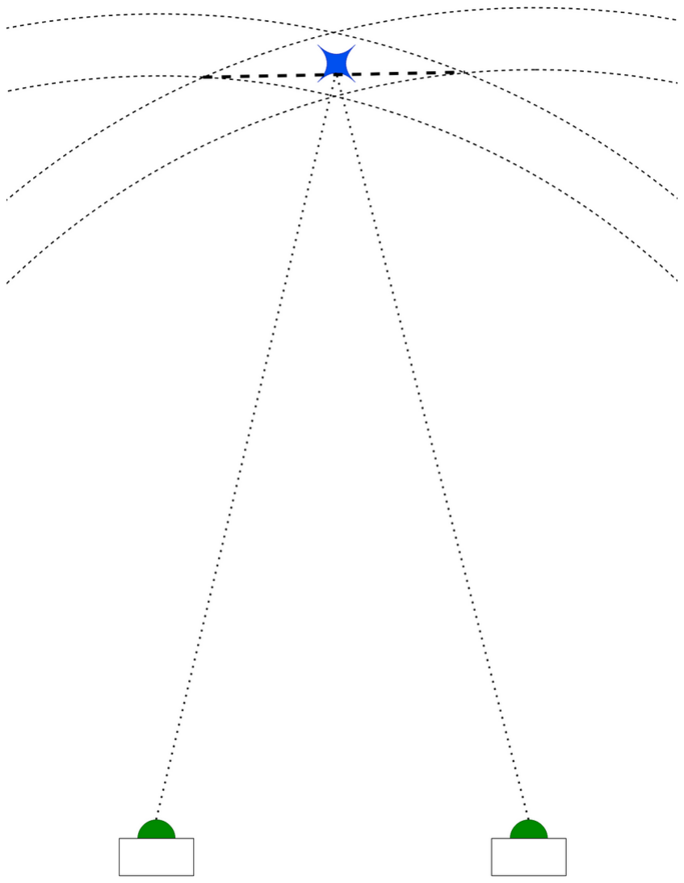
[picture p32: figure]

В силу относительно
небольшого расстояния между приемниками на платформе,
ошибка в плоскости XY будет значительной.

Вопросы

### GDOP — формула

Модель: 4 якоря в вершинах квадрата со стороной a, объект на высоте H.

D =

√
a²
2

+ H² — расстояние до якоря

σxyz = σd · D ·

√
2
a² +

1
4H²

где:
σxyz — СКО положения в 3D
σd — ошибка измерения расстояния a — сторона квадрата якорей
H — высота объекта

Вопросы

### GDOP — зависимость от геометрии якорей


Вопросы

### Вычислительный метод

Метод Гаусса-Ньютона

min
p

J(p), J(p) = ∑N

i=1

wi

(

# ˆri − ∥p − ai∥

)2

ˆri — измеренное расстояние от якоря i до объекта . ai — вектор координат i-го якоря.
p — вектор неизвестных координат объекта.
wi — вес измерения i (обычно обратный дисперсии). J(p) — целевая функция суммы взвешенных квадратов невязок.

Вопросы

### Аналитический метод

Координаты точки P удовлетворяют системе уравнений трёх сфер:
(x − xi)

2 + (y − yi)

2 + z

2 = r

2
i

, i = 1, 2, 3.

2(x2 − x1)x + 2(y2 − y1)y = r

2
1 − r

2
2 + x

2
| 2 − x
| 2 1 + y
| 2 2 − y

2
1,
2(x3 − x1)x + 2(y3 − y1)y = r

2
1 − r

2
3 + x

2
| 3 − x
| 2 1 + y
| 2 3 − y

2
1.

В матричной форме:

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
2 = r

2
1 − (x − x1)

2 − (y − y1)

2
, z = ±

√
r

2
1 − (x − x1)

2 − (y − y1)
2 .

Вопросы

### Аналитический метод

Вопросы

### Сравнение

Зависимость ошибки локализации от дисперсии шума измерений.

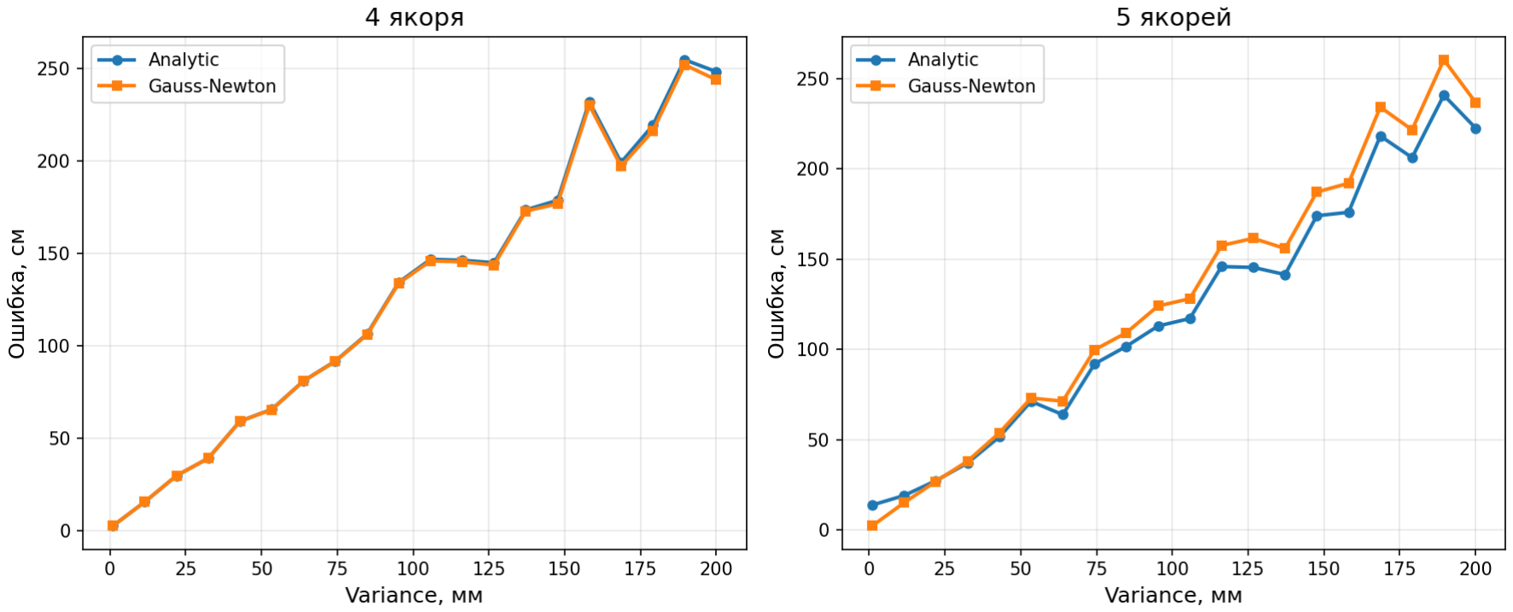
[picture p33: figure]

Вопросы

### Таблица погрешности

Таблица 1: Аналитический метод, H = 25м, n = 1000

σ, м | 4 якоря, см | 5 якорей, см
0.002 | 3.44 | 15.51
0.005 | 6.98 | 16.56
0.01 | 12.78 | 18.87
0.05 | 62.52 | 57.98
0.1 | 128.21 | 116.31

Таблица 2: Метод Гаусса-Ньютона, H = 25м, n = 1000

σ, м | 4 якоря, см | 5 якорей, см
0.002 | 3.44 | 3.43
0.005 | 6.83 | 6.69
0.01 | 12.96 | 12.59
0.05 | 62.68 | 62.58
0.1 | 128.78 | 125.42

Вопросы

### Узел БПЛА — передающая часть

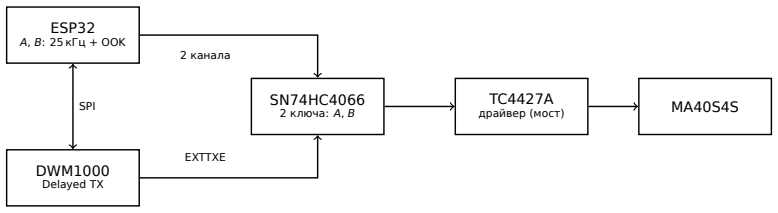
[picture p34: figure]
ESP32 A, B: 25 кГц + OOK; DWM1000 Delayed TX; SN74HC4066 2 ключа: A, B; TC4427A SPI; драйвер (мост); 2 канала; EXTTXE

Аппаратная синхронизация УЗ-пачки и UWB-пакета сигналом EXTTXE (∆t ≲ 10 нс)

Вопросы

### Узел якоря — приёмный тракт

Предусилитель
INA128P, G≈30–150

Полосовой усилитель
TL072CN, 25 кГц

Демодулятор
Д9Б + LM311P

УЗ
приёмник | МК

Полное усиление ∼60дБ; быстрый компаратор LM311P (задержка ∼200 нс)

Вопросы

### Питание узла якоря

Изоляция 1500 В + двухступенчатая LC-фильтрация против наводок 400 В генератора

Вопросы

Спасибо за внимание!
