egormeister02/Ultrasonic-LNS/images/tethered-uav-overview.png

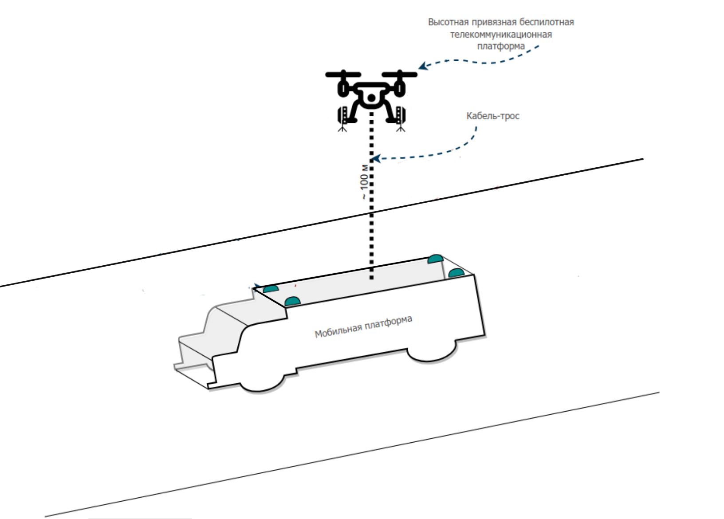
images/tethered-uav-overview.png
