egormeister02/Ultrasonic-LNS/parts/Chapter3.tex

\section{Исследование и построение решения задачи}
\label{sec:Chapter3}

\subsection{Архитектура предлагаемого решения}
\label{sec:architecture}

Рассматриваемая система состоит из привязного БПЛА и наземной платформы, на
которой размещается ультразвуковая опорная подсистема. Платформа может быть
стационарной или мобильной, поэтому все измерения и вычисления выполняются в
системе координат, связанной с платформой, а при необходимости учитываются её
наклоны.

В базовой конфигурации на платформе устанавливаются несколько ультразвуковых
опорных узлов (далее~--- якоря), разнесённых на максимально возможное расстояние
друг от друга. Геометрия якорей считается известной: координаты каждого якоря
заранее задаются в системе координат платформы. В принятой конфигурации ультразвуковой
\emph{излучатель} размещается на БПЛА, а якоря служат \emph{приёмниками}; излучатель
ориентирован в сторону платформы и работает в зоне прямой видимости опорных узлов.

\begin{figure}[h!]
    \centering
    
    \caption{Общая схема системы локальной навигации привязного БПЛА относительно платформы}
    \label{fig:system-overview}
\end{figure}

Принцип работы системы следующий. Опорные узлы на платформе и бортовой узел на
БПЛА формируют набор измерений времени распространения акустических импульсов. По
измеренным временам вычисляются расстояния до якорей, после чего координаты БПЛА
определяются методом трилатерации в системе координат платформы.

Для получения корректных расстояний требуется синхронизация времени между
передающей и принимающей сторонами. В привязном варианте синхронизирующий сигнал
может быть передан по кабелю-тросу; в настоящей работе применяется
радиосинхронизация по UWB-каналу (раздел~\ref{sec:Chapter4}).

Если платформа подвержена наклонам, на ней размещается инерциальный датчик
(например, акселерометр/IMU), позволяющий оценивать ориентацию платформы
относительно горизонта и при необходимости пересчитывать координаты из
платформенной системы координат в требуемую внешнюю систему отсчёта.

Дальнейшие подразделы строят математическую модель системы: оценивают предельную
дальность, погрешность измерения расстояния и координат, а также сравнивают методы
решения задачи трилатерации.

\subsection{Максимальная дальность работы}
\label{sec:max-range}
Под дальностью работы нужно понимать максимальное расстояние между излучателем и
приёмником, при котором приёмник может стабильно детектировать сигнал.
Это расстояние зависит от нескольких факторов:

\begin{itemize}
  \item мощность излучателя;
  \item чувствительность приёмника;
  \item уровень шума в среде;
  \item затухание звукового сигнала в среде.
\end{itemize}
Остановимся подробнее на затухании звука.

Интенсивность звука убывает с расстоянием как
\begin{equation}
 I(x) = I_0 \cdot 10^{-\alpha x / 10},
\end{equation}
где $\alpha$~--- коэффициент затухания, дБ/м.

Согласно стандарту ISO 9613-1:1993~\cite{iso9613}, коэффициент затухания
рассчитывается по формуле
\begin{equation}\label{iso}
\begin{aligned}
\alpha = 8.686 \cdot f^{2} \cdot \Bigg[\, & 1.84 \cdot 10^{-11} \cdot \frac{p_r}{p_a} \cdot \left(\frac{T}{T_r}\right)^{0.5} \\
& + \left(\frac{T}{T_r}\right)^{-2.5} \cdot \left( \frac{0.01275 \cdot e^{-2239.1/T}}{f_{r,O} + \frac{f^{2}}{f_{r,O}}} + \frac{0.1068 \cdot e^{-3352.0/T}}{f_{r,N} + \frac{f^{2}}{f_{r,N}}} \right) \Bigg]
\end{aligned}
\end{equation}
где:
\begin{itemize}
\item $\alpha$ — коэффициент затухания, дБ/м;
\item $f$ — частота звука, Гц;
\item $p_a$ — атмосферное давление, кПа;
\item $p_r = 101.325$ кПа — опорное давление;
\item $T$ — температура воздуха, К;
\item $T_r = 293.15$ К — опорная температура;
\item $f_{r,O}$ — частота релаксации кислорода, Гц;
\item $f_{r,N}$ — частота релаксации азота, Гц.
\end{itemize}

Частоты релаксации рассчитываются по формулам
\begin{equation}
f_{r,O} = \frac{p_a}{p_r} \left( 24 + 4.04 \cdot 10^{4} h \frac{0.02 + h}{0.391 + h} \right),
\end{equation}
\begin{equation}
f_{r,N} = \frac{p_a}{p_r} \left( \frac{T}{T_r} \right)^{-1/2} \left( 9 + 280 \cdot h \cdot \exp \left( -4.170 \left[ \left(\frac{T}{T_r}\right)^{-1/3} - 1 \right] \right) \right),
\end{equation}
где $h$ — молярная концентрация водяного пара:
\begin{equation}
h = h_r \cdot \frac{p_{sat}}{p_a}.
\end{equation}
Здесь $h_r$ — относительная влажность, $p_{sat}$ — давление насыщенного пара, которое рассчитывается по формуле
\begin{equation}
p_{sat} = p_r \cdot 10^{-6.8346 \cdot \left( \frac{T_{01}}{T} \right)^{1.261} + 4.6151},
\end{equation}
где $T_{01} = 273.16$ К — температура тройной точки воды.

По формуле~\eqref{iso} видно, что коэффициент затухания прямо пропорционален
квадрату частоты $f$. Поэтому для обеспечения максимальной дальности частоту
необходимо выбирать как можно ниже.

Для текущей системы была выбрана частота 25~кГц: она достаточно низкая для
обеспечения дальности и при этом находится вне слышимого диапазона.

Расчёт для этой частоты даёт максимальную дальность порядка $35$~м (оценка по порядку величины).
Вычисления производились при следующих параметрах:
\begin{itemize}
\item относительная влажность --- $50\%$;
\item температура воздуха --- $20\,^\circ\mathrm{C}$;
\item уровень звукового давления излучателя --- $105$~дБ (SPL --- Sound Pressure Level, на расстоянии 1~м от источника);
\item чувствительность УЗ-приёмника --- $-95$~дБ.
\end{itemize}

Следует подчеркнуть, что это оценка по порядку величины: реальная дальность
существенно зависит от конкретной реализации системы и внешних условий, а входные
параметры (SPL, чувствительность) известны лишь приближённо.
Протокол синхронизации (раздел~\ref{sec:protocol}) рассчитан с дополнительным
запасом~--- на дистанции до $100$~м.

\subsection{Точность измерения расстояния}
\label{sec:distance-accuracy}
Расстояние от БПЛА до якоря измеряется следующим образом: в известный момент
времени излучатель на БПЛА испускает сигнал. Спустя некоторое время приёмник на
якоре его детектирует. Так как микроконтроллеры на излучателе и приёмнике
синхронизированы, время, которое потребовалось для передачи сигнала, известно.
Умножив его на скорость звука, получим искомое расстояние.

Значение мы получаем с определённой погрешностью; разобьём её на части
(рис.~\ref{fig:bias-variance}).

\begin{figure}[h!]
  \centering
  
  \caption{Ошибка при определении расстояния}
  \label{fig:bias-variance}
\end{figure}

\subsubsection{Скорость звука}

Для определения расстояния нам необходимо знать скорость звука. Именно ошибка при
вычислении скорости вызывает систематическую ошибку в определении расстояний.

Скорость звука $c$ в газе является термодинамической величиной. Для влажного
воздуха в приближении идеальной газовой смеси её можно оценить по выражению
\begin{subequations}\label{eq:speed-of-sound-humid-air}
\begin{align}
  c &= \sqrt{\gamma\,R_{\mathrm{mix}}\,T}, \\
  R_{\mathrm{mix}} &= \frac{R}{M_{\mathrm{mix}}}, \\
  M_{\mathrm{mix}} &= (1-x_v)\,M_d + x_v\,M_v, \\
  x_v &= \frac{p_v}{p}, \\
  p_v &= h\,p_{\mathrm{sat}}(T), \\
  p_{\mathrm{sat}}(T) &= 611.21\,\exp\!\left(\frac{17.502\,(T-273.15)}{T-32.19}\right), \\
  \gamma &= \frac{c_{p,\mathrm{mix}}}{c_{v,\mathrm{mix}}}
  = \frac{c_{p,\mathrm{mix}}}{c_{p,\mathrm{mix}} - R_{\mathrm{mix}}}, \\
  c_{p,\mathrm{mix}} &= (1-x_v)\,c_{p,d}(T) + x_v\,c_{p,v}(T).
\end{align}
\end{subequations}
Выражения~\eqref{eq:speed-of-sound-humid-air} основаны на работе~\cite{cramer1993}.
Здесь $p_{\mathrm{sat}}(T)$ вычисляется по формуле Тетенса в параметризации Бака~\cite{buck1981}, применимой в диапазоне $-20\ldots 50~^\circ\mathrm{C}$.

После подстановки всех промежуточных величин в~\eqref{eq:speed-of-sound-humid-air} получается явное
выражение $c$ как функции трёх измеряемых параметров $(T, p, h)$:
\begin{equation}\label{eq:speed-of-sound-explicit}
  c(T,p,h) = \sqrt{\frac{c_{p,\mathrm{mix}}(T,p,h)\,R\,T}
                        {M_{\mathrm{mix}}(T,p,h)\bigl[c_{p,\mathrm{mix}}(T,p,h) - R/M_{\mathrm{mix}}(T,p,h)\bigr]}},
\end{equation}
где мольная доля пара и производные от неё величины имеют вид
\begin{align*}
  x_v(T,p,h)            &= \frac{h\,p_{\mathrm{sat}}(T)}{p}, \\
  M_{\mathrm{mix}}(T,p,h) &= M_d + x_v(T,p,h)\,(M_v - M_d), \\
  c_{p,\mathrm{mix}}(T,p,h) &= c_{p,d} + x_v(T,p,h)\,(c_{p,v} - c_{p,d}), \\
  c_{p,d} &\approx 1005~\mathrm{J/(kg\cdot K)},\qquad
  c_{p,v} \approx 1850~\mathrm{J/(kg\cdot K)}.
\end{align*}

Обозначения, используемые в~\eqref{eq:speed-of-sound-humid-air}, приведены в табл.~\ref{tab:speed-of-sound-notation}.

\begin{table}[!htbp]
  \centering
  \caption{Обозначения в модели скорости звука во влажном воздухе}
  \label{tab:speed-of-sound-notation}
  \small
  \begin{tabular}{lll}
    \toprule
    Обозначение & Значение & Единицы \\
    \midrule
    $c$ & скорость звука & м/с \\
    $T$ & абсолютная температура & $\mathrm{K}$ \\
    $p$ & общее давление & $\mathrm{Pa}$ \\
    $h$ & относительная влажность ($0\ldots 1$) & -- \\
    $x_v$ & мольная доля водяного пара & -- \\
    $p_v$ & парциальное давление пара & $\mathrm{Pa}$ \\
    $p_{\mathrm{sat}}(T)$ & давление насыщенного пара & $\mathrm{Pa}$ \\
    $R$ & универсальная газовая постоянная ($8.314462618$) & $\mathrm{J/(mol\cdot K)}$ \\
    $M_d$ & молярная масса сухого воздуха ($0.0289652$) & $\mathrm{kg/mol}$ \\
    $M_v$ & молярная масса воды ($0.01801528$) & $\mathrm{kg/mol}$ \\
    $M_{\mathrm{mix}}$ & молярная масса смеси & $\mathrm{kg/mol}$ \\
    $R_{\mathrm{mix}}$ & удельная газовая постоянная смеси & $\mathrm{J/(kg\cdot K)}$ \\
    $c_{p,d}(T)$ & теплоёмкость сухого воздуха при $p=\mathrm{const}$ & $\mathrm{J/(kg\cdot K)}$ \\
    $c_{p,v}(T)$ & теплоёмкость водяного пара при $p=\mathrm{const}$ & $\mathrm{J/(kg\cdot K)}$ \\
    $c_{p,\mathrm{mix}}$ & теплоёмкость смеси при $p=\mathrm{const}$ & $\mathrm{J/(kg\cdot K)}$ \\
    $c_{v,\mathrm{mix}}$ & теплоёмкость смеси при $V=\mathrm{const}$ & $\mathrm{J/(kg\cdot K)}$ \\
    $\gamma$ & показатель адиабаты смеси & -- \\
    \bottomrule
  \end{tabular}
\end{table}
\FloatBarrier

\textbf{Погрешность измерения параметров среды.}
Для расчёта скорости звука по формулам~\eqref{eq:speed-of-sound-humid-air} требуются значения температуры $T$, давления $p$ и относительной влажности $h$. В реальной системе эти параметры измеряются датчиками, что вносит дополнительную погрешность в определение скорости звука.

В качестве датчика рассмотрим:
\begin{itemize}
    \item \textbf{BME280}~\cite{bme280} (температура, давление, влажность): погрешность температуры $\pm 0.5\ ^\circ\mathrm{C}$, погрешность давления $\pm 1.2\ \mathrm{hPa}$ ($\pm 120\ \mathrm{Pa}$), погрешность влажности $\pm 3\%$.
\end{itemize}

\textbf{Погрешность модели.}
Погрешность модели $\Delta_{\text{мод}}$ определяется совокупностью приближений, использованных при выводе формул~\eqref{eq:speed-of-sound-humid-air}. Рассмотрим составляющие:

\begin{enumerate}
    \item \textbf{Приближение идеального газа.} Уравнения~\eqref{eq:speed-of-sound-humid-air} основаны на модели идеального газа.
    Реальные свойства воздуха описываются вторыми вириальными коэффициентами. Согласно анализу Cramer~\cite{cramer1993},
    учёт нелинейности уравнения состояния вносит поправку порядка $10^{-4}$ ($\sim 0.03$~м/с). Принимаем $\Delta_{\text{ид}} \approx 0.05$~м/с с запасом.

    \item \textbf{Упрощение теплоёмкостей.} В формулах~\eqref{eq:speed-of-sound-humid-air} теплоёмкости $c_{p,d}$ и $c_{p,v}$
    принимаются постоянными. На самом деле они зависят от температуры. При изменении температуры от 0 до $40\ ^\circ\mathrm{C}$
    относительное изменение $c_{p,d}$ составляет около $0.1\%$, что даёт погрешность скорости звука $\Delta_{\text{cp}} \approx 0.3$~м/с.

    \item \textbf{Формула Тетенса.} Для расчёта давления насыщенного пара $p_{\mathrm{sat}}(T)$ используется формула Тетенса~\cite{buck1981},
    применимая в диапазоне $-20\ldots 50\ ^\circ\mathrm{C}$ с относительной погрешностью менее $0.5\%$.
    Влияние на скорость звука незначительно: $\Delta_{\text{Тетенс}} \approx 0.01$~м/с.

    \item \textbf{Физические константы.} Универсальная газовая постоянная $R$ и молярные массы $M_d$, $M_v$ известны
    с точностью лучше $10^{-5}$ (CODATA), их вклад пренебрежимо мал.
\end{enumerate}

Полная погрешность модели по закону накопления погрешностей:
\begin{equation}\label{eq:model-error}
    \Delta_{\text{мод}} = \sqrt{\Delta_{\text{ид}}^2 + \Delta_{\text{cp}}^2 + \Delta_{\text{Тетенс}}^2} = \sqrt{0.05^2 + 0.30^2 + 0.01^2} \approx 0.31\ \mathrm{m/s}.
\end{equation}

\textbf{Полная погрешность скорости звука.}
Погрешность определения $c$ складывается из погрешностей измерения параметров и погрешности модели:
\begin{equation}\label{eq:error-propagation}
    \Delta c = \sqrt{\left(\frac{\partial c}{\partial T}\Delta T\right)^2 + \left(\frac{\partial c}{\partial p}\Delta p\right)^2 + \left(\frac{\partial c}{\partial h}\Delta h\right)^2 + \Delta_{\text{мод}}^2}.
\end{equation}

Для оценки частных производных при околонормальных условиях ($T \approx 293\ \mathrm{K}$, $p \approx 101325\ \mathrm{Pa}$, $h \approx 0.5$) получаем:
\begin{align}
    \frac{\partial c}{\partial T} &\approx 0.60\ \mathrm{m/(s\cdot K)}, \\
    \frac{\partial c}{\partial p} &\approx -4.7 \cdot 10^{-4}\ \mathrm{m/(s\cdot Pa)}, \\
    \frac{\partial c}{\partial h} &\approx 0.08\ \mathrm{m/s}.
\end{align}

Подставляя погрешности датчиков BME280 ($\Delta T = 0.5\ \mathrm{K}$, $\Delta p = 120\ \mathrm{Pa}$, $\Delta h = 0.03$) и $\Delta_{\text{мод}} = 0.31$~м/с:
\begin{align}
    \Delta c_T &= 0.60 \cdot 0.5 = 0.30\ \mathrm{m/s}, \\
    \Delta c_p &= 4.7 \cdot 10^{-4} \cdot 120 \approx 0.06\ \mathrm{m/s}, \\
    \Delta c_h &= 0.08 \cdot 0.03 \approx 0.002\ \mathrm{m/s}.
\end{align}

Полная погрешность:
\begin{equation}
    \Delta c = \sqrt{0.30^2 + 0.06^2 + 0.002^2 + 0.31^2} \approx \sqrt{0.186} \approx 0.43\ \mathrm{m/s}.
\end{equation}

Таким образом, при использовании датчиков среднего класса точности полная погрешность определения скорости звука составляет около $\pm 0.43\ \mathrm{m/s}$ ($\sim \pm 0.13\%$). Основной вклад вносят погрешность измерения температуры ($\sim 70\%$) и погрешность модели ($\sim 52\%$); влияние давления и влажности значительно меньше.

\textbf{Проверка по табличным данным.}
Для верификации оценки погрешности модели выполним сравнение расчётного значения скорости звука с табличными данными при стандартных условиях (сухой воздух, $T = 273.15$~K, $p = 101325$~Па, $h = 0$).

По формулам~\eqref{eq:speed-of-sound-humid-air} при $h = 0$ получаем $x_v = 0$, $M_{\text{mix}} = M_d$, $R_{\text{mix}} = R/M_d$, $\gamma = c_{p,d}/(c_{p,d} - R_{\text{mix}})$, откуда
\begin{equation}
    c_{\text{расч}} = \sqrt{\gamma \frac{R}{M_d} T} = \sqrt{1.402 \cdot \frac{8.314}{0.028965} \cdot 273.15} \approx 331.3\ \mathrm{m/s}.
\end{equation}

Табличное значение скорости звука в сухом воздухе при $0\ ^\circ\mathrm{C}$ и нормальном атмосферном давлении согласно~\cite{iso2533} составляет $c_{\text{табл}} = 331.29$~м/с. Разница между расчётным и табличным значениями:
\begin{equation}
    \Delta c_{\text{проверка}} = |c_{\text{расч}} - c_{\text{табл}}| \approx |331.3 - 331.29| = 0.01\ \mathrm{m/s}.
\end{equation}

Полученное расхождение ($\sim 0.003\%$) значительно меньше оценённой погрешности модели $\Delta_{\text{мод}} \approx 0.31$~м/с, что подтверждает корректность оценки с запасом. Разница объясняется округлениями констант в расчёте и не учтённым влиянием реальных свойств газа (вторые вириальные коэффициенты), которое как раз и даёт основной вклад в $\Delta_{\text{мод}}$.

\textbf{Выводы.}
Проведённый анализ показал, что при использовании недорогих датчиков типа BME280 основная погрешность определения скорости звука ($\sim 0.43$~м/с) определяется погрешностью измерения температуры ($0.30$~м/с) и погрешностью модели ($0.31$~м/с). Проверка по табличным данным подтвердила, что оценка погрешности модели является консервативной (завышенной), что приемлемо для инженерных расчётов.

\subsubsection{Точность измерения времени}
Расстояние определяется по интервалу времени между общей меткой (приём UWB-кадра) и
детектированием ультразвукового импульса. Поскольку часы передающей и приёмной сторон
синхронизированы, это время одностороннего распространения, и ошибка дальности связана с
ошибкой времени соотношением
\begin{equation}
  \Delta d = c\,\Delta t.
\end{equation}
Коэффициент $c \approx 343$~м/с задаёт масштаб перевода (табл.~\ref{tab:time-scale}).
\begin{table}[h!]
    \centering
    \caption{Перевод ошибки времени в ошибку дальности ($\Delta d = c\,\Delta t$)}
    \label{tab:time-scale}
    \begin{tabular}{|c|c|}
        \hline
        $\Delta t$ & $\Delta d$ \\
        \hline
        1 мкс & 0.34 мм  \\
        10 мкс & 3.4 мм \\
        100 мкс & 34 мм \\
        1000 мкс & 34 см \\
        \hline
    \end{tabular}
\end{table}

\textbf{Квантование таймера пренебрежимо.}
Само измерение времени выполняется аппаратно: момент приёма UWB-кадра фиксируется таймером
DWM1000 с разрешением $15$~пс, а фронт компаратора якоря защёлкивается аппаратным модулем
захвата (MCPWM CAP) с разрешением $12{,}5$~нс ($c\,\Delta t \approx 4$~мкм). Квантование
таймера, таким образом, в бюджет ошибки практически не входит.

\textbf{Источник случайной ошибки.}
Доминирующий вклад в случайную ошибку даёт джиттер определения самого момента прихода.
Характерной точкой прихода служит начало роста огибающей; огибающая нарастает за конечное
время фронта $\tau_{\text{фр}} \approx 0{,}2$~мс (измерено, см.\ раздел~\ref{sec:exp}), а её
положение восстанавливается по зашумлённым отсчётам нарастающего участка (двухимпульсный
метод, раздел~\ref{sec:two-pulse}). Для определения времени по фронту джиттер оценивается
отношением шума к крутизне фронта:
\begin{equation}
  \sigma_t \approx \frac{\sigma_V}{|dV/dt|} \approx \frac{\tau_{\text{фр}}}{\mathrm{SNR}},
  \qquad
  \sigma_d = c\,\sigma_t \approx \frac{c\,\tau_{\text{фр}}}{\mathrm{SNR}},
\end{equation}
где $\mathrm{SNR} = V_{\max}/\sigma_V$~--- отношение амплитуды огибающей к СКО шума,
а $c\,\tau_{\text{фр}} \approx 69$~мм. При наблюдаемом отношении сигнал/шум подробный
бюджет случайной ошибки (раздел~\ref{sec:error-budget}) даёт $\sigma_d \approx 3$~мм
(значение принято с запасом; на пределе дальности, где SNR падает, оценка близка
к $4$~мм). Зависящая от амплитуды (а значит, от дальности) \emph{систематическая}
часть этой задержки устраняется двухимпульсной самокалибровкой
(раздел~\ref{sec:two-pulse}); остаётся именно случайный джиттер.

\paragraph{Итоги.}
\begin{itemize}
  \item систематическая ошибка --- ${\sim}0{,}13\%$ (погрешность скорости звука);
  \item случайная ошибка --- $\sigma_d \approx 3$~мм (подробный бюджет~--- раздел~\ref{sec:error-budget}).
\end{itemize}

\subsubsection{Точность определения координат}

При трилатерации в трёхмерном пространстве точность определения координат зависит не только от точности измерения расстояний до якорей, но и от их геометрического расположения. Данный эффект описывается коэффициентом геометрического ослабления точности (GDOP — Geometric Dilution of Precision)~\cite{kaplan2005,misra2006}.

Коэффициент GDOP характеризует влияние геометрии расположения якорей на распространение \textbf{случайных} ошибок измерения расстояний в ошибку оценки координат. В рамках линейной модели оценивания с нулевым средним ошибок измерений GDOP определяет ковариацию оценки координат. Систематические ошибки приводят к смещению оценки и не описываются коэффициентом GDOP~\cite{kay1993,hayes1996}.

\textbf{Постановка.} Рассмотрим четыре якоря, расположенные в вершинах квадрата в плоскости $z=0$:
$$
\begin{aligned}
&A_1(+a/2,\, +a/2,\, 0), \quad A_2(-a/2,\, +a/2,\, 0),\\
&A_3(-a/2,\, -a/2,\, 0), \quad A_4(+a/2,\, -a/2,\, 0).
\end{aligned}
$$

Объект находится в точке $P(0, 0, H)$ на высоте $H$ над центром квадрата. Измеренные расстояния до якорей:
$$
d_i = \sqrt{(x-x_i)^2 + (y-y_i)^2 + (z-z_i)^2} + \varepsilon_i,
$$
где $\varepsilon_i$ — случайная ошибка измерения с дисперсией $\sigma_d^2$.

\textbf{Матрица Якоби.} Линеаризуем уравнения в окрестности истинной позиции. Пусть $D = \sqrt{a^2/2 + H^2}$ — расстояние от объекта до каждого якоря. Матрица Якоби имеет вид:
$$
J =
\begin{pmatrix}
+\frac{a}{2D} & +\frac{a}{2D} & -\frac{H}{D} \\
-\frac{a}{2D} & +\frac{a}{2D} & -\frac{H}{D} \\
-\frac{a}{2D} & -\frac{a}{2D} & -\frac{H}{D} \\
+\frac{a}{2D} & -\frac{a}{2D} & -\frac{H}{D}
\end{pmatrix}.
$$

\textbf{Вычисление $J^T J$.} Благодаря симметрии расположения якорей матрица $J^T J$ является диагональной:
$$
J^T J =
\begin{pmatrix}
\frac{a^2}{D^2} & 0 & 0 \\
0 & \frac{a^2}{D^2} & 0 \\
0 & 0 & \frac{4H^2}{D^2}
\end{pmatrix}.
$$

\textbf{Ковариационная матрица и GDOP.} В рамках метода наименьших квадратов ковариационная матрица оценки координат определяется выражением~\cite{hayes1996,kay1993}:
$$
\Sigma = \sigma_d^2 (J^T J)^{-1}.
$$

Отсюда:
$$
\Sigma = \sigma_d^2
\begin{pmatrix}
\frac{D^2}{a^2} & 0 & 0 \\
0 & \frac{D^2}{a^2} & 0 \\
0 & 0 & \frac{D^2}{4H^2}
\end{pmatrix}.
$$

Среднеквадратичная ошибка положения (PDOP — Position Dilution of Precision) определяется как
$$
\sigma_{xyz} = \sqrt{\mathrm{tr}(\Sigma)} = \sigma_d \sqrt{\frac{2D^2}{a^2} + \frac{D^2}{4H^2}}.
$$

Подставляя $D^2 = \frac{a^2}{2} + H^2$, получаем:
$$
\boxed{
\sigma_{xyz} = \sigma_d \cdot D \cdot \sqrt{\frac{2}{a^2} + \frac{1}{4H^2}}
}
$$
где:
\begin{itemize}
    \item $\sigma_{xyz}$ — среднеквадратичная ошибка положения, м;
    \item $\sigma_d$ — СКО измерения расстояния до якоря, м;
    \item $D = \sqrt{a^2/2 + H^2}$ — расстояние до якоря, м;
    \item $a$ — расстояние между якорями, м;
    \item $H$ — высота объекта, м.
\end{itemize}

\textbf{Геометрический фактор.} При $H \gg a$ вертикальное слагаемое под корнем
пренебрежимо мало по сравнению с горизонтальным, и выражение сводится к
$$
\sigma_{xyz} \approx \sqrt{2}\,\frac{D}{a}\,\sigma_d = G\,\sigma_d,
\qquad G = \sqrt{2}\,\frac{D}{a},
$$
где $G$~--- коэффициент геометрического ослабления точности. Для рабочей конфигурации
($a = 2$~м, $H = 25$~м) $G \approx 18$: ошибка положения в~$G$ раз превышает ошибку
измерения дальности. Раздельно по осям горизонтальная составляющая доминирует
($\sigma_x = \sigma_y = \tfrac{D}{a}\sigma_d \approx 12{,}5\,\sigma_d$), а вертикальная
мала ($\sigma_z = \tfrac{D}{2H}\sigma_d \approx 0{,}5\,\sigma_d$): объект находится почти
над центром базы, поэтому измеренные дальности хорошо определяют высоту и слабо~---
горизонтальное смещение. Компактная база (малое $a$) увеличивает $G$, поэтому
сантиметровая точность положения требует \emph{миллиметровой} точности измерения
дальности.

\textbf{Случайная ошибка измерения дальности.} СКО измерения дальности $\sigma_d$
определяется бюджетом случайных погрешностей приёмного тракта (раздел~\ref{sec:error-budget}):
после устранения систематического смещения двухимпульсной калибровкой остаточная ошибка
складывается в основном из джиттера компаратора и составляет $\sigma_d \approx 3$~мм. Это
значение используется в расчётах ниже.

На рис.~\ref{fig:gdop-anchor-distance} представлена зависимость ошибки позиционирования от взаимного расположения якорей при фиксированной ошибке измерения $\sigma_d = 3$ мм и высоте объекта $H = 25$ м.

\begin{figure}[h!]
    \centering
    
    \caption{Зависимость ошибки позиционирования от геометрии расположения якорей}
    \label{fig:gdop-anchor-distance}
\end{figure}

\paragraph{Оценка погрешности.}
Рассмотрим характерные параметры системы: высота объекта $H = 25$ м, расстояние между якорями $a = 2$ м. В этом случае:
\begin{itemize}
  \item систематическая ошибка измерения расстояния приводит к смещению оценки порядка $3$ см;
  \item случайная ошибка измерений с учётом эффекта GDOP приводит к СКО порядка $5$ см.
\end{itemize}
Таким образом, суммарная ошибка позиционирования в худшем случае может достигать порядка $8$ см.

\subsection{Методы решения задачи трилатерации}
\label{sec:trilateration}
Для получения координат БПЛА при известных расстояниях до якорей необходимо решить задачу трилатерации.
Для её решения в настоящей работе рассмотрены два метода: аналитический и вычислительный метод Гаусса--Ньютона. В экспериментах
оба метода дали практически идентичную точность,
поэтому предпочтение отдано аналитическому методу как вычислительно более простому (замкнутое решение без итераций).

\subsubsection{Аналитическое решение задачи трилатерации в пространстве по трём расстояниям}

Задача определения координат по трём известным расстояниям имеет замкнутое
решение через пересечение трёх сфер~\cite{manolakis1996}.

Пусть заданы три опорные точки в плоскости \(z=0\):
\[
P_1 = (x_1, y_1, 0), \qquad
P_2 = (x_2, y_2, 0), \qquad
P_3 = (x_3, y_3, 0),
\]
и измеренные расстояния от неизвестной точки \(P=(x,y,z)\) до них:
\[
r_1,\; r_2,\; r_3.
\]

\paragraph{1. Уравнения сфер.}
Координаты точки \(P\) удовлетворяют системе уравнений трёх сфер:
\[
(x - x_i)^2 + (y - y_i)^2 + z^2 = r_i^2, \qquad i = 1,2,3.
\]

\paragraph{2. Получение линейной системы для координат \(x\) и \(y\).}
Вычтем уравнения для \(i=2\) и \(i=3\) из уравнения для \(i=1\).
Так как член \(z^2\) присутствует во всех трёх уравнениях, он сокращается. Получаем:
\begin{align}
2(x_2-x_1)x + 2(y_2-y_1)y &= r_1^2 - r_2^2 + x_2^2 - x_1^2 + y_2^2 - y_1^2, \\
2(x_3-x_1)x + 2(y_3-y_1)y &= r_1^2 - r_3^2 + x_3^2 - x_1^2 + y_3^2 - y_1^2.
\end{align}
В матричной форме:
\[
A
\begin{pmatrix} x \\ y \end{pmatrix}
=
\begin{pmatrix} b_1 \\ b_2 \end{pmatrix},
\]
где
\[
A =
\begin{pmatrix}
2(x_2-x_1) & 2(y_2-y_1) \\
2(x_3-x_1) & 2(y_3-y_1)
\end{pmatrix},
\]
\[
b_1 = r_1^2 - r_2^2 + x_2^2 - x_1^2 + y_2^2 - y_1^2,
\qquad
b_2 = r_1^2 - r_3^2 + x_3^2 - x_1^2 + y_3^2 - y_1^2.
\]
Если опорные точки не коллинеарны, то \(\det A \neq 0\), и система имеет единственное решение:
\[
\begin{pmatrix} x \\ y \end{pmatrix} = A^{-1} \begin{pmatrix} b_1 \\ b_2 \end{pmatrix}.
\]

\paragraph{3. Определение координаты \(z\).}
После нахождения \(x\) и \(y\) подставим их в первое уравнение сферы:
\[
z^2 = r_1^2 - (x - x_1)^2 - (y - y_1)^2.
\]
Отсюда:
\[
z = \pm\sqrt{\,r_1^2 - (x - x_1)^2 - (y - y_1)^2\,}.
\]
Если
\[
r_1^2 - (x - x_1)^2 - (y - y_1)^2 < 0,
\]
то система не имеет действительных решений (данные несовместны).
Поскольку сферы симметричны относительно плоскости \(z=0\), существует максимум два решения, соответствующие различным знакам корня.
В данной задаче выбирается решение с положительной высотой: \(z > 0\).

\paragraph{4. Итоговое решение.}
Искомая точка пересечения сфер:
\[
P = (x, y, z),
\]
где \((x,y)\) находятся из линейной системы
\[
A\begin{pmatrix}x\\y\end{pmatrix} = \begin{pmatrix}b_1\\b_2\end{pmatrix},
\]
а координата \(z\) определяется как
\[
z = \sqrt{\,r_1^2 - (x - x_1)^2 - (y - y_1)^2\,}.
\]
При этом берётся корень со знаком «плюс», так как требуется решение с \(z>0\).

\subsubsection{Метод Гаусса--Ньютона}

Этот метод используется для минимизации суммы квадратов; с учётом нашей задачи
функция для минимизации будет выглядеть следующим образом:
\[
\boxed{%
\; \min_{\mathbf{p}}\; J(\mathbf{p}), \qquad
J(\mathbf{p}) = \sum_{i=1}^{N} w_i\bigl(\,\hat r_i - \|\mathbf{p}-\mathbf{a}_i\|\,\bigr)^2
}
\]
\begin{itemize}
  \item $\hat r_i$ \;— измеренное расстояние от якоря $i$ до объекта;
  \item $\mathbf{a}_i$ \;— вектор координат $i$-го якоря;
  \item $\mathbf{p}$ \;— вектор неизвестных координат объекта;
  \item $w_i$ \;— вес измерения $i$ (обычно обратный дисперсии);
  \item $J(\mathbf{p})$ \;— целевая функция суммы взвешенных квадратов невязок.
\end{itemize}

Подробное изложение метода выходит за рамки настоящей работы; его описание можно найти в~\cite{nocedal2006}.
В качестве начального приближения целесообразно использовать предыдущую позицию БПЛА
или данные инерциальной навигационной системы: при хорошем начальном приближении метод
сходится за единичное число итераций, что обеспечивает низкие вычислительные затраты.

\subsubsection{Сравнительный анализ}
Для сравнения точности этих методов был проведён численный эксперимент в программе на Python.

\paragraph{Постановка эксперимента.}
Рассмотрим конфигурацию из 4 якорей, расположенных по углам квадрата со стороной 2 метра, далее:
\begin{itemize}
    \item выбираем случайные координаты БПЛА, примерно в 25 метрах над платформой;
    \item измеряем расстояния от объекта до якорей;
    \item подмешиваем в расстояния систематическую и случайную ошибку;
    \item передаём расстояния в вычислительные методы и получаем результат;
    \item вычисляем ошибку координат.
\end{itemize}
Эксперимент с 5 якорями проводится аналогично, пятый якорь добавляется в центр квадрата.

Аналитический метод предполагает известные расстояния только до трёх точек, поэтому мы будем вычислять
координаты для каждой тройки точек в отдельности (рис.~\ref{fig:triplet-selection}).

\begin{figure}[h!]
\centering

\caption{Выбор троек якорей для аналитического решения}
\label{fig:triplet-selection}
\end{figure}

Далее полученные координаты усредняем по всем тройкам.

Вычислительный же метод работает следующим образом: в качестве начального приближения берётся
аналитическое решение по любой из троек, далее следуют итерации метода Гаусса--Ньютона,
учитывающие расстояние до всех якорей.

\paragraph{Результаты.}
Систематическая ошибка одинаково влияет на точность аналитического и вычислительного метода,
поэтому в экспериментах она имеет фиксированное значение ${\sim}0{,}13\%$.
Посмотрим на точность методов в зависимости от случайной ошибки
(рис.~\ref{fig:error-vs-variance}); каждая точка на графике соответствует средней
ошибке по 50 измерениям.

\begin{figure}[h!]
\centering

\caption{Зависимость средней ошибки позиционирования от СКО случайной ошибки измерения}
\label{fig:error-vs-variance}
\end{figure}

\begin{itemize}
  \item \textbf{4 якоря:} результаты почти одинаковые.
  \item \textbf{5 якорей:} аналитический метод показывает себя лучше при больших значениях ошибки и хуже при малых.
Ухудшение точности на малых ошибках можно объяснить тем, что в конфигурации из 5 якорей существуют тройки,
где якоря находятся ближе друг к другу. Это повышает GDOP-ошибку и ухудшает общий результат при усреднении.
\end{itemize}

В таблицах~\ref{tab:tri-analytic} и~\ref{tab:tri-gn} приведены средние значения ошибки по 1000 измерений в зависимости от разных значений случайной ошибки.
\begin{table}[h!]
  \centering
  \begin{minipage}{0.48\textwidth}
    \centering
    \caption{Аналитический метод}
    \label{tab:tri-analytic}
    \begin{tabular}{|c|c|c|}
        \hline
        $\sigma$, м & 4 якоря, см & 5 якорей, см \\
        \hline
        0.002 & 3.53 & 15.96 \\
        \hline
        0.003 & 4.61 & 15.87 \\
        \hline
        0.005 & 6.98 & 16.20 \\
        \hline
        0.01 & 13.11 & 19.00 \\
        \hline
        0.05 & 62.01 & 58.44 \\
        \hline
        0.1 & 129.70 & 115.59 \\
        \hline
    \end{tabular}
  \end{minipage}%
  \hspace{0.04\textwidth}%
  \begin{minipage}{0.48\textwidth}
    \centering
    \caption{Метод Гаусса--Ньютона}
    \label{tab:tri-gn}
    \begin{tabular}{|c|c|c|}
        \hline
        $\sigma$, м & 4 якоря, см & 5 якорей, см \\
        \hline
        0.002 & 3.57 & 3.56 \\
        \hline
        0.003 & 4.60 & 4.63 \\
        \hline
        0.005 & 7.06 & 6.83 \\
        \hline
        0.01 & 12.86 & 13.15 \\
        \hline
        0.05 & 61.81 & 63.82 \\
        \hline
        0.1 & 124.40 & 127.19 \\
        \hline
    \end{tabular}
  \end{minipage}
\end{table}

В нашей системе случайная ошибка измерения дальности составляет $\sigma_d \approx 3$~мм
(раздел~\ref{sec:error-budget}); по приведённым данным (строка $\sigma=0{,}003$) и оценке GDOP
это соответствует полной ошибке позиционирования порядка 5 см, что укладывается в теоретические оценки.

Аналитический метод вычислительно проще метода Гаусса--Ньютона, и оптимально использовать именно его
на конфигурации из 4 якорей.
\FloatBarrier
