egormeister02/Ultrasonic-LNS/(commit log)

2026-03-04 fix: switch to fontspec + DejaVu for Cyrillic support
    - Replaced T2A/fontenc + babel with fontspec
    - Added DejaVu fonts (Serif, Sans, Mono)
    - Fixed malformed \paragraph{}\ to \paragraph{}
    - Document now compiles with lualatex
2026-04-02 Добавлен расчет погрешности скорости звука от датчиков температуры, давления и влажности
2026-04-02 Добавлен развернутый расчет погрешности модели скорости звука с обоснованием составляющих и проверкой по табличным данным
2026-04-02 mipt: добавить слайд Linear Loss (L1)
2026-04-02 add: simulation.py, plot_error.py с зависимостью ошибки от variance
2026-04-03 del: убрать linear loss; range: до 0.2м; ppt: график вместо таблицы
2026-04-03 ppt: заменить таблицу на график error_vs_variance
2026-04-03 add: table_error.py скрипт для генерации таблиц
2026-04-03 add: слайд с таблицами погрешности
2026-04-03 update: таблицы с n=1000
2026-04-07 Add: прототип для настройки частоты драйвера (STM32F401)
2026-04-07 Update: H-bridge режим (dual PWM на IN1/IN2)
2026-04-08 fix: ADC_MAX 4095->1023, исправить инициализацию PWM для PB6/PB7
    [ultrasonic_driver.ino]
2026-04-08 fix: исправить API вызовы для STM32 (OUTPUT_AF, PWM, setCaptureCompare)
    [ultrasonic_driver.ino]
2026-04-10 fix us driver code
    [ultrasonic_driver.ino]
2026-04-16 Fix text overflow: reduced font to 11pt, increased margins to 2.5cm, added babel and microtype
2026-04-20 fix text errors; add enviroment for circuit
2026-04-22 fix: исправить замечания рецензента в тексте диплома
    - Расшифровать аббревиатуры ToF и TDoA
    - Исправить несогласованные формы («зависимы» → «зависима», «восприятия» → «измерения»)
    - Добавить «воды» к «тройной точке», «величины» к «на основе скорости звука»
    - Исправить список параметров: тире → «---», значения в math mode, SPL расшифровано
    - Убрать лишнюю запятую («позиции, и сопровождения»), д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
2026-04-22 add: раздел 4 «Реализация» — схема обработки сигнала якоря
    Перенесён из ветки claw на базу master (с исправлениями рецензента).
    Включает: предусилитель INA128P, полосовой фильтр TL072CN,
    детектор огибающей, компаратор LM358P с принципиальными схемами CircuitikZ.
2026-04-22 docs: добавить актуальный PDF диплома
2026-04-22 refactor: переработать структурную схему и раздел усилителя
    - Структурная схема: 5 блоков → 4 (Предусилитель, Усилитель, Демодулятор)
    - Исправлена ошибка: ОУ-A теперь ФНЧ, ОУ-B — ФВЧ
    - Каскады усилителя объединены в одну схему вместо двух minipage
    - Детектор огибающей и компаратор объединены в раздел «Демодулятор»
    - Схема демодулятора перерисована без minipage, исправлен гистерезис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
2026-05-06 add: раздел 4 «Реализация» — узел БПЛА, питание якоря, BOM, эксперимент
    - узел БПЛА: ESP32 + DWM1000 + SN74HC4066 + TC4427A + MA40S4S, аппаратная
    синхронизация EXTTXE, активное гашение пьезоизлучателя через мост
    - узел якоря: переработан тракт усиления (TL072 как НИУ с входными ФНЧ/ФВЧ
    на 23/27 кГц), компаратор LM311P, германиевый диод Д9Б в детекторе огибающей
    - питание якоря: A2412S-2WR3, входной феррит+LC, выходные LC-фильтр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
2026-06-16 финальная версия диплома: дальность приёма ≈40 м, уточнение терминологии
